PeterBee97/Gradesign/毕业论文/thuthesis-v6.0.2/data/denotation.tex

% !TeX root = ../main.tex

\begin{denotation}[3cm]
\item[ICRA] 国际机器人与自动化会议 (International Conference on Robotics and Automation)
\item[SEA] 串联弹性驱动 (Series-Elastic Actuation)
\item[SMA] 形状记忆合金 (Shape Memory Alloy)
\item[KV值] 每V电压对应无刷电机转数(rpm)
\item[BOM] 材料清单 (Bill Of Materials) 
\item[CNC] 数字控制加工
\item[EPFL] 瑞士洛桑联邦理工学院 
\item[FOC] 磁场定向控制 (Field Oriented Control)
\item[UART] 通用异步收发传输器 (Universal Asynchronous Receiver/Transmitter), 俗称串口通信
\item[PWM] 脉冲宽度调制(Pulse Width Modulation)
\item[MIPI] 移动产业处理器接口 (Mobile Industry Processor Interface) 
\item[PID] 比例积分微分
\item[UI] 用户界面 (User Interface) 
\item[CRC] 循环冗余校验 (Cyclic Redundancy Check)
\item[ABS] 丙烯腈-丁二烯-苯乙烯塑料 
\end{denotation}
