PeterBee97/Gradesign/毕业论文/thuthesis-v6.0.2/data/chap01.tex

% !TeX root = ../main.tex

\chapter{引言}
\label{cha:intro}

\section{研究背景}
近些年来，机器人研究的方向逐渐从大型机械、传统制造转向小型化、快速制造、精细控制、人机交互等方面，仿生设计也始终是热门关注点。传统的轮式机器人已经比较成熟，而不能满足复杂地形的需要，因此足式机器人引发了许多研究者的关注。这方面进展最快的莫过于四足机器人，上至波士顿动力的Spot机器狗\cite{Spot}，下至斯坦福本科生开发的低成本开源四足机器人Doggo\cite{Doggo}，大有全民机器狗之势。而其他形式的仿生机器人研究也并未式微，如普渡大学的机器蜂鸟\cite{Hummingbird}，斯坦福的单足跳跃机器人Salto-1P\cite{Salto1P}，都是小型机器人的优秀代表，后者更是亮相ICRA 2019，与众多机器狗同台竞技，业内人称“蒙特利尔动物园”。

\section{相关研究}
\label{sec:first}
\subsection{Salto}
本项目的直接灵感来自于Salto-1P。Salto-1P是来自加州大学伯克利分校仿生微系统实验室的跳跃机器人。
\begin{figure}[H]
  \centering
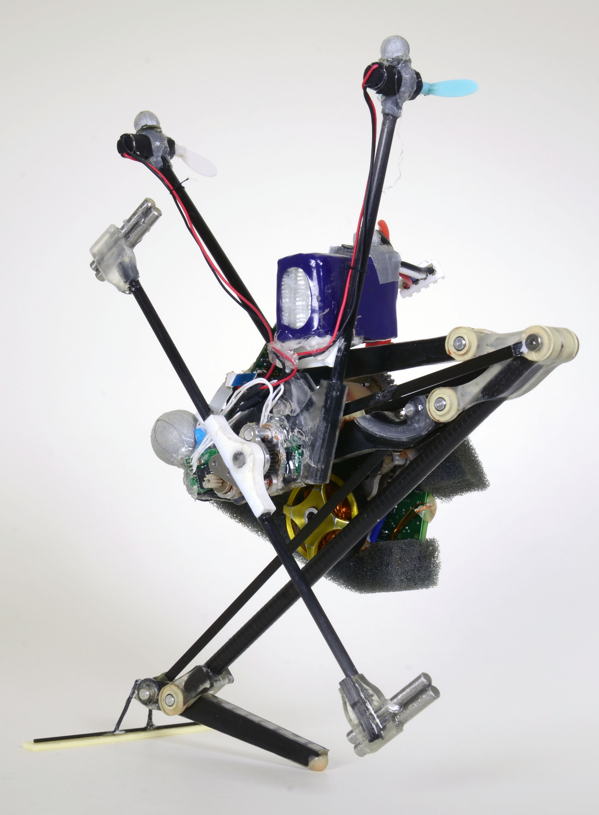
[picture p58: 毕业论文/thuthesis-v6.0.2/figures/Salto-1P.jpg]
  
  \caption{Salto-1P机器人\cite{Salto1P}}
  \label{fig:salto-1p}
\end{figure}
Salto-1P的主要特点是通过SEA驱动结构实现了能量的存储，以保证跳跃瞬间的能量爆发。它可以每0.58秒进行一次高度1m的连续跳跃，这样的敏捷性无疑是惊人的。初代Salto\cite{Salto}腿长约15cm，重约100g，能量密度137W/kg，各方面指标已经接近或超越其设计之初的模仿对象——自然界的夜猴。为了实现精确控制，Salto身上装备了用于控制姿态的尾部，Salto-1P还配备了一对螺旋桨。前者在研究中只进行一次跳跃，而后者由于通过两个螺旋桨控制横滚(Roll)和偏航(Yaw)，再加上尾部对俯仰(Pitch)的控制，实现了对空中身体姿态三个自由度的完全操控，因此可以做到连续跳跃。\\
对本项目的启示：
\begin{itemize}
  \item 本项目的弹跳部分设计参照了Salto腿部的机械模式，以提供有利于弹跳的机械增益曲线。
\end{itemize}
\subsection{Multimo-bat}
Multimo-bat多模态蝙蝠机器人是CMU机械系一位博士生2014年的作品。  
\begin{figure}[H]
  \centering
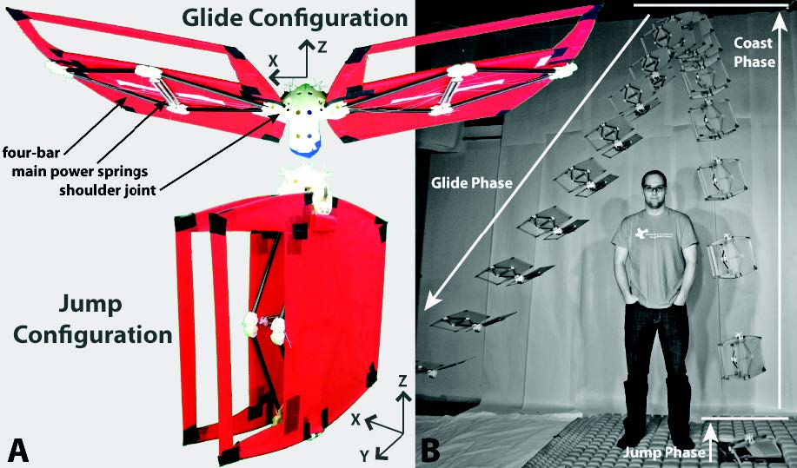
[picture p59: 毕业论文/thuthesis-v6.0.2/figures/Multimo-bat.jpg]
  
  \caption{Multimo-bat机器人\cite{multimo}}
  \label{fig:multimo}
\end{figure}
如图\ref{fig:multimo}所示，该机器人主要拥有两个形态：跳跃态和滑翔态。其主要结构由身体和四连杆可折叠机翼构成。一个完整的跳跃滑翔运动过程如下：
\begin{enumerate}
  \item 图\ref{fig:multimo_struct}(a)中的主电机转动带动图中白线拉紧，此时四连杆收缩，电能转化为翼上弹簧的弹性势能存储起来。当收紧到一定程度后，触发内部结构的离合装置，充能完毕。
  \item 图\ref{fig:multimo_struct}(b)中的SMA丝通电发热收缩拉动离合器解锁，机翼快速弹回原位，弹簧释放能量，机器人跳起。
  \item 当机器人跳至最高点时，张开机翼，进入无动力滑翔模式。
\end{enumerate}
对本项目的启示：
\begin{itemize}
  \item 该项目的整体功能与本项目目标基本相同，其滑翔模式下通过控制重心来调整机翼攻角而不增加自由度的思想可以简化系统设计，增加鲁棒性。
\end{itemize}
\begin{figure}[h]
  \centering%
  \begin{subfigure}{6cm}
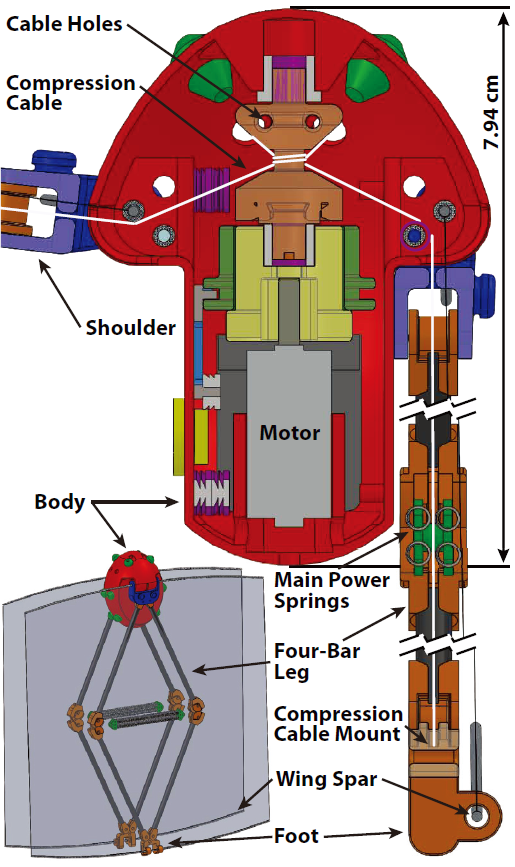
[picture p60: 毕业论文/thuthesis-v6.0.2/figures/Multimo-bat_Structure.png]
    
    \caption{整体结构}
  \end{subfigure}%
  \hspace{3em}%
  \begin{subfigure}{0.5\textwidth}
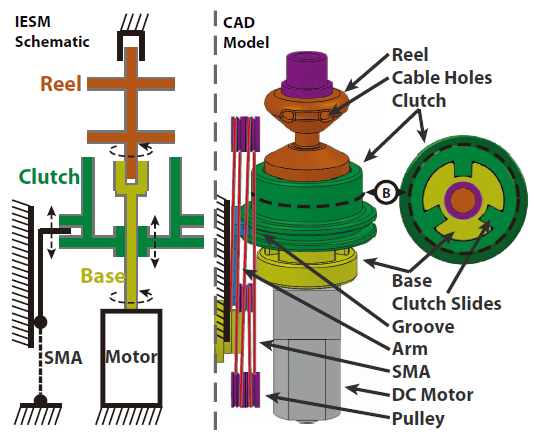
[picture p61: 毕业论文/thuthesis-v6.0.2/figures/Multimo-bat_Structure2.png]
    
    \caption{离合器}
  \end{subfigure}
  \caption{Multimo-bat主要结构\cite{multimo}}
  \label{fig:multimo_struct}
\end{figure}

\subsection{EPFL Jumpglider}
图\ref{fig:EPFL}是由瑞士洛桑联邦理工学院制作的Jumpglider机器人。
\begin{figure}[H]
  \centering
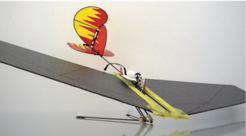
[picture p62: 毕业论文/thuthesis-v6.0.2/figures/EPFL.png]
  
  \caption{EPFL Jumpglider滑翔机器人\cite{EPFL}}
  \label{fig:EPFL}
\end{figure}
该机器人主要用于探究滑翔背后的数学原理，这也比较符合欧洲研究的一贯风格。该文章提出了三种仿生设计的折叠机翼原理，而最终得出结论固定翼滑翔距离较远。而出于仿生及紧致度的要求，固定翼方案不适用；本项目选择了蝴蝶式机翼收缩机制，以取得机械复杂度与鲁棒性的折衷。图\ref{fig:EPFL_leg}是EPFL对该机器人腿部的设计，大量使用塑料齿轮与铝合金构件与直流电机，由于该机器人使用场景为从高处下落，故这样的设计满足需求。但对于本项目而言，直流电机不足以提供足够原地起跳的爆发力，因此该设计仅供参考。
\begin{figure}[H]
  \centering
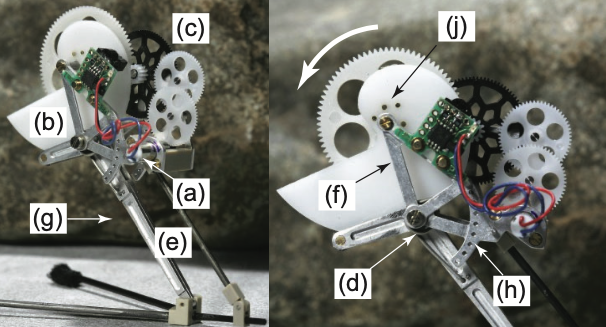
[picture p63: 毕业论文/thuthesis-v6.0.2/figures/EPFL_leg.png]
  
  \caption{Jumpglider腿部设计\cite{EPFL}}
  \label{fig:EPFL_leg}
\end{figure}
对本文的启示：
\begin{itemize}
  \item 分析比较了不同滑翔翼折叠机制的优劣；给出了一种弹射装置的参考设计。
\end{itemize}
