PeterBee97/Gradesign/毕业论文/thuthesis-v6.0.2/spine.tex

\documentclass[degree=master]{thuthesis}
\thusetup{
  author = {毕骏达},
  title  = {小型仿生跳跃滑翔运动装置}
}

\begin{document}

\spine % 使用默认标题和默认作者

\spine[小型仿生跳跃滑翔运动装置]

%\spine[同时修改标题和作者的标题][尼瑞薛]

% 中英文混合时需要微调
%\spine[清华大学学位 \raisebox{-5pt}{\LaTeX} 论文模板 \raisebox{-5pt}{v\version} 样例]
\end{document}
