PeterBee97/Gradesign/毕业论文/thuthesis-v6.0.2/data/acknowledgements.tex

% !TeX root = ../main.tex

\begin{acknowledgements}
  第一次独立挑战完整的系统设计项目，希望以此对本科期间学到的知识与技能做一个总结。虽然由于种种原因功能实现上留下了遗憾，但这个项目还是我心中本科毕业的里程碑。
  衷心感谢导师孙忆南老师对本项目的鼓励与指导。重点感谢我的父亲，是我制造机器人的得力助手，解决了许多加工问题。感谢母亲大人在疫情期间为我提供的后勤保障，使我可以安心完成毕业设计。感谢CMU仿生机器人实验室的李路前辈，在之前访学期间给予我的指导与帮助，没有那段经历就没有这个项目。感谢我的女朋友黄馨仪小可爱无时不在的精神支持！感谢实验中心全体老师，本科期间对我的实验能力的培养。特别感谢张寒学姐，对我的人生选择影响深远。感谢电子系科协，天空工场，和这一路遇到的所有同学，是你们让我成为了今天的自己。
  另外要感谢徐紫仪同学友情赠送的显卡，使得我的KVM黑苹果有了免驱的直通显卡，可以流畅地使用macOS编译\LaTeX{}，比Windows平台快了一倍。
\end{acknowledgements}
