PeterBee97/Gradesign/毕业论文/thuthesis-v6.0.2/thuthesis.pdf

# THUTHESIS：清华大学学位论文模板

## 薛瑞尼

## xueruini@gmail.com

v6.0.2 (2020/02/23)

摘要

此宏包旨在建立一个简单易用的清华大学学位论文模板，包括本科综合论文训练、硕士论文、博士论 文以及博士后出站报告。

免责声明

1. 本模板的发布遵守 LATEX Project Public License，使用前请认真阅读协议内容。
2. 本模板为作者根据清华大学教务处颁发的 《综合论文训练写作指南》，清华大学研究生院颁发 (http://www.law.tsinghua.edu.cn/publish/law/7024/2012/20120216153516317135347/20120216153516317135347_.html) 的《研究生学位论文写作指南》，清华大学 (http://yjsy.cic.tsinghua.edu.cn/docinfo/board/boarddetail.jsp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)《编写“清华大学博士后研究报告”参考意见》编 (http://postdoctor.tsinghua.edu.cn/info/czxz/1283) 写而成，旨在供清华大学毕业生撰写学位论文使用。
3. 清华大学教务处和研究生院只提供毕业论文写作指南，不提供官方模板，也不会授权第三方模 板为官方模板，所以此模板仅为写作指南的参考实现，不保证格式审查老师不提意见。任何由 于使用本模板而引起的论文格式审查问题均与本模板作者无关。
4. 任何个人或组织以本模板为基础进行修改、扩展而生成的新的专用模板，请严格遵守 LATEX Project Public License 协议。由于违犯协议而引起的任何纠纷争端均与本模板作者无关。

目录 | 目录
目录
1 模板介绍 | 3
2 安装 | 3
3 使用说明 | 5
4 致谢 | 22
5 实现细节 | 23
5.5.8 浮动对象以及表格 . . . . | 38
5.9.1 hyperref 宏包 . . . . | 64
5.9.3 longtable 宏包 . . . | 66
5.9.5 ntheorem 宏包 . . . . | 67
6 索引 | 67

2 安装

## 1 模板介绍

THUTHESIS (Tsinghua University LATEX Thesis Template) 是为了帮助清华大学毕业生撰写毕 业论文而编写的 LATEX 论文模板。
本文档将尽量完整的介绍模板的使用方法，如有不清楚之处，或者想提出改进建议，可以在 GitHub Issues (https://github.com/xueruini/thuthesis/issues/) 参与讨论或提问。有兴趣者都可以参与完善此手册，也非常欢迎对代码的贡献。 注意：模板的作用在于减少论文写作过程中格式调整的时间。前提是遵守模板的用法，否则 即便用了 THUTHESIS 也难以保证输出的论文符合学校规范。
用户如果遇到 bug，或者发现与学校《写作指南》的要求不一致，可以尝试以下办法：
1. 将模板升级到最新，见第 2.4 节；
2. 阅读 FAQ； (https://github.com/xueruini/thuthesis/wiki/FAQ)
3. 在 GitHub Issues 中按照说明 报告 bug。 (https://github.com/xueruini/thuthesis/issues/new?template=bug_report.md)

## 2 安装

THUTHESIS 已经包含在主要的 TEX 发行版中，但是通常版本较旧，而且不方便更新。建议使

### 用 GitHub 上的最新版：https://github.com/xueruini/thuthesis。

模板支持在 TeX Live、MacTeX 和 MiKTeX 平台下进行编译，但要求 2017 年或更新的发行 版。当然，尽可能使用最新的版本可以避免 bug。

### 2.1 模板的组成

下表列出了 THUTHESIS 的主要文件及其功能介绍：

文件（夹） | 功能描述
thuthesis.ins | DOCSTRIP 驱动文件（开发用）
thuthesis.dtx | DOCSTRIP 源文件（开发用）
thuthesis.cls | 模板类文件
thuthesis-numeric.bst | 参考文献样式文件
thuthesis-author-year.bst | 参考文献样式文件
thuthesis-bachelor.bst | 参考文献样式文件
tsinghua.pdf | 校名 logo，系统无隶书字体时使用
main.tex | 示例文档主文件
spine.tex | 书脊示例文档
ref/ | 示例文档参考文献目录
data/ | 示例文档章节具体内容
figures/ | 示例文档图片路径
thusetup.tex | 示例文档基本配置
Makefile | Makefile

2.2 生成模板 | 2 安装
文件（夹） | 功能描述
latexmkrc | latexmk 配置文件
README.md | Readme
thuthesis.pdf | 用户手册（本文档）

几点说明：

### - thuthesis.cls 可由 thuthesis.ins 和 thuthesis.dtx 生成，但为了降低新

手用户的使用难度，故将 thuthesis.cls 文件一起发布。

### - 使用前阅读文档：thuthesis.pdf。

### 2.2 生成模板

模板的源文件（thuthesis.dtx）中包含了大量的注释，需要将注释去掉生成轻量级的

### .cls 文件供 \documentclass 调用。

$ xetex thuthesis.ins

### 注意：如果没有生成的模板 thuthesis.cls 文件（跟 main.tex 同一目录下），LATEX

在编译时可能找到发行版中较旧版本的 .cls，从而造成冲突。

### 2.3 编译论文

本节介绍几种常见的生成论文的方法。用户可根据自己的情况选择。

### 2.3.1 GNU make

如果用户可以使用 GNU make 工具，这是最方便的办法。所以 THUTHESIS 提供了 Makefile：

$ make thesis | # 生成论文 main.pdf
$ make spine | # 生成书脊 spine.pdf
$ make doc | # 生成说明文档 thuthesis.pdf
$ make clean | # 清理编译生成的辅助文件

### 2.3.2 latexmk

latexmk 命令支持全自动生成 LATEX 编写的文档，并且支持使用不同的工具链来进行生成， 它会自动运行多次工具直到交叉引用都被解决。

$ latexmk main.tex | # 生成论文 main.pdf
$ latexmk spine.tex | # 生成书脊 spine.pdf
$ latexmk thuthesis.dtx # 生成说明文档 thuthesis.pdf
$ latexmk -c | # 清理编译生成的辅助文件

latexmk 的编译过程是通过 latexmk 文件来配置的，如果要进一步了解，可以参考 latexmk 的文档。

2.4 升级 | 3 使用说明

### 2.3.3 XƎLATEX

如果用户无法使用以上两种较为方便的编译方法，就只能按照以下复杂的办法手动编译。

$ xetex thuthesis.ins # 生成 thuthesis.cls
$ xelatex main.tex
$ bibtex main.tex | # 生成 bbl 文件
$ xelatex main.tex | # 解决引用
$ xelatex main.tex | # 生成完整的 pdf 文件

下面的命令用来生成用户手册，

$ xelatex thuthesis.dtx
$ makeindex -s gind.ist -o thuthesis.ind thuthesis.idx $ makeindex -s gglo.ist -o thuthesis.gls thuthesis.glo $ xelatex thuthesis.dtx
$ xelatex thuthesis.dtx # 生成说明文档 thuthesis.pdf

### 2.4 升级

如果需要升级THUTHESIS，应当从GitHub下载最新的版本，将thuthesis.dtx，thuthe-

### sis.ins，tsinghua.pdf 和 thuthesis-*.bst 拷贝至工作目录覆盖相应的文件，然后

按照第 2.2 节的内容生成新的模板和使用说明。
有时模板可能进行了重要的修改，不兼容已写好的正文内容，用户应按照示例文档重新调整。

## 3 使用说明

本手册假定用户已经能处理一般的 LATEX 文档，并对 BIBTEX 有一定了解。如果从未接触过 TEX 和 LATEX，建议先学习相关的基础知识。

### 3.1 示例文件

### 模板核心文件有：thuthesis.cls，thuthesis-numeric.bst，thuthesis-author-

year.bst 和 tsinghua.pdf，但如果没有示例文档会较难下手，所以推荐从模板自带的示 例文档入手。其中包括了论文写作用到的所有命令及其使用方法，只需用自己的内容进行相应替 换就可以。对于不清楚的命令可以查阅本手册。下面的例子描述了模板中章节的组织形式，来自 于示例文档，具体内容可以参考模板附带的 main.tex 和 data/。

% !TeX encoding = UTF-8
% !TeX program = xelatex
% !TeX spellcheck = en_US

\documentclass[degree=master,fontset=windows]{thuthesis} % 学位 degree:
% doctor | master | bachelor | postdoc
% 学位类型 degree-type:

3.1 示例文件 | 3 使用说明
% | academic（默认）| professional

% 论文基本配置，加载宏包等全局配置
\input{thusetup.tex}

\begin{document}

% 封面
\maketitle

% 使用授权的说明
\copyrightpage

\frontmatter
\input{data/abstract.tex}

% 目录
\tableofcontents

% 符号对照表
\input{data/denotation}

% 正文部分
\mainmatter
\input{data/chap01}
\input{data/chap02}

% 其它部分
\backmatter

%% 本科生要求的几个索引。
% \listoffigures | % 插图索引
% \listoftables | % 表格索引
% \listofequations | % 公式索引

% 参考文献
\bibliographystyle{thuthesis-numeric} | % 顺序编码制
% \bibliographystyle{thuthesis-author-year} | % 著者-出版年制
% \bibliographystyle{thuthesis-bachelor} | % 本科生参考文献的著录格式
\bibliography{ref/refs}

% 致谢

3.1 示例文件 | 3 使用说明

\input{data/acknowledgements}

% 声明
\statement

% 附录
\appendix
% \input{data/appendix-survey} | % 本科生：外文资料的调研阅读报告
% \input{data/appendix-translation} | % 本科生：外文资料的书面翻译
\input{data/appendix}

% 个人简历
\input{data/resume}

% 本科生的综合论文训练记录表
% \includepdf[pages=-]{scan-record.pdf}

\end{document}

其中 thusetup.tex 包括了论文基本信息的配置样例：

% !TeX root = ../main.tex

% 论文基本信息配置

\thusetup{
%****************************** % 注意：
% | 1. 配置里面不要出现空行
% | 2. 不需要的配置信息可以删除
%****************************** %
% 标题
% 可使用“\\”命令手动控制换行
%
title = {清华大学学位论文 \LaTeX{} 模板\\使用示例文档 v\version}, title* = {An Introduction to \LaTeX{} Thesis Template of Tsinghua University v\version},
%
% 学位
% | 1. 学术型
% | - 中文
% | 需注明所属的学科门类，例如：
% | 哲学、经济学、法学、教育学、文学、历史学、理学、工学、农学、医学、
% | 军事学、管理学、艺术学
% | - 英文
% | 博士：Doctor of Philosophy

3.1 示例文件 | 3 使用说明
% | 硕士：
% | 哲学、文学、历史学、法学、教育学、艺术学门类，公共管理学科
% | 填写“Master of Arts“，其它填写“Master of Science”
% | 2. 专业型
% | 直接填写专业学位的名称，例如：
% | 教育博士、工程硕士等
% | Doctor of Education, Master of Engineering
% | 3. 本科生不需要填写
%
degree-name = {工学硕士},
degree-name* = {Master of Science}, %
% 培养单位
% 填写所属院系的全名
%
department = {计算机科学与技术系},
%
% 学科
% | 1. 学术型学位
% | 获得一级学科授权的学科填写一级学科名称，其他填写二级学科名称
% | 2. 工程硕士
% | 工程领域名称
% | 3. 其他专业型学位
% | 不填写此项
% | 4. 本科生不需要填写
%
discipline = {计算机科学与技术},
discipline* = {Computer Science and Technology}, %
% 姓名
%
author = {薛瑞尼},
author* = {Xue Ruini},
%
% 指导教师
% 中文姓名和职称之间以英文逗号“,”分开，下同
%
supervisor = {郑纬民教授},
supervisor* = {Professor Zheng Weimin}, %
% 副指导教师
%
associate-supervisor = {陈文光教授}, associate-supervisor* = {Professor Chen Wenguang}, %
% 联合指导教师

3.1 示例文件 | 3 使用说明

%
% joint-supervisor = {某某某教授},
% joint-supervisor* = {Professor Mou Moumou}, %
% 日期
% 使用 ISO 格式；默认为当前时间
%
% date = {2019-07-07},
%
% 密级和年限
% 秘密, 机密, 绝密
%
% secret-level = {秘密},
% secret-year = {10},
%
% 博士后专有部分
%
% clc | = {分类号},
% udc | = {UDC},
% id | = {编号},
% discipline-level-1 = {计算机科学与技术}, % 流动站（一级学科）名称
% discipline-level-2 = {系统结构}, | % 专业（二级学科）名称
% start-date | = {2011-07-01}, | % 研究工作起始时间
}

%% Put any packages you would like to use here

% 表格中支持跨行
\usepackage{multirow}

% 跨页表格
\usepackage{longtable}

% 固定宽度的表格
\usepackage{tabularx}

% 表格中的反斜线
\usepackage{diagbox}

% 确定浮动对象的位置，可以使用 H，强制将浮动对象放到这里（可能效果很差） \usepackage{float}

% 浮动图形控制宏包。
% 允许上一个 section 的浮动图形出现在下一个 section 的开始部分 % 该宏包提供处理浮动对象的 \FloatBarrier 命令，使所有未处
% 理的浮动图形立即被处理。这三个宏包仅供参考，未必使用：

3.2 论文选项 | 3 使用说明

% \usepackage[below]{placeins}
% \usepackage{floatflt} % 图文混排用宏包
% \usepackage{rotating} % 图形和表格的控制旋转

% 定理类环境宏包
\usepackage[amsmath,thmmarks,hyperref]{ntheorem}

% 给自定义的宏后面自动加空白
% \usepackage{xspace}

% 借用 ltxdoc 里面的几个命令。
\def\cmd#1{\cs{\expandafter\cmd@to@cs\string#1}} \def\cmd@to@cs#1#2{\char\number`#2\relax} \DeclareRobustCommand\cs[1]{\texttt{\char`\\#1}}

\newcommand*{\meta}[1]{{%
\ensuremath{\langle}\rmfamily\itshape#1\/\ensuremath{\rangle}}} \providecommand\marg[1]{%
{\ttfamily\char`\{}\meta{#1}{\ttfamily\char`\}}} \providecommand\oarg[1]{%
{\ttfamily[}\meta{#1}{\ttfamily]}} \providecommand\parg[1]{%
{\ttfamily(}\meta{#1}{\ttfamily)}} \providecommand\pkg[1]{{\sffamily#1}}

% 定义所有的图片文件在 figures 子目录下
\graphicspath{{figures/}}

% 数学命令
\input{math_commands.tex}

% 定义自己常用的东西
% \def\myname{薛瑞尼}

% hyperref 宏包在最后调用
\usepackage{hyperref}

### 3.2 论文选项

degree | 选择学位，可选：bachelor，master，doctor（默认），postdoc。本节中的 key-value 选项只
能在文档类的选项中进行设置，不能用于 \thusetup 命令。

% 博士论文
\documentclass[degree=doctor]{thuthesis}

3.3 字体配置 | 3 使用说明

### 3.2.1 学位类型

定义研究生学位的类型，可选：academic（默认）、professional，本科生不受影响。

\documentclass[degree=master, degree-type=professional]{thuthesis}

language | 论文全文的主要语言。可选：chinese（默认），english。
注意，本科生《写作指南》要求“本科生 (含国外来华留学本科生) 非外语专业论文统一要求 用中文书写。”研究生《写作指南》要求“外国人来华留学生可以用英文撰写学位论文，但须采用 中文封面”，“除留学生外，学位论文一律须用汉语书写”，用户须提前与导师和院系的审查教师协 商使用何种语言书写论文。

\documentclass[degree=bachelor, language=english]{thuthesis}

### 3.3 字体配置

模板默认可以自动检测操作系统，并配置改平台上合适的字体，具体的配置策略如表 2。

表 2: THUTHESIS 自动配置字体策略
Windows | macOS | 其他

Times New Roman Times New Roman TeX Gyre Termes
Arial | Arial | TeX Gyre Heros
Courier | Menlo | TeX Gyre Cursor
中易宋体 | 华文宋体 | Fandol 宋体
中易黑体 | 华文黑体 | Fandol 黑体

然而自动配置的字体只能保证编译通过，但是还存在一些问题：
1. 在其他平台上配置的 TeX Gyre 系列字体，虽然在风格上比较接近 Times 和 Arial，但是毕 竟跟《写作指南》要求的字体不完全一致；
2. Fandol 字库的字形较少，常常出现缺字的情况；
3. 华文字库和 Fandol 字库虽然不违反《写作指南》的要求，但是其字形跟中易字库有所差别， 这导致封面、标题的视觉效果与学校的 Word 示例不一致，可能被审查老师认为格式不符合 要求。
所以建议在提交最终版前使用 Windows 平台的字体进行编译。
用户也可以在调用 THUTHESIS 时手动指定使用的字库，如：

\documentclass[fontset=windows]{thuthesis}

允许的选项有 windows、mac、fandol，详见 ctex、xeCJK、fontspec 等宏包的使用说 明。

### 3.4 封面信息

封面信息可以通过统一设置命令 \thusetup 设置 key=value 形式完成；带 * 号的键通常是 对应的英文。

3.4 封面信息 | 3 使用说明

\thusetup 用法与常见 key=value 命令相同，如下：
\thusetup
\thusetup{
key1 = value1,
key2 = {a value, with comma}, }
% 可以多次调用
\thusetup{
key3 = value3,
key1 = value11, % 覆盖 value1
}

注意：\thusetup 使用 kvsetkeys 机制，所以配置项之间不能有空行，否则会报错。

### 3.4.1 论文标题

中英文标题。可以在标题内部使用换行\\。

\thusetup{
title = {论文中文题目},
title* = {Thesis English Title}, }

### 3.4.2 申请学位名称

学位的设置要复杂一些：

学位类型 | degree-name | degree-name*
学术型博士 | 需注明所属的学科门类，例如：哲学、 经济学、法学、教育学、文学、历史学、 理学、工学、农学、医学、军事学、管 理学、艺术学 | Doctor of Philosophy
学术型硕士 | 同上 | 哲学、文学、历史学、法学、教育学、艺 术学门类，公共管理学科填写“Master of Arts“，其它填写“Master of Science”
专业型研究 生学位 | 专业学位的名称，例如：教育博士、工 程硕士 | 专业学位的名称，例如：Doctor of Ed- ucation, Master of Engineering
本科生 | - | -

\thusetup{
degree-name = {您要申请什么学位},
degree-name* = {Degree in English}, }

3.4 封面信息 | 3 使用说明

### 3.4.3 院系名称

院系名称。

\thusetup{
department = {系名全称},
}

### 3.4.4 学科名称

- 学术型学位：获得一级学科授权的学科填写一级学科名称，其他填写二级学科名称；
- 工程硕士：工程领域名称；
- 其他专业型学位：-
- 本科生：-

\thusetup{
discipline = {学科名称},
discipline* = {Discipline in English}, }

### 3.4.5 作者姓名

作者姓名。

\thusetup{
author = {中文姓名},
author* = {Name in Pinyin}, }

### 3.4.6 导师

导师 | 导师的姓名与职称之间以“,”（西文逗号，U+002C）隔开，下同。
| \thusetup{ supervisor = {导师姓名, 教授}, supervisor* = {Supervisor Name, Professor},

}

副导师 | 本科生的辅导教师，硕士的副指导教师。
| \thusetup{ associate-supervisor = {副导师姓名, 副教授}, associate-supervisor* = {Assoc-Supervisor Name, Professor},

}

联合导师 | 硕士生联合指导教师，博士生联合导师。
| \thusetup{ joint-supervisor = {联合导师姓名, 教授},

3.5 前言部分 | 3 使用说明

joint-supervisor* = {Join-Supervisor Name, Professor},
}

### 3.4.7 成文日期

默认为当前日期，也可以自己指定，要求使用 ISO 格式。

\thusetup{
date = {2011-07-01},
}

### 3.4.8 密级

定义秘密级别和年限。

\thusetup{
secret-year = 10,
secret-level = {内部},
}

### 3.4.9 博士后专用参数

\thusetup{
clc | = {分类号},
udc | = {udc},
id | = {id},
discipline-level-1 = {流动站（一级学科）名称}, discipline-level-2 = {专业（二级学科）名称},
start-date | = {2011-07-01}, % 研究工作起始时间
}
生成封面 | 生成封面，不含授权说明，摘要等。
\maketitle | % 直接生成封面

\maketitle

### 3.5 前言部分

### 3.5.1 授权说明

授权说明 | 生成授权说明。用法：\copyrightpage[⟨file⟩]。可选参数为扫描得到的 PDF 文件名，例
\copyrightpage | 如：

% 将签字扫描后授权文件 scan-auth.pdf 替换原始页面 \copyrightpage[scan-auth.pdf]

3.5 前言部分 | 3 使用说明

### 3.5.2 摘要

abstract 摘要正文

### abstract* 摘要直接在正文中使用 abstract、abstract* 环境生成。

\begin{abstract}
摘要请写在这里...
\end{abstract}

\begin{abstract*}
Here comes the abstract in English... \end{abstract*}
关键词 | 关键词需要使用 \thusetup 进行设置。关键词之间以西文逗号隔开，模板会自动调整为要
求的格式。关键词的设置只要在摘要环境结束前即可。

\thusetup{
keywords = {关键词 1, 关键词 2}, keywords* = {keyword 1, keyword 2},
}

### 3.5.3 目录和索引表

目录、插图、表格和公式等索引命令分别如下，将其插入到期望的位置即可（带 * 的命令表 示对应的索引表不会出现在目录中）：

\tableofcontents
\listoffigures
\listoffigures*
\listoftables
\listoftables*
\listofequations
\listofequations*
用途 | 命令
目录 | \tableofcontents

### 插图索引 \listoffigures

| \listoffigures*

### 表格索引 \listoftables

| \listoftables*

### 公式索引 \listofequations

| \listofequations*

LATEX 默认支持插图和表格索引，是通过 \caption 命令完成的，因此它们必须出现在浮动 环境中，否则不被计数。
如果不想让某个表格或者图片出现在索引里面，那么请使用命令 \caption*，这个命令不 会给表格编号，也就是出来的只有标题文字而没有“表 xx”，“图 xx”，否则索引里面序号不连续 就显得不伦不类，这也是 LATEX 里星号命令默认的规则。 有这种需求的多是本科同学的英文资料翻译部分，如果你觉得附录中英文原文中的表格和图 片显示成“表”和“图”很不协调的话，一个很好的办法还是用 \caption*，参数随便自己写，

3.5 前言部分 | 3 使用说明

具体用法请参看示例文档。
如果的确想让其编号，但又不想出现在索引中的话，目前模板暂不支持。 公式索引为本模板扩展，模板扩展了 amsmath 几个内部命令，使得公式编号样式和自动索 引功能非常方便。一般来说，你用到的所有数学环境编号都没问题了，这个可以参看示例文档。如 果你有个非常特殊的数学环境需要加入公式索引，那么请使用 \equcaption{⟨编号⟩}。此命 令表示 equation caption，带一个参数，即显示在索引中的编号。因为公式与图表不同，我们很 少给一个公式附加一个标题，之所以起这么个名字是因为图表就是通过 \caption 加入索引的， \equcaption 完全就是为了生成公式列表，不产生什么标题。
使用方法如下。假如有一个非 equation 数学环境 mymath，只要在其中写一句 \equcaption 就可以将它加入公式列表。

\begin{mymath}
\label{eq:emc2}\equcaption{\ref{eq:emc2}} E=mc^2
\end{mymath}

mymath 中公式的编号需要自己来做。
同图表一样，附录中的公式有时也不希望它跟全文统一编号，而且不希望它出现在公式索引 中。目前的办法是利用 \tag*{⟨公式编号⟩} 来解决。用法比较简单，此处不再罗嗦，实例请参 看示例文档附录 A 的前两个公式。

### 3.5.4 符号对照表

denotation | 主要符号表环境，跟 description 类似，使用方法参见示例文件。带一个可选参数，用
来指定符号列的宽度（默认为 2.5cm）。

\begin{denotation}
\item[E] 能量
\item[m] 质量
\item[c] 光速
\end{denotation}

如果默认符号列的宽度不满意，可以通过参数来调整：

\begin{denotation}[1.5cm] % 设置为 1.5cm \item[E] 能量
\item[m] 质量
\item[c] 光速
\end{denotation}

符号对照表的另外一种方法是调用 nomencl 宏包，需要在导言区设置：

\usepackage{nomencl}
\makenomenclature

然后在正文中任意位置使用 \nomenclature 声明需要添加到主要符号表的符号：

\nomenclature{$m$}{The mass of one angel}

3.6 正文部分 | | | | | | 3 使用说明

### 最后使用 \printnomenclature 命令生成符号表。更详细的使用方法参见 nomencl

宏包的文档。

### 3.6 正文部分

### 3.6.1 数学环境

THUTHESIS 定义了常用的数学环境：

axiom theorem | definition proposition lemma | conjecture
公理 | 定理 | 定义 | 命题 | 引理 | 猜想
proof | corollary example | exercise | assumption remark | problem
证明 | 推论 | 例子 | 练习 | 假设 | 注释 | 问题

比如：

\begin{definition}
道千乘之国，敬事而信，节用而爱人，使民以时。
\end{definition}

产生（自动编号）：

定义 1.1 道千乘之国，敬事而信，节用而爱人，使民以时。

列举出来的数学环境毕竟是有限的，如果想用胡说这样的数学环境，那么可以定义：

\newtheorem{nonsense}{胡说}[chapter]

然后这样使用：

\begin{nonsense}
契丹武士要来中原夺武林秘笈。—— 慕容博
\end{nonsense}

产生（自动编号）：

胡说 1.1 契丹武士要来中原夺武林秘笈。——慕容博

### 3.6.2 列表环境

itemize | 为了适合中文习惯，模板将这三个常用的列表环境用 enumitem 进行了纵向间距压缩。一

enumerate
description

方面清除了多余空间，另一方面用户可以自己指定列表环境的样式（如标签符号，缩进等）。细节 请参看 enumitem 文档，此处不再赘述。

### 3.6.3 引用方式

模板支持两种引用方式，分别为理工科常用的“顺序编码制”和文科常用的“著者-出版年制”。 使用者在设置参考文献表的格式（\bibliographystyle，见第 3.7.1 节）时，正文中引用文 献的标注会自动调整为对应的格式。

3.7 其他部分 | 3 使用说明

顺序编码制 顺序编码制的参考文献引用分为两种模式：
\inlinecite 1. 上标模式，比如“同样的工作有很多[1-2]……”；
2. 正文模式，比如“文 [3] 中详细说明了……”。
cite-style | 用户可以将引用标注的格式设为正文模式：

\thusetup{
cite-style = inline,
}

也可以使用 \inlinecite{⟨key⟩} 临时使用正文模式的引用标注。

著者-出版年制 著者-出版年制的参考文献引用有三种模式：
1. \citep：著者与年份均在括号中，比如“(Zhang, 2008)”，同默认的 \cite 命令；
2. \citet：著者姓名作为正文的一部分，比如“Zhang (2008)”；
3. \citeyear：只插入年份，但不含括号，比如“2008”。 关于参考文献引用的更多细节参考 natbib 的文档。

### 3.7 其他部分

### 3.7.1 参考文献

模板支持使用 BIBTEX 处理生成参考文献表，用户需要在文中设置参考文献格式并调用 .bib 数据库：

\bibliographystyle{thuthesis-numeric} | % 顺序编码制
% \bibliographystyle{thuthesis-author-year} | % 著者-出版年制
% \bibliographystyle{thuthesis-bachelor} | % 本科生参考文献的著录格式
\bibliography{ref1,ref2} | % 载入 ref1.bib 和 ref2.bib

### 注意：\bibliographystyle 命令只能出现一次。

BIBTEX 可以自动识别数据库中每条文献的语言，并自动处理文献类型和载体类型标识，用户 也可以手动指定，如：

@misc{citekey,
language = {japanese},
mark | = {Z},
medium | = {DK},
}

可选的语言有 english, chinese, japanese 和 russian。 国标规定参考文献表采用“著者-出版年”制组织时，各篇文献首先按文种集中，然后按著者 字顺和出版年排列；中文文献可以按著者汉语拼音字顺排列，也可以按著者的笔画笔顺排列。由 于 BIBTEX 功能的局限性，无法自动获取著者姓名的拼音或笔画笔顺，所以必须在 .bib 数据库中 的 key 字段手动录入著者姓名的拼音，如：

3.7 其他部分 | 3 使用说明

@book{capital,
author = {马克思 and 恩格斯},
key | = {ma3 ke4 si1 | en1 ge2 si1}, % 名字之间用 2 或 3 个空格
}

BIBTEX 对自定义样式的支持比较有限，所以用户只能通过修改 bst 文件来修改文献列表的 格式。本宏包提供了一些接口供用户更方便地修改，在 bst 文件开始处的 load.config 函数 中，有一组配置参数用来控制样式。若变量被设为 #1 则表示该项被启用，设为 #0 则不启用。默 认的值是严格遵循学校规定的配置。

### 3.7.2 致谢

acknowledgement | 把致谢做成一个环境更好一些，直接往里面写感谢的话就可以啦。

\begin{acknowledgements}
…
还要特别感谢 \thuthesis{} 节省了论文排版时间！ \end{acknowledgements}

### 3.7.3 声明

如果使用声明扫描页，将可选参数指定为扫描后的 PDF 文件名，例如： \statement
\statement[scan-statement.pdf]

### 3.7.4 附录

附录由 \appendix 命令开启，然后像正文一样书写。

\appendix
\chapter{...}
toc-depth | 一些院系要求目录中只出现附录的章标题，不出现附录中的一级、二级节标题。模板默认如
此设置，用户也可以在 \appendix 命令后手动控制加入目录的标题层级，其中 0 表示章标题， 1 表示一级节标题，以此类推。

\appendix
\thusetup{toc-depth=0} | % 目录只出现章标题
survey | 本科生《写作指南》要求附录 A 为外文资料的调研阅读报告或书面翻译，二者择一。调研报
translation 告（或书面翻译）的题目和参考文献是独立于论文的，相当一篇独立的小文章，所以模板相应定 义了 survey 和 translation。在这两个环境内部可以像论文正文一样使用标题和参考文献 的命令，但不会影响外部：

\begin{survey}
\title{...}

3.7 其他部分 | 3 使用说明

\maketitle
... \cite{...}
\bibliographystyle{...}
\bibliography{...}
\end{survey}

书面翻译对应的原文索引的实际作用更接近参考文献，所以也用参考文献的机制来生成，但 是在正文中并不引用。

\begin{translation}
... \nocite{...}
\bibliographystyle{...}
\bibliography{...}
\end{translation}

### 3.7.5 简历

resume | 开启个人简历章节，包括个人简历，发表文章，研究成果列表等。每个子项目请用以下对应
| 命令开启：\xxxitem{⟨subtitle⟩}。
| 个人简历，用法：\resumeitem{个人简历}。简历内容部分没有格式要求，正常段落排版。
\resumeitem | 发表学术论文，用法：\researchitem{⟨类别⟩}，包括“学术论文”和“研究成果”两个
\researchitem | 类别。分别用 publications 和 achievements 罗列。
publications | 用 publications 环境进行罗列发表的论文。按照学校要求，在学期间发表的学术论文分
\publicationskip | 以下三部分按顺序分别列出，每部分之间空 1 行，序号可连续排列：
1. 已经刊载的学术论文（本人是第一作者，或者导师为第一作者本人是第二作者）
2. 尚未刊载，但已经接到正式录用函的学术论文（本人为第一作者，或者导师为第一作者本人
| 是第二作者）。
3. 其他学术论文。可列出除上述两种情况以外的其他学术论文，但必须是已经刊载或者收到正
| 式录用函的论文。
| publications 环境支持每一部分分别编写，逻辑上更清楚，为了在环境之间支持空行，
| 需要利用 \publicationskip 控制。示例：
| \researchitem{发表的学术论文}
| % 1. 已经刊载的学术论文
| \begin{publications}
| \item Yang Y, Ren T L, Zhang L T, et al. Miniature microphone with
| silicon-based ferroelectric thin films. Integrated Ferroelectrics,
| 2003, 52:229-235. (SCI 收录, 检索号:758FZ.)
| \item 杨轶, 张宁欣, 任天令, 等. 硅基铁电微声学器件中薄膜残余应力的研究. 中国机
| 械工程, 2005, 16(14):1289-1291. (EI 收录, 检索号:0534931 2907.)
| \item 杨轶, 张宁欣, 任天令, 等. 集成铁电器件中的关键工艺研究. 仪器仪表学报,
| 2003, 24(S4):192-193. (EI 源刊.)
| \end{publications}

3.8 书脊 | 3 使用说明

% 2. 尚未刊载，但已经接到正式录用函的学术论文
\begin{publications}[before=\publicationskip,after=\publicationskip] \item Yang Y, Ren T L, Zhu Y P, et al. PMUTs for handwriting recognition. In press. (已被 Integrated Ferroelectrics 录用. SCI 源刊.) \end{publications}

% 3. 其他学术论文。
\begin{publications}
\item Wu X M, Yang Y, Cai J, et al. Measurements of ferroelectric MEMS microphones. Integrated Ferroelectrics, 2005, 69:417-429. (SCI 收录, 检索号:896KM)
\item 贾泽, 杨轶, 陈兢, 等. 用于压电和电容微麦克风的体硅腐蚀相关研究. 压电与声 光, 2006, 28(1):117-119. (EI 收录, 检索号:06129773469)
\item 伍晓明, 杨轶, 张宁欣, 等. 基于MEMS技术的集成铁电硅微麦克风. 中国集成电路, 2003, 53:59-61.
\end{publications}

### achievements 研究成果用 \researchitem{研究成果} 开启，随后用 achievements 环境罗列。 具体用法请参看示例文档 data/resume.tex。

### 3.8 书脊

生成装订的书脊，为竖排格式，命令格式：\spine[⟨标题⟩][⟨作者⟩]。默认参数为论文中 \spine 文题目和中文作者。如果中文题目中没有英文字母，那么直接调用此命令即可。否则，可参考参

看模板示例文件 spine.tex 进行微调：

\documentclass[degree=master]{thuthesis}

\thusetup{
author = {薛瑞尼},
title = {没有英文的中文标题}
}

\begin{document}

\spine % 使用默认标题和默认作者

\spine[使用默认作者的标题]

\spine[同时修改标题和作者的标题][尼瑞薛]

% 中英文混合时需要微调
\spine[清华大学学位 \raisebox{-5pt}{\LaTeX} 论文模板 \raisebox{-5pt}{v\version } 样例]
\end{document}

4 致谢

## 4 致谢

感谢这些年来一直陪伴 THUTHESIS 成长的新老同学！ 欢迎各位到 THUTHESIS GitHub 主页贡献！ (http://github.com/xueruini/thuthesis/)

5 实现细节

## 5 实现细节

### 5.1 基本信息

1 ⟨cls⟩\NeedsTeXFormat{LaTeX2e}
2 ⟨cls⟩\ProvidesClass{thuthesis}
3 ⟨cls⟩[2020/02/23 6.0.2 Tsinghua University Thesis Template]

检查编译引擎，要求使用 XƎLATEX。
4 \RequirePackage{ifxetex}
5 \RequireXeTeX

### 5.2 定义选项

定义论文类型以及是否涉密

6 ⟨*cls⟩
7 \hyphenation{Thu-Thesis}
8 \def\thuthesis{ThuThesis}
9 \def\version{6.0.2}
10 \RequirePackage{kvdefinekeys} 11 \RequirePackage{kvsetkeys} 12 \RequirePackage{kvoptions} 13 \SetupKeyvalOptions{
14 | family=thu,
15 | prefix=thu@,
16 | setkeys=\kvsetkeys}
| 用 kvoptions 的 key=value 方式来设置论文类型。

17 \newcommand\thu@error[1]{%
18 \ClassError{thuthesis}{#1}{}%

19 }

\thusetup 提供一个 \thusetup 命令支持 key-value 的方式来设置。

20 \newcommand\thusetup{%
21 \kvsetkeys{thu}%

22 }

| 同时用 key-value 的方式来定义这些接口：

\thu@define@key{
| <key> = {
| name = <name>,
| choices = {
| <choice1>,
| <choice2>,
| },
| default = <default>,
| code = <code>,
| },

5.2 定义选项 | 5 实现细节

}

其中 choices 设置允许使用的值，默认为第一个（或者 ⟨default⟩）；⟨code⟩ 是相应的内容被 设置时执行的代码。

23 \newcommand\thu@define@key[1]{%
24 \kvsetkeys{thu@key}{#1}%

25 }
26 \kv@set@family@handler{thu@key}{%

\thusetup 会将 ⟨value⟩ 存到 \thu@⟨key⟩，但是宏的名字包含“-”这样的特殊字符时 不方便直接调用，比如 key = math-style，这时可以用 name 设置 ⟨key⟩ 的别称，比如

### key = math@style，这样就可以通过 \thu@math@style 来引用。default 是定义该

⟨key⟩ 时默认的值，缺省为空。

27 | \@namedef{thu@#1@@name}{#1}%
28 | \def\thu@@default{}%
29 | \def\thu@@choices{}%
30 | \kv@define@key{thu@value}{name}{%
31 | \@namedef{thu@#1@@name}{##1}%
32 | }%
33 | \kv@define@key{thu@value}{code}{%
34 | \@namedef{thu@#1@@code}{##1}%
35 | }%

由于在定义接口时，\thu@⟨key⟩@@code 不一定有定义，而且在文档类/宏包中还有可能 对该 key 的 code 进行添加。所以 \thu@⟨key⟩@@code 会检查如果在定义文档类/宏包时则 推迟执行，否则立即执行。

36 | \@namedef{thu@#1@@check}{}%
37 | \@namedef{thu@#1@@code}{}%
38 | \@namedef{thu@#1@@hook}{%
39 | \expandafter\ifx\csname\@currname.\@currext-h@@k\endcsname\relax
40 | \@nameuse{thu@#1@@code}%
41 | \else
42 | \AtEndOfClass{%
43 | \@nameuse{thu@#1@@code}%
44 | }%
45 | \fi
46 | }%

保存下 choices = {} 定义的内容，在定义 \thu@⟨name⟩ 后再执行。

47 | \kv@define@key{thu@value}{choices}{%
48 | \def\thu@@choices{##1}%
49 | \@namedef{thu@#1@@reset}{}%

### \thu@⟨key⟩@check 检查 value 是否有效，并设置 \ifthu@⟨name⟩@⟨value⟩。

50 | \@namedef{thu@#1@@check}{%
51 | \@ifundefined{%

5.2 定义选项 | 5 实现细节
52 | ifthu@\@nameuse{thu@#1@@name}@\@nameuse{thu@\@nameuse{thu@#1@@name}}%
53 | }{%
54 | \thu@error{Invalid value "#1 = \@nameuse{thu@\@nameuse{thu@#1@@name}}"}%
55 | }%
56 | \@nameuse{thu@#1@@reset}%
57 | \@nameuse{thu@\@nameuse{thu@#1@@name}@\@nameuse{thu@\@nameuse{thu@#1@@name}}true}%
58 | }%
59 | }%
60 | \kv@define@key{thu@value}{default}{%
61 | \def\thu@@default{##1}%
62 | }%
63 | \kvsetkeys{thu@value}{#2}%
64 | \@namedef{thu@\@nameuse{thu@#1@@name}}{}%

第一个 ⟨choice⟩ 设为 ⟨default⟩，并且对每个 ⟨choice⟩ 定义 \ifthu@⟨name⟩@⟨choice⟩。

65 | \kv@set@family@handler{thu@choice}{%
66 | \ifx\thu@@default\@empty
67 | \def\thu@@default{##1}%
68 | \fi
69 | \expandafter\newif\csname ifthu@\@nameuse{thu@#1@@name}@##1\endcsname
70 | \expandafter\g@addto@macro\csname thu@#1@@reset\endcsname{%
71 | \@nameuse{thu@\@nameuse{thu@#1@@name}@##1false}%
72 | }%
73 | }%
74 | \kvsetkeys@expandafter{thu@choice}{\thu@@choices}%

将 ⟨default⟩ 赋值到 \thu@⟨name⟩，如果非空则执行相应的代码。

75 | \expandafter\let\csname thu@\@nameuse{thu@#1@@name}\endcsname\thu@@default
76 | \expandafter\ifx\csname thu@\@nameuse{thu@#1@@name}\endcsname\@empty\else
77 | \@nameuse{thu@#1@@check}%
78 | \@nameuse{thu@#1@@hook}%
79 | \fi

### 定义 \thusetup 接口。

80 | \kv@define@key{thu}{#1}{%
81 | \@namedef{thu@\@nameuse{thu@#1@@name}}{##1}%
82 | \@nameuse{thu@#1@@check}%
83 | \@nameuse{thu@#1@@hook}%
84 | }%

85 }

定义接口向 key 添加 code：

86 \newcommand\thu@addto[2]{%
87 \expandafter\g@addto@macro\csname thu@#1@@code\endcsname{#2}%

88 }

89 \newif\ifthu@degree@graduate
90 \newcommand\thu@set@graduate{%

5.2 定义选项 | 5 实现细节
91 | \thu@degree@graduatefalse
92 | \ifthu@degree@doctor
93 | \thu@degree@graduatetrue
94 | \fi
95 | \ifthu@degree@master
96 | \thu@degree@graduatetrue
97 | \fi

98 }
99 \thu@define@key{
100 | degree = {
101 | choices = {
102 | bachelor,
103 | master,
104 | doctor,
105 | postdoc,
106 | },
107 | default = doctor,
108 | code = {\thu@set@graduate},
109 | },
110 | degree-type = {
111 | choices = {
112 | academic,
113 | professional,
114 | },
115 | name = degree@type,
116 | },

论文是否使用英文。
117 | language = {
118 | choices = {
119 | chinese,
120 | english,
121 | },
122 | },

123 }

raggedbottom 选项（默认打开）
124 \DeclareBoolOption[true]{raggedbottom}

### 将选项传递给 ctexbook。

125 \DeclareDefaultOption{\PassOptionsToClass{\CurrentOption}{ctexbook}} 解析用户传递过来的选项，并加载 ctexbook。

126 \ProcessKeyvalOptions*

### 使用 ctexbook 类，优于调用 ctex 宏包。

127 \PassOptionsToPackage{quiet}{xeCJK}
128 \LoadClass[a4paper,openany,UTF8,zihao=-4,scheme=plain]{ctexbook}

5.3 装载宏包 | 5 实现细节

### 5.3 装载宏包

引用的宏包和相应的定义。
129 \RequirePackage{etoolbox}
130 \RequirePackage{xparse}

AℳS-TEX 宏包，用来排出更加漂亮的公式。
131 \RequirePackage{amsmath}

### 使用 unicode-math 处理数学字体。

132 \RequirePackage{unicode-math}

图形支持宏包。
133 \RequirePackage{graphicx}

### 并排图形。subfigure、subfig 已经不再推荐，用新的 subcaption。浮动图形和表格

标题样式。caption2 已经不推荐使用，采用新的 caption。

134 \RequirePackage[labelformat=simple]{subcaption}
pdfpages 宏包便于我们插入扫描后的授权说明和声明页 PDF 文档。

135 \RequirePackage{pdfpages}
136 \includepdfset{fitpaper=true}

更好的列表环境。
137 \RequirePackage[shortlabels]{enumitem}
138 \RequirePackage{environ}

禁止 LATEX 自动调整多余的页面底部空白，并保持脚注仍然在底部。脚注按页编号。 139 \ifthu@raggedbottom
140 | \RequirePackage[bottom,perpage,hang]{footmisc}
141 | \raggedbottom
142 \else
143 \RequirePackage[perpage,hang]{footmisc}

144 \fi
利用xeCJKfntef实现汉字的下划线和盒子内两段对齐，并可以避免\makebox[⟨width⟩][⟨s⟩] 可能产生的 underful boxes。
145 \RequirePackage{xeCJKfntef}

表格控制
146 \RequirePackage{array}

### 使用三线表：\toprule，\midrule，\bottomrule。

147 \RequirePackage{booktabs}

参考文献引用宏包。
148 \RequirePackage[sort&compress]{natbib} 149 \RequirePackage{bibunits}

150 \RequirePackage{url}

5.4 页面设置 | 5 实现细节

设置 url 样式，与上下文一致
151 \urlstyle{same}
使用 xurl 的方法，增加 URL 可断行的位置。

152 \g@addto@macro\UrlBreaks{%
153 | \do0\do1\do2\do3\do4\do5\do6\do7\do8\do9%
154 | \do\A\do\B\do\C\do\D\do\E\do\F\do\G\do\H\do\I\do\J\do\K\do\L\do\M
155 | \do\N\do\O\do\P\do\Q\do\R\do\S\do\T\do\U\do\V\do\W\do\X\do\Y\do\Z
156 | \do\a\do\b\do\c\do\d\do\e\do\f\do\g\do\h\do\i\do\j\do\k\do\l\do\m
157 | \do\n\do\o\do\p\do\q\do\r\do\s\do\t\do\u\do\v\do\w\do\x\do\y\do\z

158 }
159 \Urlmuskip=0mu plus 0.1mu

### 5.4 页面设置

研究生《写作指南》：页边距：上下左右均为 3.0 厘米，装订线 0 厘米；页眉距边界：2.2 厘 米，页脚距边界：2.2 厘米。
本科生《写作指南》：页边距：上：3.8 厘米，下：3.2 厘米，左右：3 厘米，装订线：左 0.2 厘 米。本科生 Word 模板：页眉距边界：1.5 厘米，页脚距边界：1.75 厘米。

160 \RequirePackage{geometry}
161 \geometry{
162 | a4paper, % 210 * 297mm
163 | nomarginpar,

164 }
165 \ifthu@degree@bachelor
166 | \geometry{
167 | top | = 3.8cm,
168 | bottom | = 3.2cm,
169 | left | = 3.2cm,
170 | right | = 3cm,
171 | headheight = 0.5cm,
172 | headsep | = 1.8cm,
173 | footskip | = 1.45cm,
174 | }
175 \else
176 | \geometry{
177 | margin | = 3cm,
178 | headheight = 0.5cm,
179 | headsep | = 0.3cm,
180 | footskip | = 0.8cm,
181 | }

182 \fi

利用 fancyhdr 设置页眉页脚。

183 \RequirePackage{fancyhdr}

5.5 主文档格式 | 5 实现细节

利用 notoccite 避免目录中引用编号混乱。

184 \RequirePackage{notoccite}

### 5.5 主文档格式

### 5.5.1 Three matters

\cleardoublepage 对于 openright 选项，必须保证章首页右开，且如果前章末页无内容须清空其页眉页脚。 185 \let\thu@cleardoublepage\cleardoublepage
186 \newcommand{\thu@clearemptydoublepage}{%
187 \clearpage{\pagestyle{thu@empty}\thu@cleardoublepage}} 188 \let\cleardoublepage\thu@clearemptydoublepage

\frontmatter
\mainmatter
\backmatter

我们的单面和双面模式与常规的不太一样。
189 \renewcommand\frontmatter{%
190 | \if@openright\cleardoublepage\else\clearpage\fi
191 | \@mainmatterfalse
192 | \ifthu@degree@bachelor
193 | \pagestyle{thu@plain}
194 | \else
195 | \pagestyle{thu@headings}
196 | \fi
197 | \pagenumbering{Roman}%
198 | \let\@tabular\thu@tabular

199 }
200 \renewcommand\mainmatter{%
201 | \if@openright\cleardoublepage\else\clearpage\fi
202 | \@mainmattertrue
203 | \pagenumbering{arabic}
204 | \ifthu@degree@bachelor\pagestyle{thu@plain}\else\pagestyle{thu@headings}\fi}
205 \renewcommand\backmatter{%
206 | \if@openright\cleardoublepage\else\clearpage\fi
207 | \@mainmattertrue}

### 5.5.2 字体

### 使用 fontspec 配置字体。

208 \newcommand\thu@fontset{\csname g__ctex_fontset_tl\endcsname} 209 \ifthenelse{\equal{\thu@fontset}{fandol}}{
210 | \setmainfont[
211 | Extension | = .otf,
212 | UprightFont | = *-regular,
213 | BoldFont | = *-bold,
214 | ItalicFont | = *-italic,
215 | BoldItalicFont = *-bolditalic,
216 | ]{texgyretermes}

217 | \setsansfont[
218 | Extension | = .otf,
219 | UprightFont | = *-regular,
220 | BoldFont | = *-bold,
221 | ItalicFont | = *-italic,
222 | BoldItalicFont = *-bolditalic,
223 | ]{texgyreheros}
224 | \setmonofont[
225 | Extension | = .otf,
226 | UprightFont | = *-regular,
227 | BoldFont | = *-bold,
228 | ItalicFont | = *-italic,
229 | BoldItalicFont = *-bolditalic,
230 | Scale | = MatchLowercase,
231 | ]{texgyrecursor}

232 }{
233 | \setmainfont{Times New Roman}
234 | \setsansfont{Arial}
235 | \ifthenelse{\equal{\thu@fontset}{mac}}{
236 | \setmonofont[Scale=MatchLowercase]{Menlo}
237 | }{
238 | \setmonofont[Scale=MatchLowercase]{Courier New}
239 | }

240 }

### 使用 unicode-math 配置数学字体

241 \unimathsetup{
242 | math-style = ISO,
243 | bold-style = ISO,
244 | nabla | = upright,
245 | partial | = upright,

246 }
247 \IfFontExistsTF{XITSMath-Regular.otf}{
248 | \setmathfont[
249 | Extension | = .otf,
250 | BoldFont | = XITSMath-Bold,
251 | StylisticSet = 8,
252 | ]{XITSMath-Regular}
253 | \setmathfont[range={cal,bfcal},StylisticSet=1]{XITSMath-Regular.otf}

254 }{
255 | \setmathfont[
256 | Extension | = .otf,
257 | BoldFont | = *bold,
258 | StylisticSet = 8,
259 | ]{xits-math}
260 | \setmathfont[range={cal,bfcal},StylisticSet=1]{xits-math.otf}

261 }

在使用 Windows Vista 或之后版本的系统时，ctex 宏包会默认使用微软雅黑字体，这可能 会导致审查不合格。下面设置适合印刷的黑体，同时保持跨平台兼容性。
262 \ifthenelse{\equal{\thu@fontset}{windows}}{
263 | \xeCJKsetup{EmboldenFactor=2}
264 | \IfFileExists{C:/bootfont.bin}{
265 | \setCJKmainfont[AutoFakeBold,ItalicFont=KaiTi_GB2312]{SimSun}
266 | \setCJKfamilyfont{zhkai}[AutoFakeBold]{KaiTi_GB2312}
267 | }{
268 | \setCJKmainfont[AutoFakeBold,ItalicFont=KaiTi]{SimSun}
269 | \setCJKfamilyfont{zhkai}[AutoFakeBold]{KaiTi}
270 | }
271 | \setCJKsansfont[AutoFakeBold]{SimHei}
272 | \setCJKfamilyfont{zhsong}[AutoFakeBold]{SimSun}
273 | \setCJKfamilyfont{zhhei}[AutoFakeBold]{SimHei}

274 }{}
| 类似地，ctex 2.4.14 开始在 macOS 下自动调用苹方黑体，所以必进行调整。

275 \ifthenelse{\equal{\thu@fontset}{mac}}{
276 | \setCJKmainfont[
277 | UprightFont = * Light,
278 | BoldFont = * Bold,
279 | ItalicFont = Kaiti SC,
280 | BoldItalicFont = Kaiti SC Bold,
281 | ]{Songti SC}
282 | \setCJKsansfont[BoldFont=* Medium]{Heiti SC}
283 | \setCJKfamilyfont{zhsong}[
284 | UprightFont = * Light,
285 | BoldFont = * Bold,
286 | ]{Songti SC}
287 | \setCJKfamilyfont{zhhei}[BoldFont=* Medium]{Heiti SC}
288 | \setCJKfamilyfont{zhkai}[BoldFont=* Bold]{Kaiti SC}
289 | \xeCJKsetwidth{‘’“”}{1em}

290 }{}

\normalsize 正文小四号 (12bp) 字，行距为固定值 20 bp。 291 \renewcommand\normalsize{%
292 | \@setfontsize\normalsize{12bp}{20bp}%
293 | \abovedisplayskip=12bp \@plus 2bp \@minus 2bp
294 | \abovedisplayshortskip=12bp \@plus 2bp \@minus 2bp
295 | \belowdisplayskip=\abovedisplayskip
296 | \belowdisplayshortskip=\abovedisplayshortskip}
| WORD 中的字号对应该关系如下（1bp = 72.27/72 pt）:

初号 42bp | 14.82mm 42.1575pt
小初 36bp | 12.70mm 36.135 pt
一号 26bp | 9.17mm | 26.0975pt
小一 24bp | 8.47mm | 24.09pt
二号 22bp | 7.76mm | 22.0825pt
小二 18bp | 6.35mm | 18.0675pt
三号 16bp | 5.64mm | 16.06pt
小三 15bp | 5.29mm | 15.05625pt
四号 14bp | 4.94mm | 14.0525pt
小四 12bp | 4.23mm | 12.045pt
五号 10.5bp 3.70mm | 10.59375pt
小五 9bp | 3.18mm | 9.03375pt
六号 7.5bp | 2.56mm
小六 6.5bp | 2.29mm
七号 5.5bp | 1.94mm
八号 5bp | 1.76mm

\thu@def@fontsize 根据习惯定义字号。用法：

### \thu@def@fontsize{⟨字号名称⟩}{⟨磅数⟩}

避免了字号选择和行距的紧耦合。所有字号定义时为单倍行距，并提供选项指定行距倍数。 297 \def\thu@def@fontsize#1#2{%
298 | \expandafter\newcommand\csname #1\endcsname[1][1.3]{%
299 | \fontsize{#2}{##1\dimexpr #2}\selectfont}}

\chuhao
\xiaochu
\yihao
\xiaoyi
\erhao
\xiaoer
\sanhao
\xiaosan
\sihao
\banxiaosi
\xiaosi
\dawu
\wuhao
\xiaowu
\liuhao
\xiaoliu
\qihao
\bahao

一组字号定义。TODO：用 \zihao 替代。

300 \thu@def@fontsize{chuhao}{42bp} 301 \thu@def@fontsize{xiaochu}{36bp} 302 \thu@def@fontsize{yihao}{26bp} 303 \thu@def@fontsize{xiaoyi}{24bp} 304 \thu@def@fontsize{erhao}{22bp} 305 \thu@def@fontsize{xiaoer}{18bp} 306 \thu@def@fontsize{sanhao}{16bp} 307 \thu@def@fontsize{xiaosan}{15bp} 308 \thu@def@fontsize{sihao}{14bp} 309 \thu@def@fontsize{banxiaosi}{13bp} 310 \thu@def@fontsize{xiaosi}{12bp} 311 \thu@def@fontsize{dawu}{11bp}
312 \thu@def@fontsize{wuhao}{10.5bp} 313 \thu@def@fontsize{xiaowu}{9bp} 314 \thu@def@fontsize{liuhao}{7.5bp} 315 \thu@def@fontsize{xiaoliu}{6.5bp} 316 \thu@def@fontsize{qihao}{5.5bp} 317 \thu@def@fontsize{bahao}{5bp}

### 5.5.3 语言设置

由于 Unicode 的一些标点符号是中西文混用的：U+00B7（·）、U+2013（–）、U+2014（—）、 U+2018（‘）、U+2019（’）、U+201C（“）、U+201D（”）、U+2025（）、U+2026（…）、U+2E3A （），所以要根据语言设置正确的字体。¹ 所以要根据语言设置正确的字体。

318 \newcommand\thu@setchinese{%
319 \xeCJKResetPunctClass

320 }
321 \newcommand\thu@setenglish{%
322 | \xeCJKDeclareCharClass{HalfLeft}{"2018, "201C}%
323 | \xeCJKDeclareCharClass{HalfRight}{
324 | "00B7, "2019, "201D, "2013, "2014, "2025, "2026, "2E3A,
325 | }%

326 }
327 \newcommand\thu@setdefaultlanguage{%
328 | \ifthu@language@chinese
329 | \thu@setchinese
330 | \else
331 | \thu@setenglish
332 | \fi

333 }

| 中英文翻译：
334 \ifthu@language@chinese
335 | \ctexset{
336 | chapter/name | = {第, 章},
337 | appendixname | = 附录,
338 | contentsname | = {目\hspace{\ccwd} 录},
339 | listfigurename = 插图索引,
340 | listtablename = 表格索引,
341 | figurename | = 图,
342 | tablename | = 表,
343 | bibname | = 参考文献,
344 | indexname | = 索引,
345 | }
346 | \newcommand\thu@denotation@name{主要符号对照表}
347 | \newcommand\listequationname{公式索引}
348 | \newcommand\equationname{公式}
349 | \newcommand\thu@assumption@name{假设}
350 | \newcommand\thu@definition@name{定义}
351 | \newcommand\thu@proposition@name{命题}
352 | \newcommand\thu@lemma@name{引理}
353 | \newcommand\thu@theorem@name{定理}
354 | \newcommand\thu@axiom@name{公理}
355 | \newcommand\thu@corollary@name{推论}

1https://github.com/CTeX-org/ctex-kit/issues/389

356 | \newcommand\thu@exercise@name{练习}
357 | \newcommand\thu@example@name{例}
358 | \newcommand\thu@remark@name{注释}
359 | \newcommand\thu@problem@name{问题}
360 | \newcommand\thu@conjecture@name{猜想}
361 | \newcommand\thu@proof@name{证明}
362 | \newcommand\thu@theorem@separator{：}
363 | \newcommand\thu@ack@name{致\hspace{\ccwd} 谢}
364 | \ifthu@degree@bachelor
365 | \newcommand\thu@resume@title{在学期间参加课题的研究成果}
366 | \else
367 | \ifthu@degree@postdoc
368 | \newcommand\thu@resume@title{个人简历、发表的学术论文与科研成果}
369 | \else
370 | \newcommand\thu@resume@title{个人简历、在学期间发表的学术论文与研究成果}
371 | \fi
372 | \fi
373 \else
374 | \newcommand\thu@denotation@name{Nomenclature}
375 | \newcommand\listequationname{List of Equations}
376 | \newcommand\equationname{Equation}
377 | \newcommand\thu@assumption@name{Assumption}
378 | \newcommand\thu@definition@name{Definition}
379 | \newcommand\thu@proposition@name{Proposition}
380 | \newcommand\thu@lemma@name{Lemma}
381 | \newcommand\thu@theorem@name{Theorem}
382 | \newcommand\thu@axiom@name{Axiom}
383 | \newcommand\thu@corollary@name{Corollary}
384 | \newcommand\thu@exercise@name{Exercise}
385 | \newcommand\thu@example@name{Example}
386 | \newcommand\thu@remark@name{Remark}
387 | \newcommand\thu@problem@name{Problem}
388 | \newcommand\thu@conjecture@name{Conjecture}
389 | \newcommand\thu@proof@name{proof}
390 | \newcommand\thu@theorem@separator{: }
391 | \newcommand\thu@ack@name{Acknowledgements}
392 | \ifthu@degree@bachelor
393 | \newcommand\thu@resume@title{Research Achievements}
394 | \else
395 | \newcommand\thu@resume@title{Resume, Publications and Research Achieve-
| ments}
396 | \fi

397 \fi

### 5.5.4 页眉页脚

定义页眉和页脚。

\ps@thu@empty
\ps@thu@plain
\ps@thu@headings

定义三种页眉页脚格式：
- thu@empty：页眉页脚都没有

### - thu@plain：只显示页脚的页码。\chapter 自动调用\thispagestyle{thu@plain}。 - thu@headings：页眉页脚同时显示

398 \fancypagestyle{thu@empty}{%
399 | \fancyhf{}
400 | \renewcommand{\headrulewidth}{0pt}
401 | \renewcommand{\footrulewidth}{0pt}}
402 \fancypagestyle{thu@plain}{%
403 | \fancyhead{}
404 | \fancyfoot[C]{\xiaowu\thepage}
405 | \renewcommand{\headrulewidth}{0pt}
406 | \renewcommand{\footrulewidth}{0pt}}
407 \fancypagestyle{thu@headings}{%
408 | \fancyhead{}
409 | \fancyhead[C]{\wuhao\normalfont\leftmark}
410 | \fancyfoot{}
411 | \fancyfoot[C]{\wuhao\thepage}
412 | \renewcommand{\headrulewidth}{0.4pt}
413 | \renewcommand{\footrulewidth}{0pt}}

### 5.5.5 段落

| 全文首行缩进 2 字符，标点符号用全角
414 \ctexset{%
415 | punct=quanjiao,
416 | space=auto,
417 | autoindent=true}
| 利用 enumitem 命令调整默认列表环境间的距离，以符合中文习惯。

418 \setlist{nosep}

### 5.5.6 脚注

| 脚注符合中文习惯，数字带圈。

\thu@textcircled 生成带圈的脚注数字，最多处理到 10。 419 \ifthenelse{\equal{\thu@fontset}{mac}}{
420 \newfontfamily\thu@circlefont{Songti SC Light}

421 }{
422 | \ifthenelse{\equal{\thu@fontset}{windows}}{
423 | \newfontfamily\thu@circlefont{SimSun}

424 | }{
425 | \IfFontExistsTF{XITS-Regular.otf}{
426 | \newfontfamily\thu@circlefont{XITS-Regular.otf}
427 | }{
428 | \newfontfamily\thu@circlefont{xits-regular.otf}
429 | }
430 | }

431 }
432 \def\thu@textcircled#1{%
433 | \ifnum\value{#1} >9%
434 | \ClassError{thuthesis}%
435 | {Too many footnotes in this page.}{Keep footnote less than 10.}%
436 | \fi
437 | {\thu@circlefont\symbol{\the\numexpr\value{#1}+"245F\relax}}%

438 }
439 \renewcommand{\thefootnote}{\thu@textcircled{footnote}}
440 \renewcommand{\thempfootnote}{\thu@textcircled{mpfootnote}}
| 定义脚注分割线，字号（宋体小五），以及悬挂缩进（1.5 字符）。
441 \def\footnoterule{\vskip-3\p@\hrule\@width0.3\textwidth\@height0.4\p@\vskip2.6\p@} 442 \let\thu@footnotesize\footnotesize
443 \renewcommand\footnotesize{\thu@footnotesize\xiaowu[1.5]}
444 \footnotemargin1.5em\relax
| \@makefnmark 默认是上标样式，而在脚注部分要求为正文大小。利用\patchcmd 动态

### 调整 \@makefnmark 的定义。

445 \let\thu@makefnmark\@makefnmark
446 \def\thu@@makefnmark{\hbox{{\normalfont\@thefnmark}}}
447 \pretocmd{\@makefntext}{\let\@makefnmark\thu@@makefnmark}{}{} 448 \apptocmd{\@makefntext}{\let\@makefnmark\thu@makefnmark}{}{}

### 5.5.7 数学相关

\ldots 省略号一律居中，所以 \ldots 不再居于底部。

449 \ifthu@language@chinese 450 \def\mathellipsis{\cdots}

451 \fi

\le
\ge
\leq
\geq

小于等于号要使用倾斜的形式。
452 \protected\def\le{\leqslant} 453 \protected\def\ge{\geqslant} 454 \AtBeginDocument{%
455 | \renewcommand\leq{\leqslant}%
456 | \renewcommand\geq{\geqslant}%

457 }

\int 积分号 \int 使用正体，并且上下限默认置于积分号上下两侧。

458 \removenolimits{%
459 | \int\iint\iiint\iiiint\oint\oiint\oiiint
460 | \intclockwise\varointclockwise\ointctrclockwise\sumint
461 | \intbar\intBar\fint\cirfnint\awint\rppolint
462 | \scpolint\npolint\pointint\sqint\intlarhk\intx
463 | \intcap\intcup\upint\lowint

464 }

\Re
\Im

实部、虚部操作符使用罗马体 Re、Im 而不是 fraktur 体 ℜ、ℑ。 465 \AtBeginDocument{%
466 | \renewcommand{\Re}{\operatorname{Re}}%
467 | \renewcommand{\Im}{\operatorname{Im}}%

468 }

\nabla \nabla 使用粗正体。

469 \AtBeginDocument{%
470 \renewcommand\nabla{\mbfnabla}%

471 }

\bm
\boldsymbol

### 兼容旧的粗体命令：bm 的 \bm 和 amsmath 的 \boldsymbol。

472 \newcommand\bm{\symbf}
473 \renewcommand\boldsymbol{\symbf}

\square 兼容 amssymb 中的命令。

474 \newcommand\square{\mdlgwhtsquare}

\checkmark 允许在文本模式中使用 \checkmark。

475 \AtBeginDocument{%
476 \renewcommand\checkmark{\ensuremath{ff}}%

477 }

| 允许太长的公式断行、分页等。
478 \allowdisplaybreaks[4]
479 \renewcommand\theequation{\ifnum \c@chapter>\z@ \thechapter-\fi\@arabic\c@equation}
| 公式距前后文的距离由 4 个参数控制，参见 \normalsize 的定义。
| 本科的公式编号要求很诡异，不得不修改 amsmath 中很深的一个命令 \tagform@。同时
为了让 amsmath 的 \tag* 命令得到正确的格式，我们必须修改这些代码。\make@df@tag

### 是定义 \tag* 和 \tag 内部命令的。\make@df@tag@@ 处理 \tag*，我们就改它！

\def\make@df@tag{\@ifstar\make@df@tag@@\make@df@tag@@@} \def\make@df@tag@@#1{%
| \gdef\df@tag{\maketag@@@{#1}\def\@currentlabel{#1}}}

480 \def\make@df@tag{\@ifstar\thu@make@df@tag@@\make@df@tag@@@}
481 \def\thu@make@df@tag@@#1{\gdef\df@tag{\thu@maketag{#1}\def\@currentlabel{#1}}} 482 \iffalse

483 \ifthu@degree@bachelor
484 | \def\thu@maketag#1{\maketag@@@{%
485 | (\ignorespaces\text{\equationname\hskip0.5em}#1\unskip\@@italiccorr)}}
486 | \def\tagform@#1{\maketag@@@{%
487 | (\ignorespaces\text{\equationname\hskip0.5em}#1\unskip\@@italiccorr)\equcaption{#1}}}

488 \fi

489 \fi
490 \def\thu@maketag#1{\maketag@@@{(\ignorespaces #1\unskip\@@italiccorr)}}
491 \def\tagform@#1{\maketag@@@{(\ignorespaces #1\unskip\@@italiccorr)\equcaption{#1}}}

### 修改 \tagform 会影响 \eqref。

492 \renewcommand{\eqref}[1]{\textup{(\ref{#1})}}

### 5.5.8 浮动对象以及表格

设置浮动对象和文字之间的距离
493 \setlength{\floatsep}{12bp \@plus 2bp \@minus 4bp} 494 \setlength{\textfloatsep}{12bp}
495 \setlength{\intextsep}{12bp}
496 \setlength{\@fptop}{0bp \@plus1.0fil}
497 \setlength{\@fpsep}{12bp \@plus2.0fil}
498 \setlength{\@fpbot}{0bp \@plus1.0fil}

下面这组命令使浮动对象的缺省值稍微宽松一点，从而防止幅度对象占据过多的文本页面， 也可以防止在很大空白的浮动页上放置很小的图形。
499 \renewcommand{\textfraction}{0.15}
500 \renewcommand{\topfraction}{0.85}
501 \renewcommand{\bottomfraction}{0.65} 502 \renewcommand{\floatpagefraction}{0.60}

定制浮动图形和表格标题样式
- 图表标题字体为 11pt，这里写作大五号
- 去掉图表号后面的冒号。图序与图名文字之间空一个汉字符宽度。
- 图：caption 在下，段前空 6 磅，段后空 12 磅
- 表：caption 在上，段前空 12 磅，段后空 6 磅

503 \ifthu@degree@bachelor
504 | \g@addto@macro\appendix{\renewcommand*{\thefigure}{\thechapter-\arabic{figure}}}
505 | \g@addto@macro\appendix{\renewcommand*{\thetable}{\thechapter-\arabic{table}}}

506 \fi
507 \let\old@tabular\@tabular
508 \def\thu@tabular{\dawu[1.5]\old@tabular}
509 \DeclareCaptionFont{thu}{\dawu[1.3]}
510 \DeclareCaptionLabelSeparator{thu}{\hspace{\ccwd}} 511 \captionsetup{
512 | font | = thu,
513 | labelsep | = thu,

514 | skip | = 6bp,
515 | figureposition = bottom,
516 | tableposition = top,

517 }
518 \captionsetup[sub]{font=thu}
519 \renewcommand{\thesubfigure}{(\alph{subfigure})} 520 \renewcommand{\thesubtable}{(\alph{subtable})} 521 % \renewcommand{\p@subfigure}{:}

\hlinewd 简单的表格使用三线表推荐用 \hlinewd。如果表格比较复杂还是用 booktabs 的命令好一 些。
522 \def\hlinewd#1{%
523 | \noalign{\ifnum0=`}\fi\hrule \@height #1 \futurelet
524 | \reserved@a\@xhline}

### 5.5.9 章节标题

525 \ifthu@degree@bachelor
526 | \newcommand{\cabstractname}{中文摘要}
527 | \newcommand{\eabstractname}{ABSTRACT}
528 \else
529 | \newcommand{\cabstractname}{摘\hspace{\ccwd} 要}
530 | \newcommand{\eabstractname}{Abstract}

531 \fi

fancyhdr 定义页眉页脚很方便，但是有一个非常隐蔽的坑。通过 fancyhdr 定义的样式 在第一次被调用时会修改 \chaptermark，这会导致页眉信息错误（多余章号并且英文大写）。 这是因为在原始的 book.cls 中定义如下（大意）：

\newcommand\chaptername{Chapter}
\newcommand\@chapapp{\chaptername}
\def\chaptermark#1{
\markboth{\MakeUppercase{\@chapapp\ \thechapter}}{}}

很显然这个 \chapapp 不适合中文，因此我们使用\CTEXthechapter（如，“第 x 章”），同 时会将 \MakeUppercase 去掉。也就是说我们会做如下动作：

\renewcommand{\chaptermark}[1]{\@mkboth{\CTEXthechapter\hskip\ccwd#1}{}}

### 但，fancyhdr 不知何故在 \ps@fancy 中对 \chaptermark 进行重定义（其实一模一样）， 而这个 \ps@fancy 会在 \fancypagestyle 中使用，如下：

\newcommand{\fancypagestyle}[2]{% \@namedef{ps@#1}{\let\fancy@gbl\relax#2\relax\ps@fancy}}

这样的话，\ps@fancy 会在 fancyhdr 定义的任何样式首次样被激活时调用，从而覆盖我们 的 \chaptermark 定义（后续样式再激活不会重复覆盖）。所以我们采用如下方法解决： 532 \AtBeginDocument{%
533 \pagestyle{thu@empty}

534 \renewcommand{\chaptermark}[1]{\@mkboth{\CTEXthechapter\hskip\ccwd#1}{}}}

各级标题格式设置。
chapter 章序号与章名之间空一个汉字符黑体三号字，居中书写，单倍行距，段前空 24 磅，段后 空 18 磅。本科要求：段前段后间距 30/20 pt，行距 20pt。但正文章节 30pt 的话和样例效果 不一致。
section 一级节标题，例如： | 2.1 实验装置与实验方法 | 。节标题序号与标题名之间空一个汉字符
（下同）。采用黑体四号（14pt）字居左书写，行距为固定值 20 磅，段前空 24 磅，段后空 6 磅。本科：25/12 pt，行距 18pt。
subsection 二级节标题，例如： | 2.1.1 实验装置 | 。采用黑体 13pt 字居左书写，行距为固定值 20
磅，段前空 12 磅，段后空 6 磅。本科：中文黑体 12pt 字，英文 13pt 字，段间距 12/6 pt，行 距 15pt。
subsubsection 三级节标题，例如： 2.1.2.1 归纳法 。采用黑体小四号（12pt）字居左书写，行距 为固定值 20 磅，段前空 12 磅，段后空 6 磅。

535 \newcommand\thu@chapter@titleformat[1]{%
536 | \ifthu@degree@bachelor #1\else%
537 | \ifthenelse%
538 | {\equal{#1}{\eabstractname}}%
539 | {\bfseries #1}%
540 | {#1}%
541 | \fi}
542 \ctexset{%
543 | chapter={
544 | afterindent=true,
545 | pagestyle={\ifthu@degree@bachelor thu@plain\else thu@headings\fi},
546 | beforeskip={\ifthu@degree@bachelor 15bp\else 9bp\fi},
547 | aftername=\hskip\ccwd,
548 | afterskip={\ifthu@degree@bachelor 20bp\else 24bp\fi},
549 | format={\centering\sffamily\ifthu@degree@bachelor\xiaosan[1.333]\else\sanhao[1]\fi},
550 | nameformat=\relax,
551 | numberformat=\relax,
552 | titleformat=\thu@chapter@titleformat,
553 | lofskip=0pt,
554 | lotskip=0pt,
555 | },
556 | section={
557 | afterindent=true,
558 | beforeskip={\ifthu@degree@bachelor 25bp\else 24bp\fi\@plus 1ex \@minus .2ex},
559 | afterskip={\ifthu@degree@bachelor 12bp\else 6bp\fi \@plus .2ex},
560 | format={\sffamily\ifthu@degree@bachelor\sihao[1.286]\else\sihao[1.429]\fi},
561 | },
562 | subsection={
563 | afterindent=true,
564 | beforeskip={\ifthu@degree@bachelor 12bp\else 16bp\fi\@plus 1ex \@minus .2ex},
565 | afterskip={6bp \@plus .2ex},

566 | format={\sffamily\ifthu@degree@bachelor\xiaosi[1.25]\else\banxiaosi[1.538]\fi},
567 | numberformat={\sffamily\ifthu@degree@bachelor\banxiaosi[1.154]\else\banxiaosi[1.538]\fi},
568 | },
569 | subsubsection={
570 | afterindent=true,
571 | beforeskip={\ifthu@degree@bachelor 12bp\else 16bp\fi\@plus 1ex \@minus .2ex},
572 | afterskip={6bp \@plus .2ex},
573 | format={\sffamily\ifthu@degree@bachelor\xiaosi[1.25]\else\xiaosi[1.667]\fi},
574 | },
575 | paragraph/afterindent=true,
576 | subparagraph/afterindent=true}

\thu@chapter* 默认的 \chapter* 很难同时满足研究生院和本科生的论文要求。本科论文要求所有的章都出 现在目录里，比如摘要、Abstract、主要符号表等，所以可以简单的扩展默认\chapter* 实现 这个目的。但是研究生又不要这些出现在目录中，而且致谢和声明部分的章名、页眉和目录都不 同，所以定义一个灵活的 \thu@chapter* 专门处理这些要求。
| \thu@chapter*[⟨tocline⟩]{⟨title⟩}[⟨header⟩]: tocline 是出现在目录中的条目，如果为
空则此 chapter 不出现在目录中，如果省略表示目录出现 title；title 是章标题；header 是页眉出 现的标题，如果忽略则取 title。通过这个宏我才真正体会到 TEX macro 的力量！
577 \newcommand\thu@pdfbookmark[2]{}
578 \newcommand\thu@phantomsection{}
579 \NewDocumentCommand\thu@chapter{s o m o}{
580 | \IfBooleanF{#1}{%
581 | \ClassError{thuthesis}{You have to use the star form: \string\thu@chapter*}{}
582 | }%
583 | \if@openright\cleardoublepage\else\clearpage\fi%
584 | \IfValueTF{#2}{%
585 | \ifthenelse{\equal{#2}{}}{%
586 | \thu@pdfbookmark{0}{#3}%
587 | }{%
588 | \thu@phantomsection
589 | \addcontentsline{toc}{chapter}{#3}%
590 | }%
591 | }{%
592 | \thu@phantomsection
593 | \addcontentsline{toc}{chapter}{#3}%
594 | }%
595 | \ifthu@degree@bachelor\ctexset{chapter/beforeskip=25bp}\fi
596 | \chapter*{#3}%
597 | \ifthu@degree@bachelor\ctexset{chapter/beforeskip=15bp}\fi
598 | \IfValueTF{#4}{%
599 | \ifthenelse{\equal{#4}{}}{%
600 | \@mkboth{}{}%
601 | }{%
602 | \@mkboth{#4}{#4}%

603 | }%
604 | }{%
605 | \@mkboth{#3}{#3}%
606 | }%

607 }

### 5.5.10 目录

| 最多 4 层，即: x.x.x.x，对应的命令和层序号分别是：\chapter(0), \section(1), \sub-

### section(2), \subsubsection(3)。

608 \setcounter{secnumdepth}{3}
609 \setcounter{tocdepth}{2}
| 每章标题行前空 6 磅，后空 0 磅。章节名中英文用 Arial 字体，页码仍用 Times。

\tableofcontents 目录生成命令。
610 \renewcommand\tableofcontents{%
611 | \thu@chapter*[]{\contentsname}
612 | \ifthu@degree@bachelor\xiaosi[1.667]\else\xiaosi[1.65]\fi\@starttoc{toc}\normalsize}

调整目录样式，允许指定目录字体。
613 \def\@pnumwidth{2em}
614 \def\@tocrmarg{\@pnumwidth} 615 \def\@dotsep{1}
616 \renewcommand*\l@chapter[2]{%
617 | \ifnum \c@tocdepth >\m@ne
618 | \addpenalty{-\@highpenalty}%
619 | \ifthu@degree@bachelor\vskip 6bp\else\vskip 4bp\fi \@plus\p@
620 | \setlength\@tempdima{4em}%
621 | \begingroup
622 | \parindent \z@ \rightskip \@pnumwidth
623 | \parfillskip -\@pnumwidth
624 | \leavevmode
625 | \advance\leftskip\@tempdima
626 | \hskip -\leftskip
627 | \begingroup
628 | \ifthu@degree@graduate
629 | \sffamily
630 | \else
631 | \ifthu@degree@bachelor
632 | \heiti
633 | \fi
634 | \fi
635 | #1%
636 | \endgroup
637 | \leaders\hbox{$\m@th\mkern \@dotsep mu\hbox{.}\mkern \@dotsep mu$}\hfill%
638 | \nobreak #2\par

639 | \penalty\@highpenalty
640 | \endgroup
641 | \fi}

研究生学位论文写作指南中规定：目录中的章标题行居左书写，一级节标题行缩进 1 个汉字 符，二级节标题行缩进 2 个汉字符（但示例文件中为 1.5 个汉字符）。本科生指南中未作明确规定， 示例文件中对于一级和二级节标题分别缩进 1 和 1.5 个汉字符。
642 \patchcmd{\@dottedtocline}{\hb@xt@\@pnumwidth}{\hbox}{}{}
643 \renewcommand*\l@section{%
644 \@dottedtocline{1}{\ccwd}{2.1em}}
645 \renewcommand*\l@subsection{%
646 \@dottedtocline{2}{\ifthu@degree@bachelor 1.5\ccwd\else 2\ccwd\fi}{3em}} 647 \renewcommand*\l@subsubsection{%
648 \@dottedtocline{3}{\ifthu@degree@bachelor 2.4em\else 3.5em\fi}{3.8em}}

### 5.5.11 封面和封底

定义密级参数。
649 \thu@define@key{
650 | secret-level = {
651 | name = secret@level,
652 | },
653 | secret-year = {
654 | name = secret@year,
655 | },

论文中英文题目。
656 | title = {
657 | default = {标题},
658 | },
659 | title* = {
660 | default = {Title},
661 | name | = title@en,
662 | },

作者、导师、副导师、联合指导老师。
663 | author = {
664 | default = {姓名},
665 | },
666 | author* = {
667 | default = {Name of author},
668 | name | = author@en,
669 | },
670 | supervisor = {
671 | default = {导师姓名},
672 | },
673 | supervisor* = {

674 | default = {Name of supervisor},
675 | name | = supervisor@en,
676 | },
677 | associate-supervisor = {
678 | name = associate@supervisor,
679 | },
680 | associate-supervisor* = {
681 | name = associate@supervisor@en,
682 | },
683 | joint-supervisor = {
684 | name = joint@supervisor,
685 | },
686 | joint-supervisor* = {
687 | name = joint@supervisor@en,
688 | },
| 学位中英文。
689 | degree-name = {
690 | default = {工学博士},
691 | name | = degree@name,
692 | },
693 | degree-name* = {
694 | default = {Doctor of Philosophy},
695 | name | = degree@name@en,
696 | },

院系中英文名称。
697 | department = {
698 | default = {计算机科学与技术系},
699 | },

专业中英文名称。
700 | discipline = {
701 | % default = {计算机科学与技术},
702 | },
703 | discipline* = {
704 | % default = {Computer Science and Technology},
705 | name | = discipline@en,
706 | },

论文成文日期。
707 | date = {
708 | default = {\the\year-\two@digits{\month}-\two@digits{\day}},
709 | },

博士后专用封面参数。
710 | clc,
711 | udc,

712 | id,
713 | discipline-level-1 = {
714 | default = {一级学科名称},
715 | name | = discipline@level@i,
716 | },
717 | discipline-level-2 = {
718 | default = {二级学科名称},
719 | name | = discipline@level@ii,
720 | },
721 | start-date = {
722 | name | = start@date,
723 | default = {\the\year-\two@digits{\month}-\two@digits{\day}},
724 | },
725 | end-date = {
726 | name | = end@date,
727 | default = {\the\year-\two@digits{\month}-\two@digits{\day}},
728 | },

729 }
输出日期的给定格式：\thu@format@date{⟨format⟩}{⟨date⟩}，其中格式 ⟨format⟩ 接受 三个参数分别对应年、月、日，⟨date⟩ 是 ISO 格式的日期（yyyy-mm-dd）。
730 \newcommand\thu@format@date[2]{%
731 | \edef\thu@@date{#2}%
732 | \def\thu@@process@date##1-##2-##3\@nil{%
733 | #1{##1}{##2}{##3}%
734 | }%
735 | \expandafter\thu@@process@date\thu@@date\@nil

736 }
737 \newcommand\thu@date@zh@digit[3]{#1 年 \number#2 月 \number#3 日} 738 \newcommand\thu@date@zh@digit@short[3]{#1 年 \number#2 月}
739 \newcommand\thu@date@zh@short[3]{\zhdigits{#1} 年\zhnumber{#2} 月} 740 \newcommand\thu@date@month[1]{%
741 | \ifcase\number#1\or
742 | January\or February\or March\or April\or May\or June\or
743 | July\or August\or September\or October\or November\or December%
744 | \fi

745 }
746 \newcommand\thu@date@en@short[3]{\thu@date@month{#2}, #1}
| 下划线命令
747 \newcommand\thu@underline[2][6em]{\hskip1pt\underline{\hb@xt@ #1{\hss#2\hss}}\hskip3pt} 748 \newcommand\thu@CJKunderline[2][6em]{\CJKunderline*{\hb@xt@ #1{\hss#2\hss}}}

将内容拉伸或压缩到固定宽度。
749 \newcommand\thu@fixed@box[2]{%
750 | \begingroup
751 | \def\CJKglue{\hskip 0pt plus 2filll minus 1filll}%

752 | \makebox[#1][l]{#2}%
753 | \endgroup

754 }

如果内容小于给定宽度，则拉伸至该宽度，否则取自然宽度。 755 \newbox\thu@stretch@box
756 \newcommand\thu@stretch[2]{%
757 | \sbox\thu@stretch@box{#2}%
758 | \ifdim \wd\thu@stretch@box < #1\relax
759 | \begingroup
760 | \def\CJKglue{\hskip 0pt plus 2filll}%
761 | \makebox[#1][l]{#2}%
762 | \endgroup
763 | \else
764 | \box\thu@stretch@box
765 | \fi

766 }

如果内容小于给定宽度，则在右侧填充空白至该宽度，否则取自然宽度。 767 \newbox\thu@pad@box
768 \newcommand\thu@pad[2]{%
769 | \sbox\thu@pad@box{#2}%
770 | \ifdim \wd\thu@pad@box < #1\relax
771 | \makebox[#1][l]{\box\thu@pad@box}%
772 | \else
773 | \box\thu@pad@box
774 | \fi

775 }
导师的姓名和职称使用“,”分开，所以这里用 kvsetkeys 的 \comma@parse 来处理。

776 \newcounter{thu@csl@count}
777 \newcommand\thu@name@title@process[1]{%
778 | \ifcase\c@thu@csl@count | % == 0
779 | \gdef\thu@@name{#1}%
780 | \or % == 1
781 | \gdef\thu@@title{#1}%
782 | \fi
783 | \stepcounter{thu@csl@count}%

784 }
785 \newcommand\thu@name@title@format[2]{%
786 | \thu@pad{3cm}{\thu@stretch{4em}{#1}}%
787 | \thu@stretch{3em}{#2}%

788 }
789 \newcommand\thu@name@title[1]{%
790 | \setcounter{thu@csl@count}{0}%
791 | \gdef\thu@@name{}%
792 | \gdef\thu@@title{}%
793 | \expandafter\comma@parse\expandafter{#1}{\thu@name@title@process}%

794 \thu@name@title@format{\thu@@name}{\thu@@title}%

795 }
封面
\maketitle 生成封面（题名页）总命令。
796 \renewcommand\maketitle{%
797 | \cleardoublepage
798 | \pagestyle{thu@empty}%
799 | \pagenumbering{Alph}%
800 | \thu@pdfbookmark{-1}{\thu@title}%
801 | \thu@titlepage
802 | \ifthu@degree@graduate
803 | \cleardoublepage
804 | \thu@titlepage@en
805 | \fi
806 | \clearpage

807 }

\thu@titlepage 中文封面（题名页）
| 研究生的中文封面分“学术型”和“专业型”两种 layout，但是“工程硕士”跟“学术型”的
layout 一样，所以按照 \thu@discipline（工程领域）是否为空来区分“工程硕士”。

808 \newcommand\thu@titlepage{%
809 | \ifthu@degree@graduate
810 | \ifthu@degree@type@academic
811 | \thu@titlepage@graduate@academic
812 | \else
813 | \ifx\thu@discipline\@empty
814 | \thu@titlepage@graduate@professional
815 | \else
816 | \thu@titlepage@graduate@academic
817 | \fi
818 | \fi
819 | \else
820 | \ifthu@degree@bachelor
821 | \thu@titlepage@bachelor
822 | \else
823 | \ifthu@degree@postdoc
824 | \thu@cover@postdoc
825 | \cleardoublepage
826 | \thu@titlepage@postdoc
827 | \fi
828 | \fi
829 | \fi

830 }

研究生中文封面 《写作指南》规定中文封面页边距：上—6. 0 厘米，下—5.5 厘米，左—4.0 厘米，右—4.0 厘

米，装订线 0 厘米。然而作为事实标准的 Word 模板的页边距是上下 6.0 厘米，左右 4.0 厘米。这

里缩小上边距以方便排版保密信息。
831 \newcommand\thu@titlepage@graduate@academic{%
832 | \newgeometry{
833 | top | = 2cm,
834 | bottom | = 6cm,
835 | hmargin = 3.5cm,
836 | }%
837 | \null\vskip 0.2cm%
838 | \begingroup
839 | \centering
840 | \parbox[t][2cm][t]{\textwidth}{%
841 | \hskip -0.69cm%
842 | \thu@titlepage@secret
843 | }\par
844 | \vskip 1.5cm%
845 | {\thu@titlepage@title}%
846 | \vskip 0.85cm%
847 | \thu@titlepage@degree
848 | \vfill
849 | \parbox[t][7.25cm][t]{\textwidth}{\centering\thu@titlepage@info}\par
850 | \parbox[t][1.03cm][t]{\textwidth}{\centering\thu@titlepage@date}\par
851 | \endgroup
852 | \clearpage
853 | \restoregeometry

854 }
专业型学位论文中文封面
855 \newcommand\thu@titlepage@graduate@professional{%
856 | \newgeometry{
857 | top | = 2cm,
858 | bottom | = 6cm,
859 | hmargin = 3.5cm,
860 | }%
861 | \null\vskip 0.45cm%
862 | \begingroup
863 | \centering
864 | \parbox[t][1.52cm][t]{\textwidth}{%
865 | \hskip -0.69cm%
866 | \thu@titlepage@secret
867 | }\par
868 | \vskip 1.5cm%
869 | {\sffamily\yihao[1.575]\thu@title\par}%
870 | \vskip 0.9cm%
871 | \thu@titlepage@degree
872 | \vfill
873 | \parbox[t][5.28cm][t]{\textwidth}{\centering\thu@titlepage@info}\par
874 | \parbox[t][1.25cm][t]{\textwidth}{\centering\thu@titlepage@date}\par

875 | \endgroup
876 | \clearpage
877 | \restoregeometry

878 }

879 \newcommand\thu@titlepage@secret{%
880 | \sffamily\CJKfamily+{}\sanhao
881 | \ifx\thu@secret@level\@empty
882 | \phantom{秘密}%
883 | \else
884 | \thu@secret@levelff\makebox[3em][c]{\thu@secret@year} 年%
885 | \fi\par

886 }

| 题名使用一号黑体字，一行写不下时可分两行写。由于 Word 模板这里设置了“对齐到网格”，
所以实际行距不是 1.25 倍。
887 \newcommand\thu@titlepage@title{%
888 \sffamily\yihao[1.8]\thu@title\par

889 }
| 申请学位的学科门类: 小二号宋体字，字距延伸 0.5bp，所以 \CJKglue 应该设为 1 bp。

890 \newcommand\thu@titlepage@degree{%
891 | \begingroup
892 | \def\CJKglue{\hskip 1bp}%
893 | \CJKfamily+{}\xiaoer
894 | (申请清华大学\thu@degree@name\ifthu@degree@type@professional 专业\fi 学位
| 论文)\par
895 | \endgroup

896 }

| 作者及导师信息部分使用三号仿宋字
897 \newcommand\thu@titlepage@info{%
898 | \ifthu@degree@doctor
899 | \thu@titlepage@info@doctor
900 | \else
901 | \thu@titlepage@info@master
902 | \fi

903 }
904 \newcommand\thu@cover@info@tabular[4]{%
905 | \def\thu@cover@item##1##2##3{%
906 | \ifx##3\@empty\else
907 | \thu@pad{#2}{\thu@fixed@box{#1}{##1}}%
908 | \thu@pad{#3}{：}%
909 | ##2{##3}\\
910 | \fi
911 | }%
912 | \begin{tabular}{l}%
913 | #4%

914 \end{tabular}

915 }
916 \newcommand\thu@titlepage@info@doctor{%
917 | \fangsong\sanhao[1.95]%
918 | \thu@cover@info@tabular{2.8cm}{2.8cm}{0.82cm}{%
919 | \thu@cover@item{培养单位}{}{\thu@department}%
920 | \ifthu@degree@type@academic
921 | \thu@cover@item{学科}{}{\thu@discipline}%
922 | \thu@cover@item{研究生}{\thu@name@title}{\thu@author}%
923 | \else
924 | \thu@cover@item{申请人}{\thu@name@title}{\thu@author}%
925 | \fi
926 | \thu@cover@item{指导教师}{\thu@name@title}{\thu@supervisor}%
927 | \thu@cover@item{副指导教师}{\thu@name@title}{\thu@associate@supervisor}%
928 | \thu@cover@item{联合导师}{\thu@name@title}{\thu@joint@supervisor}%
929 | }\par

930 }
931 \newcommand\thu@titlepage@info@master{%
932 | \fangsong\sanhao[1.95]%
933 | \thu@cover@info@tabular{5.5em}{3.6cm}{0.82cm}{%
934 | \thu@cover@item{培养单位}{}{\thu@department}%
935 | \ifthu@degree@type@academic
936 | \thu@cover@item{学科}{}{\thu@discipline}%
937 | \thu@cover@item{研究生}{\thu@name@title}{\thu@author}%
938 | \else
939 | \thu@cover@item{工程领域}{}{\thu@discipline}%
940 | \thu@cover@item{申请人}{\thu@name@title}{\thu@author}%
941 | \fi
942 | \thu@cover@item{指导教师}{\thu@name@title}{\thu@supervisor}%
943 | \thu@cover@item{副指导教师}{\thu@name@title}{\thu@associate@supervisor}%
944 | \thu@cover@item{联合指导教师}{\thu@name@title}{\thu@joint@supervisor}%
945 | }\par

946 }
论文成文打印的日期，用三号宋体汉字，字距延伸 0.5bp，所以 \CJKglue 应该设为 1 bp。

947 \newcommand\thu@titlepage@date{%
948 | \begingroup
949 | \def\CJKglue{\hskip 1bp}%
950 | \sanhao\thu@format@date{\thu@date@zh@short}{\thu@date}\par
951 | \endgroup

952 }
研究生英文封面
\thu@titlepage@en
953 \newcommand{\thu@titlepage@en}{%
954 | \newgeometry{
955 | top | = 5.5cm,
956 | bottom = 5cm,

957 | hmargin = 3.6cm,
958 | }%
959 | \ifthu@degree@type@academic
960 | \thu@titlepage@en@graduate@academic
961 | \else
962 | \thu@titlepage@en@graduate@professional
963 | \fi
964 | \clearpage
965 | \restoregeometry

966 }
967 \newcommand\thu@titlepage@en@graduate@academic{%
968 | \begingroup
969 | \centering
970 | \null\vskip -0.7cm%
971 | \thu@titlepage@en@title
972 | \vfill
973 | \sanhao[1.725]%
974 | \thu@titlepage@en@degree
975 | \vskip 0.13cm%
976 | in\par
977 | \vskip 0.1cm%
978 | {\bfseries\sffamily\thu@discipline@en\par}
979 | \vskip 0.7cm%
980 | {\sffamily by\par}
981 | \vskip 0.24cm%
982 | {\sffamily\bfseries\thu@author@en\par}%
983 | \vskip 0.14cm%
984 | \parbox[t][3.07cm][t]{\textwidth}{%
985 | \centering\xiaosan[2.1]%
986 | \thu@titlepage@en@supervisor
987 | }\par
988 | \thu@titlepage@en@date
989 | \vskip 0.65cm%
990 | \endgroup

991 }
992 \newcommand\thu@titlepage@en@graduate@professional{%
993 | \begingroup
994 | \centering
995 | \null\vskip -0.7cm%
996 | \thu@titlepage@en@title
997 | \vfill
998 | \sanhao[1.725]%
999 | \thu@titlepage@en@degree
1000 | \vskip 1.1cm%
1001 | {\sffamily by\par}
1002 | \vskip 0.24cm%

1003 | {\sffamily\bfseries\thu@author@en\par}%
1004 | \ifx\thu@discipline@en\empty
1005 | \vskip 1.95cm%
1006 | \else
1007 | \vskip -0.1cm%
1008 | {\sffamily\bfseries(\thu@discipline@en)\par}%
1009 | \vskip 1.1cm%
1010 | \fi
1011 | \parbox[t][3.37cm][t]{\textwidth}{%
1012 | \centering\xiaosan[1.82]%
1013 | \thu@titlepage@en@supervisor
1014 | }\par
1015 | \thu@titlepage@en@date
1016 | \vskip 0.3cm%
1017 | \endgroup

1018 }
1019 \newcommand\thu@titlepage@en@title{%
1020 | \begingroup
1021 | \sffamily\bfseries\fontsize{20bp}{31bp}\selectfont
1022 | \thu@title@en\par
1023 | \endgroup

1024 }
1025 \newcommand\thu@thesis@name@en{%
1026 | \ifthu@degree@master
1027 | Thesis%
1028 | \else
1029 | Dissertation%
1030 | \fi

1031 }
1032 \newcommand\thu@titlepage@en@degree{%
1033 | \thu@thesis@name@en{} Submitted to\par
1034 | {\bfseries Tsinghua University\par}%
1035 | in partial fulfillment of the requirement\par
1036 | for the
1037 | \ifthu@degree@type@professional
1038 | professional
1039 | \fi
1040 | degree of\par
1041 | {\sffamily\bfseries\thu@degree@name@en\par}%

1042 }
1043 \newcommand\thu@titlepage@en@supervisor{%
1044 | \begin{tabular}{r@{\makebox[0.71cm][l]{:}}l}%
1045 | \thu@thesis@name@en{} Supervisor & \thu@supervisor@en | \\
1046 | \ifx\thu@associate@supervisor@en\@empty\else
1047 | Associate Supervisor | & \thu@associate@supervisor@en \\
1048 | \fi

1049 | \ifx\thu@joint@supervisor@en\@empty\else
1050 | Cooperate Supervisor | & \thu@joint@supervisor@en | \\
1051 | \fi
1052 | \end{tabular}%

1053 }
1054 \newcommand\thu@titlepage@en@date{%
1055 | \begingroup
1056 | \sffamily\bfseries\sanhao
1057 | \thu@format@date{\thu@date@en@short}{\thu@date}\par
1058 | \endgroup

1059 }

本科生封面 1060 \newcommand\thu@titlepage@bachelor{%

1061 | \newgeometry{
1062 | vmargin = 2.54cm,
1063 | hmargin = 3.17cm,
1064 | }%
1065 | \null\vskip 0.44cm%
1066 | \begingroup
1067 | \centering
1068 | \parbox[t][2cm][t]{\textwidth}{%
1069 | \hfill
1070 | \sffamily\CJKfamily+{}\xiaosi
1071 | \ifx\thu@secret@level\@empty
1072 | \phantom{秘密}%
1073 | \else
1074 | \thu@secret@level\makebox[3em][c]{\thu@secret@year} 年%
1075 | \fi\par
1076 | }\par
1077 | \begingroup
1078 | \ifcsname lishu\endcsname
1079 | \lishu\yihao\ziju{0.5} 清华大学%
1080 | \else
1081 | \includegraphics{tsinghua.pdf}%
1082 | \fi
1083 | \par
1084 | \endgroup
1085 | \vskip 0.94cm%
1086 | {\sffamily\bfseries\xiaochu\ziju{0.5} 综合论文训练\par}%
1087 | \vskip 2.3cm%
1088 | \parbox[t][2.4cm][t]{\textwidth}{%
1089 | \heiti\xiaoer[1.56]%
1090 | \parindent=2em%
1091 | \hangindent=5em%
1092 | \makebox[3em][l]{题目：}%
1093 | \yihao[1.56]%

1094 | \CJKunderline[skip=false, thickness=0.05em, depth=0.12em]{\thu@title}\par
1095 | }\par
1096 | \vskip 2.5cm%
1097 | \parbox[t][6.0cm][t]{\textwidth}{%
1098 | \fangsong\sanhao[2.3]%
1099 | \leftskip=2.5cm%
1100 | \parindent=\z@
1101 | \def\thu@cover@item##1##2##3{%
1102 | \ifx##3\@empty\else
1103 | \thu@fixed@box{4em}{##1}：##2{##3}\\
1104 | \fi
1105 | }%
1106 | \def\thu@name@title@format##1##2{%
1107 | \thu@stretch{3em}{##1}\quad ##2%
1108 | }
1109 | \thu@cover@item{系别}{}{\thu@department}%
1110 | \thu@cover@item{专业}{}{\thu@discipline}%
1111 | \thu@cover@item{姓名}{\thu@name@title}{\thu@author}%
1112 | \thu@cover@item{指导教师}{\thu@name@title}{\thu@supervisor}%
1113 | \thu@cover@item{辅导教师}{\thu@name@title}{\thu@associate@supervisor}%
1114 | }\par
1115 | {\xiaosi\thu@format@date{\thu@date@zh@digit}{\thu@date}\par}%
1116 | \endgroup
1117 | \clearpage
1118 | \restoregeometry

1119 }
博士后封面 1120 \newcommand\thu@cover@postdoc{%
1121 | \begin{center}%
1122 | \renewcommand\ULthickness{0.7pt}%
1123 | \vspace*{0.35cm}%
1124 | {\sihao[2.6]%
1125 | \thu@stretch{3.1em}{分类号}\thu@underline[3.7cm]{\thu@clc}\hfill
1126 | 密级\thu@underline[3.7cm]{\thu@secret@level}\par
1127 | \thu@stretch{3.1em}{U D C}\thu@underline[3.7cm]{\thu@udc}\hfill
1128 | 编号\thu@underline[3.7cm]{\thu@id}\par
1129 | }%
1130 | \vskip 3.15cm%
1131 | {\sffamily\bfseries\xiaoer[2.6]%
1132 | {\ziju{1.5} 清华大学\par}%
1133 | {\ziju{0.5} 博士后研究工作报告\par}%
1134 | }%
1135 | \vskip 0.2cm%
1136 | \parbox[t][4.0cm][c]{\textwidth}{%
1137 | \centering\sihao[3.46]\CJKunderline*[depth=1em]{\thu@title}\par
1138 | }\par
1139 | \vskip 0.4cm%

1140 | {\xiaosi\thu@author\par}%
1141 | \vskip 1.4cm%
1142 | {\xiaosi[1.58]\xeCJKsetup{underline/depth=0.9em}%
1143 | 工作完成日期\quad
1144 | \thu@CJKunderline[5.9cm]{%
1145 | \thu@format@date{\thu@date@zh@digit@short}{\thu@start@date}—%
1146 | \thu@format@date{\thu@date@zh@digit@short}{\thu@end@date}
1147 | }\par
1148 | \vskip 0.55cm%
1149 | 报告提交日期\quad
1150 | \thu@CJKunderline[5.9cm]{\thu@format@date{\thu@date@zh@digit@short}{\thu@date}}\par
1151 | }%
1152 | \vskip 0.45cm%
1153 | {\xiaosi[2]{\ziju{1} 清华大学}\quad （北京）\par}%
1154 | \vskip 0.25cm%
1155 | {\xiaosi[2]\thu@format@date{\thu@date@zh@digit@short}{\thu@date}\par}%
1156 | \end{center}%

1157 }
博士后题名页 1158 \newcommand\thu@titlepage@postdoc{%
1159 | \begin{center}%
1160 | \vspace*{1.5cm}%
1161 | \parbox[t][3cm][c]{\textwidth}{%
1162 | \centering\sanhao[1.95]\thu@title\par
1163 | }\par
1164 | \vskip 0.15cm%
1165 | \parbox[t][3cm][c]{\textwidth}{%
1166 | \centering\sihao[1.36]\thu@title@en\par
1167 | }\par
1168 | \vskip 0.4cm%
1169 | {\xiaosi[2.6]%
1170 | \begin{tabular}{l@{\quad}l}%
1171 | \thu@stretch{11em}{博士后姓名} | & \thu@author | \\
1172 | \thu@stretch{11em}{流动站（一级学科）名称} | & \thu@discipline@level@i \\
1173 | \thu@stretch{11em}{专\quad{} 业（二级学科）名称} & \thu@discipline@level@ii \\
1174 | \end{tabular}\par
1175 | }%
1176 | \vskip 2.7cm%
1177 | {\xiaosi[2.6]%
1178 | 研究工作起始时间\quad\thu@format@date{\thu@date@zh@digit}{\thu@start@date}\par
1179 | \vskip 0.1cm%
1180 | 研究工作期满时间\quad\thu@format@date{\thu@date@zh@digit}{\thu@end@date}\par
1181 | }%
1182 | \vskip 2.1cm%
1183 | {\xiaosi[2.6] 清华大学人事部（北京）\par}%
1184 | \vskip 0.6cm%
1185 | {\wuhao\thu@format@date{\thu@date@zh@digit@short}{\thu@date}\par}%

1186 \end{center}%

1187 }
授权说明
\copyrightpage 授权说明
1188 \newcommand{\thu@authorization}{%
1189 \ifthu@degree@bachelor
1190 本人完全了解清华大学有关保留、使用学位论文的规定，即：学校有权保留学位 1191 论文的复印件，允许该论文被查阅和借阅；学校可以公布该论文的全部或部分内 1192 容，可以采用影印、缩印或其他复制手段保存该论文。
1193 \else
1194 本人完全了解清华大学有关保留、使用学位论文的规定，即：

1195
1196 清华大学拥有在著作权法规定范围内学位论文的使用权，其中包括：（1）已获学位的研究生
1197 必须按学校规定提交学位论文，学校可以采用影印、缩印或其他复制手段保存研究生上交的
1198 学位论文；（2）为教学和科研目的，学校可以将公开的学位论文作为资料在图书馆、资料
1199 室等场所供校内师生阅读，或在校园网上供校内师生浏览部分内容\ifthu@degree@master 。\else ； 1200 （3）根据《中华人民共和国学位条例暂行实施办法》，向国家图书馆报送可以公开的学位

1201 论文。\fi

1202
1203 本人保证遵守上述规定。

1204 \fi}
1205 \newcommand{\thu@authorizationaddon}{%
1206 | \ifthu@degree@bachelor(涉密的学位论文在解密后应遵守此规定)\else （保密的论文在解密
| 后应遵守此规定）\fi}
1207 \newcommand{\thu@authorsig}{\ifthu@degree@bachelor 签\hskip1em 名：\else 作
| 者签名：\fi}
1208 \newcommand{\thu@teachersig}{导师签名：}
1209 \newcommand{\thu@frontdate}{%
1210 日\ifthu@degree@bachelor\hspace{1em}\else\hspace{2em}\fi 期：} 1211 \newcommand\copyrightpage[1][]{%
1212 | \ifthu@degree@postdoc\relax\else
1213 | \ifthu@degree@bachelor\clearpage\else\cleardoublepage\fi%
1214 | \def\thu@@tmp{#1}
1215 | \ifx\thu@@tmp\@empty
1216 | \ifthu@degree@bachelor\thu@authorization@mk\else%
1217 | \begin{list}{}{%
1218 | \topsep\z@%
1219 | \listparindent\parindent%
1220 | \parsep\parskip%
1221 | \setlength{\leftmargin}{0.9mm}%
1222 | \setlength{\rightmargin}{0.9mm}}%
1223 | \item[]\thu@authorization@mk%
1224 | \end{list}%
1225 | \fi%
1226 | \else
1227 | \includepdf{#1}%

1228 | \fi
1229 | \fi

1230 }

| 支持扫描文件替换。
1231 \newcommand{\thu@authorization@mk}{%
1232 | \ifthu@degree@bachelor\vspace*{0.2cm}\else\vspace*{0.42cm}\fi % shit code!
1233 | \begin{center}\erhao\heiti 关于学位论文使用授权的说明\end{center}
1234 | \ifthu@degree@bachelor\vskip5pt\else\vskip40pt\sihao[2.03]\fi\par
1235 | \thu@authorization\par
1236 | \textbf{\thu@authorizationaddon}\par
1237 | \ifthu@degree@bachelor\vskip0.7cm\else\vskip1.0cm\fi
1238 | \ifthu@degree@bachelor
1239 | \indent\mbox{\thu@authorsig\thu@underline\relax%
1240 | \thu@teachersig\thu@underline\relax\thu@frontdate\thu@underline\relax}
1241 | \else
1242 | \begingroup
1243 | \parindent0pt\xiaosi
1244 | \hspace*{1.5cm}\thu@authorsig\thu@underline[7em]\relax\hfill%
1245 | \thu@teachersig\thu@underline[7em]\relax\hspace*{1cm}\\[3pt]
1246 | \hspace*{1.5cm}\thu@frontdate\thu@underline[7em]\relax\hfill%
1247 | \thu@frontdate\thu@underline[7em]\relax\hspace*{1cm}
1248 | \endgroup
1249 | \fi}

### 5.5.12 摘要

\thu@clist@use 不同论文格式关键词之间的分割不太相同，我们用 keywords 和 keywords* 来收集关键词列表，然 后用本命令来生成符合要求的格式，类似于 LATEX3 的 \clist_use:Nn。

1250 \thu@define@key{
1251 | keywords,
1252 | keywords* = {
1253 | name = keywords@en,
1254 | },

1255 }
1256 \newcommand\thu@clist@use[2]{%
1257 | \def\thu@@tmp{}%
1258 | \kv@set@family@handler{thu@clist}{%
1259 | \ifx\thu@@tmp\@empty
1260 | \def\thu@@tmp{#2}%
1261 | \else
1262 | #2%
1263 | \fi
1264 | ##1%
1265 | }%
1266 | \kvsetkeys@expandafter{thu@clist}{#1}%

1267 }

\thu@put@keywords 排版关键字。
1268 \newbox\thu@kw
1269 \newcommand\thu@put@keywords[2]{%
1270 | \begingroup
1271 | \setbox\thu@kw=\hbox{#1}
1272 | \ifthu@degree@bachelor\indent\else\noindent\hangindent\wd\thu@kw\hangafter1\fi%
1273 | \box\thu@kw#2\par
1274 | \endgroup}

abstract 中文摘要部分的标题为“摘要”，用黑体三号字。摘要内容用小四号字书写，两端对齐，汉字用宋 体，外文字用 Times New Roman 体，标点符号一律用中文输入状态下的标点符号。 1275 \newenvironment{abstract}{%
1276 | \ifthu@degree@bachelor\clearpage\else\cleardoublepage\fi
1277 | \thu@setchinese
1278 | \thu@chapter*[]{\cabstractname} % no tocline

1279 }{%

| 每个关键词之间空两个汉字符宽度，且为悬挂缩进。
1280 | \ifthu@degree@doctor\vfill\else\vskip12bp\fi
1281 | \thu@put@keywords{\textbf{关键词：}}{%
1282 | \thu@clist@use{\thu@keywords}{；}%
1283 | }%
1284 | \thu@setdefaultlanguage

1285 }

abstract* 英文摘要部分的标题为 Abstract，用 Arial 体三号字。研究生的英文摘要要求非常怪异：虽然正文 前的封面部分为右开，但是英文摘要要跟中文摘要连续。摘要内容用小四号 Times New Roman。 1286 \newenvironment{abstract*}{%
1287 | \thu@setenglish
1288 | \thu@chapter*[]{\eabstractname} % no tocline

1289 }{%
1290 | \ifthu@degree@doctor\vfill\else\vskip12bp\fi
1291 | \thu@put@keywords{%
1292 | \textbf{\ifthu@degree@bachelor Keywords:\else Key Words:\fi\enskip}%
1293 | }{%
1294 | \thu@clist@use{\thu@keywords@en}{; }%
1295 | }%
1296 | \thu@setdefaultlanguage

1297 }

### 5.5.13 主要符号表

denotation 主要符号对照表。
1298 \newenvironment{denotation}[1][2.5cm]{%

1299 | \thu@chapter*[]{\thu@denotation@name} % no tocline
1300 | \vskip-30bp\xiaosi[1.6]\begin{thu@denotation}[labelwidth=#1]

1301 }{%
1302 \end{thu@denotation}

1303 }
1304 \newlist{thu@denotation}{description}{1} 1305 \setlist[thu@denotation]{%
1306 | nosep,
1307 | font=\normalfont,
1308 | align=left,
1309 | leftmargin=!, % sum of the following 3 lengths
1310 | labelindent=0pt,
1311 | labelwidth=2.5cm,
1312 | labelsep*=0.5cm,
1313 | itemindent=0pt,

1314 }

### 5.5.14 致谢以及声明

acknowledgements 支持扫描文件替换。 1315 \newcommand\thu@declarename{声\hspace{\ccwd} 明}
1316 \newcommand{\thu@declaretext}{本人郑重声明：所呈交的学位论文，是本人在导师指导下
1317 | ，独立进行研究工作所取得的成果。尽我所知，除文中已经注明引用的内容外，本学位论
1318 | 文的研究成果不包含任何他人享有著作权的内容。对本论文所涉及的研究工作做出贡献的
1319 | 其他个人和集体，均已在文中以明确方式标明。}
1320 \newcommand{\thu@signature}{签\hspace{1em} 名：}
1321 \newcommand{\thu@backdate}{日\hspace{1em} 期：}
| 定义致谢与声明环境。
1322 \newenvironment{acknowledgements}{%
1323 \thu@chapter*{\thu@ack@name}%

1324 }{}

| 声明部分
1325 \newcommand\statement[1][]{%
1326 | \def\thu@@tmp{#1}%
1327 | \ifx\thu@@tmp\@empty
1328 | \thu@chapter*{\thu@declarename}%
1329 | \par{\xiaosi\parindent2em\thu@declaretext}\vskip2cm%
1330 | {\xiaosi\hfill\thu@signature\thu@underline[2.5cm]\relax
1331 | \thu@backdate\thu@underline[2.5cm]\relax}%
1332 | \else
1333 | \includepdf[pagecommand={\thispagestyle{thu@empty}%
1334 | \addcontentsline{toc}{chapter}{\thu@declarename}%
1335 | }]{#1}%
1336 | \fi

1337 }

5.6 参考文献 | 5 实现细节

### 兼容旧版本保留 acknowledgement。

1338 \let\acknowledgement\acknowledgements
1339 \let\endacknowledgement\endacknowledgements

### 5.5.15 图表索引

\listoffigures
\listoffigures*
\listoftables
\listoftables*

定义图表以及公式目录样式。
1340 \def\thu@starttoc#1{% #1: float type, prepend type name in \listof*** en-try.
1341 | \let\oldnumberline\numberline
1342 | \def\numberline##1{\oldnumberline{\csname #1name\endcsname\hskip.4em ##1}}
1343 | \@starttoc{\csname ext@#1\endcsname}
1344 | \let\numberline\oldnumberline}
1345 \def\thu@listof#1{% #1: float type
1346 | \setcounter{tocdepth}{2} % restore tocdepth in case being modified
1347 | \@ifstar
1348 | {\thu@chapter*[]{\csname list#1name\endcsname}\thu@starttoc{#1}}
1349 | {\thu@chapter*{\csname list#1name\endcsname}\thu@starttoc{#1}}}
1350 \renewcommand\listoffigures{\thu@listof{figure}}
1351 \renewcommand*\l@figure{\ifthu@degree@bachelor\relax\else\addvspace{6bp}\fi\@dottedtocline{1}{0em}{4em}} 1352 \renewcommand\listoftables{\thu@listof{table}}
1353 \let\l@table\l@figure

\equcaption 本命令只是为了生成公式列表，所以这个 caption 是假的。如果要编号最好用 equation 环境， 如果是其它编号环境，请手动添加 \equcaption。用法如下：

### \equcaption{⟨counter⟩}

{⟨counter⟩} 指定出现在索引中的编号，一般取 \theequation，如果你是用 amsmath 的 \tag，那么默认是 \tag 的参数；除此之外可能需要你手工指定。

1354 \def\ext@equation{loe}
1355 \def\equcaption#1{%
1356 | \addcontentsline{\ext@equation}{equation}%
1357 | {\protect\numberline{#1}}}

\listofequations
\listofequations*

LATEX 默认没有公式索引，此处定义自己的 \listofequations。

1358 \newcommand\listofequations{\thu@listof{equation}} 1359 \let\l@equation\l@figure

### 5.6 参考文献

\inlinecite 依赖于 natbib 宏包，修改其中的命令。旧命令 \onlinecite 依然可用。

1360 \DeclareRobustCommand\inlinecite{\@inlinecite}
1361 \def\@inlinecite#1{\begingroup\let\@cite\NAT@citenum\citep{#1}\endgroup} 1362 \let\onlinecite\inlinecite

5.6 参考文献 | 5 实现细节

参考文献的正文部分用五号字。行距采用固定值 16 磅，段前空 3 磅，段后空 0 磅。本科生要 求固定行距 17pt，段前后间距 3pt。

### 复用 natbib 的 thebibliography 环境，调整距离。

1363 \renewcommand\bibsection{\thu@chapter*{\bibname}}
1364 \renewcommand\bibfont{\ifthu@degree@bachelor\wuhao[1.619]\else\wuhao[1.5]\fi} 1365 \setlength\bibhang{2\ccwd}
1366 \addtolength{\bibsep}{-0.7em}
1367 \setlength{\labelsep}{0.4em}
1368 \def\@biblabel#1{[#1]\hfill}

几种种引用样式：
1369 \expandafter\newcommand\csname bibstyle@thuthesis-numeric\endcsname{% 1370 \bibpunct{[}{]}{,}{s}{,}{\textsuperscript{,}}}
1371 \expandafter\newcommand\csname bibstyle@thuthesis-author-year\endcsname{% 1372 \bibpunct{(}{)}{;}{a}{,}{,}}
1373 \expandafter\newcommand\csname bibstyle@thuthesis-bachelor\endcsname{% 1374 \bibpunct{[}{]}{,}{s}{,}{\textsuperscript{,}}}

设置 cite-style 的接口：
1375 \@namedef{bibstyle@thuthesis-inline}{\bibpunct{[}{]}{,}{n}{,}{,}} 1376 \thu@define@key{
1377 | cite-style = {
1378 | name = cite@style,
1379 | code = {
1380 | \@nameuse{bibstyle@thuthesis-\thu@cite@style}
1381 | },
1382 | }

1383 }
下面修改 natbib 的引用格式，主要是将页码写在上标位置。numeric 模式的 \citet 的 页码：
1384 \patchcmd\NAT@citexnum{%
1385 | \@ifnum{\NAT@ctype=\z@}{%
1386 | \if*#2*\else\NAT@cmt#2\fi
1387 | }{}%
1388 | \NAT@mbox{\NAT@@close}%

1389 }{%
1390 | \NAT@mbox{\NAT@@close}%
1391 | \@ifnum{\NAT@ctype=\z@}{%
1392 | \if*#2*\else\textsuperscript{#2}\fi
1393 | }{}%
1394 }{}{}
Numeric 模式的 \citep 的页码：

1395 \renewcommand\NAT@citesuper[3]{\ifNAT@swa
1396 \if*#2*\else#2\NAT@spacechar\fi
1397 \unskip\kern\p@\textsuperscript{\NAT@@open#1\NAT@@close\if*#3*\else#3\fi}% 1398 \else #1\fi\endgroup}

5.7 附录 | 5 实现细节

Author-year 模式的 \citet 的页码：

1399 \patchcmd{\NAT@citex}{%
1400 | \if*#2*\else\NAT@cmt#2\fi
1401 | \if\relax\NAT@date\relax\else\NAT@@close\fi

1402 }{%
1403 | \if\relax\NAT@date\relax\else\NAT@@close\fi
1404 | \if*#2*\else\textsuperscript{#2}\fi
1405 }{}{}
Author-year 模式的 \citep 的页码：

1406 \renewcommand\NAT@cite%
1407 | [3]{\ifNAT@swa\NAT@@open\if*#2*\else#2\NAT@spacechar\fi
1408 | #1\NAT@@close\if*#3*\else\textsuperscript{#3}\fi\else#1\fi\endgroup}
在顺序编码制下，natbib 只有在三个以上连续文献引用才会使用连接号，这里修改为允许 两个引用使用连接号。
1409 \patchcmd{\NAT@citexnum}{%
1410 | \ifx\NAT@last@yr\relax
1411 | \def@NAT@last@yr{\@citea}%
1412 | \else
1413 | \def@NAT@last@yr{--\NAT@penalty}%
1414 | \fi

1415 }{%
1416 \def@NAT@last@yr{-\NAT@penalty}% 1417 }{}{}

### 5.7 附录

研究生和本科生的写作指南均未规定附录的节标题是否加入目录，但是从示例来看，目录中 只出现附录的 chapter 标题，不出现附录中的 section 及 subsection 的标题。部分院系（例如自动 化系）的格式审查的老师甚至一致口头如此要求。（#425） (https://github.com/xueruini/thuthesis/pull/425)
1418 \thu@define@key{
1419 | toc-depth = {
1420 | name = toc@depth,
1421 | code = {\addtocontents{toc}{\protect\setcounter{tocdepth}{\thu@toc@depth}}},
1422 | },

1423 }
1424 \g@addto@macro\appendix{\addtocontents{toc}{\protect\setcounter{tocdepth}{0}}}

本科生《写作指南》有独特的要求：附录 A 为外文资料的调研阅读报告或书面翻译，并且要 分别附上独立的参考文献和外文资料的原文索引。所以这里定义 survey 和 translation 专 门处理这两种情况，其中参考文献使用了 bibunits 宏包的功能。

survey 外文资料的调研阅读报告。
1425 \newenvironment{survey}{%
1426 \chapter{外文资料的调研阅读报告}%

5.7 附录 | 5 实现细节
1427 | \thu@setenglish
1428 | \let\title\thu@appendix@title
1429 | \let\maketitle\thu@appendix@maketitle
1430 | \renewcommand\bibname{参考文献}%
1431 | \let\bibsection\thu@appendix@bibsection
1432 | \renewcommand\@bibunitname{main-survey}%
1433 | \let\bibliographystyle\defaultbibliographystyle
1434 | \let\bibliography\thu@appendix@bibliography
1435 | \begin{bibunit}%

1436 }{%
1437 \end{bibunit}%

1438 }

translation 外文资料的书面翻译。
1439 \newenvironment{translation}{%
1440 | \chapter{外文资料的书面翻译}%
1441 | \thu@setenglish
1442 | \let\title\thu@appendix@title
1443 | \let\maketitle\thu@appendix@maketitle
1444 | \renewcommand\bibname{书面翻译对应的原文索引}%
1445 | \let\bibsection\thu@appendix@bibsection
1446 | \renewcommand\@bibunitname{main-translation}%
1447 | \let\bibliographystyle\defaultbibliographystyle
1448 | \let\bibliography\thu@appendix@bibliography
1449 | \begin{bibunit}%

1450 }{%
1451 \end{bibunit}%

1452 }

调研阅读报告需要独立的标题，这里仿照了标准文档类的用法 \title, \maketitle。

1453 \DeclareRobustCommand\thu@appendix@title[1]{\gdef\thu@appendix@@title{#1}} 1454 \newcommand\thu@appendix@maketitle{%

1455 | \par
1456 | \begin{center}%
1457 | \xiaosi[1.667]\thu@appendix@@title
1458 | \end{center}%
1459 | \par

1460 }

调研阅读报告的参考文献 (或书面翻译对应的外文资料的原文索引) 标题用宋体小四号字，段 前 20pt，段后 6pt，行距 20pt。
1461 \newcommand\thu@appendix@bibsection{%
1462 | \par
1463 | \vskip 20bp%
1464 | \begingroup
1465 | \centering
1466 | \xiaosi[1.667]\bibname\par

5.8 个人简历 | 5 实现细节
1467 | \endgroup
1468 | \vskip 6bp%

1469 }%
1470 \newcommand\thu@appendix@bibliography[1]{\putbib[#1]}

### 5.8 个人简历

resume 个人简历发表文章等。
1471 \newenvironment{resume}[1][\thu@resume@title]{% 1472 \thu@chapter*{#1}}{}

\resumeitem 个人简历部分。每条信息一个段落，故不需要特别处理。 1473 \newcommand{\resumeitem}[1]{%
1474 \vspace{24bp}{\sihao\heiti\centerline{#1}}\par\vspace{6bp}}

\researchitem 研究成果用 \researchitem{⟨类别⟩} 开启，包括“学术论文”和“研究成果”两个列表。

1475 \newcommand{\researchitem}[1]{%
1476 \vspace{32bp}{\sihao\heiti\centerline{#1}}\par\vspace{14bp}}

publications
achievements

### 二者分别通过两个环境 publications 和 achievements 罗列。

1477 \newlist{publications}{enumerate}{1}
1478 \setlist[publications]{label=[\arabic*],align=left,nosep,itemsep=8bp, 1479 leftmargin=10mm,labelsep=!,before=\xiaosi[1.26],resume}
1480 \newlist{achievements}{enumerate}{1}
1481 \setlist[achievements]{label=[\arabic*],align=left,nosep,itemsep=8bp, 1482 leftmargin=10mm,labelsep=!,before=\xiaosi[1.26]}

\publicationskip publications 环境可以连续出现多次，第二类论文列表前后要空一行，使用 \publica-

### tionskip。

1483 \def\publicationskip{\bigskip\bigskip}

### 5.9 其他宏包的设置

这些宏包并非格式要求，但是为了方便同学们使用，在这里进行简单设置。
1484 \newcommand\thu@atendpackage{\csname ctex_at_end_package:nn\endcsname}

### 5.9.1 hyperref 宏包

1485 \thu@atendpackage{hyperref}{
1486 | \hypersetup{
1487 | linktoc | = all,
1488 | bookmarksdepth | = 2,
1489 | bookmarksnumbered = true,
1490 | bookmarksopen | = true,
1491 | bookmarksopenlevel = 1,

5.9 其他宏包的设置 | 5 实现细节
1492 | unicode | = true,
1493 | psdextra | = true,
1494 | breaklinks | = true,
1495 | plainpages | = false,
1496 | pdfdisplaydoctitle = true,
1497 | hidelinks,
1498 | }%
1499 | \newcounter{thu@bookmark}
1500 | \renewcommand\thu@pdfbookmark[2]{%
1501 | \phantomsection
1502 | \stepcounter{thu@bookmark}%
1503 | \pdfbookmark[#1]{#2}{thuchapter.\thethu@bookmark}%
1504 | }
1505 | \renewcommand\thu@phantomsection{%
1506 | \phantomsection
1507 | }
1508 | \pdfstringdefDisableCommands{
1509 | \let\\\@empty
1510 | \let\hspace\@gobble
1511 | }%

hyperref 与 unicode-math 存在一些兼容性问题，见 ustctug/ustcthesis#223， (https://github.com/ustctug/ustcthesis/issues/223)ho-tex/hyperref#90 (https://github.com/ho-tex/hyperref/pull/90) 和 ustctug/ustcthesis/#235。 (https://github.com/ustctug/ustcthesis/issues/235)
1512 | \@ifpackagelater{hyperref}{2019/04/27}{}{%
1513 | \g@addto@macro\psdmapshortnames{\let\mu\textmu}
1514 | }%
1515 | \AtBeginDocument{%
1516 | \ifthu@language@chinese
1517 | \hypersetup{
1518 | pdftitle | = \thu@title,
1519 | pdfauthor | = \thu@author,
1520 | pdfsubject = \thu@degree@name,
1521 | pdfkeywords = \thu@keywords,
1522 | pdflang | = zh-CN,
1523 | }%
1524 | \else
1525 | \hypersetup{
1526 | pdftitle | = \thu@title@en,
1527 | pdfauthor | = \thu@author@en,
1528 | pdfsubject = \thu@degree@name@en,
1529 | pdfkeywords = \thu@keywords@en,
1530 | pdflang | = en-US,
1531 | }%
1532 | \fi
1533 | \hypersetup{
1534 | pdfcreator={\thuthesis-v\version}}
1535 | }%

5.9 其他宏包的设置 | 5 实现细节

1536 }

### 5.9.2 nomencl 宏包

1537 \thu@atendpackage{nomencl}{
1538 | \let\nomname\thu@denotation@name
1539 | \def\thenomenclature{\begin{denotation}[\nom@tempdim]}
1540 | \def\endthenomenclature{\end{denotation}}

1541 }

### 5.9.3 longtable 宏包

我们采用 longtable 来处理跨页的表格。同样我们需要设置其默认字体为五号。

1542 \AtBeginDocument{%
1543 | \let\thu@LT@array\LT@array
1544 | \def\LT@array{\dawu[1.5]\thu@LT@array} % set default font size

1545 }

### 5.9.4 siunitx 宏包

1546 \thu@atendpackage{siunitx}{%
1547 | \sisetup{
1548 | group-minimum-digits = 4,
1549 | separate-uncertainty = true,
1550 | inter-unit-product | = \ensuremath{{}\cdot{}},
1551 | }
1552 | \newcommand\thu@set@siunitx@language{%
1553 | \ifthu@language@chinese
1554 | \sisetup{
1555 | list-final-separator = { 和 },
1556 | list-pair-separator = { 和 },
1557 | range-phrase | = {～},
1558 | }%
1559 | \else
1560 | \ifthu@language@english
1561 | \sisetup{
1562 | list-final-separator = { and },
1563 | list-pair-separator = { and },
1564 | range-phrase | = { to },
1565 | }%
1566 | \fi
1567 | \fi
1568 | }
1569 | \thu@set@siunitx@language
1570 | \thu@addto{language}{\thu@set@siunitx@language}

1571 }

5.10 书脊 | 6 索引

### 5.9.5 ntheorem 宏包

定理标题使用黑体，正文使用宋体，冒号隔开。
1572 \thu@atendpackage{ntheorem}{%
1573 | \theorembodyfont{\normalfont}%
1574 | \theoremheaderfont{\normalfont\sffamily}%
1575 | \theoremsymbol{\ensuremath{\square}}%
1576 | \newtheorem*{proof}{\thu@proof@name}%
1577 | \theoremstyle{plain}%
1578 | \theoremsymbol{}%
1579 | \theoremseparator{\thu@theorem@separator}%
1580 | \newtheorem{assumption}{\thu@assumption@name}[chapter]%
1581 | \newtheorem{definition}{\thu@definition@name}[chapter]%
1582 | \newtheorem{proposition}{\thu@proposition@name}[chapter]%
1583 | \newtheorem{lemma}{\thu@lemma@name}[chapter]%
1584 | \newtheorem{theorem}{\thu@theorem@name}[chapter]%
1585 | \newtheorem{axiom}{\thu@axiom@name}[chapter]%
1586 | \newtheorem{corollary}{\thu@corollary@name}[chapter]%
1587 | \newtheorem{exercise}{\thu@exercise@name}[chapter]%
1588 | \newtheorem{example}{\thu@example@name}[chapter]%
1589 | \newtheorem{remark}{\thu@remark@name}[chapter]%
1590 | \newtheorem{problem}{\thu@problem@name}[chapter]%
1591 | \newtheorem{conjecture}{\thu@conjecture@name}[chapter]%

1592 }

### 5.10 书脊

\spine 单独使用书脊命令会在新的一页产生竖排书脊。 1593 \NewDocumentCommand{\spine}{O{\thu@title} O{\thu@author}}{%
1594 | \newpage\thispagestyle{empty}%
1595 | \fangsong\addCJKfontfeatures*{RawFeature={vertical:}}
1596 | \xiaosan\ziju{0.4}%
1597 | \noindent\hfill\rotatebox[origin=lt]{-90}{\makebox[\textheight]{#1\hfill#2}}}

### 5.11 其它

在模板文档结束时即装入配置文件，这样用户就能在导言区进行相应的修改。 1598 \AtEndOfClass{\sloppy}
1599 ⟨/cls⟩

## 6 索引

Symbols

.bib (file) | 18, 18
.cls (file) | 4, 4
\@@italiccorr |
| 485, 487, 490, 491
\@arabic | 479

6 索引

\@biblabel | 1368
\@bibunitname . . 1432, 1446
\@cite | 1361
\@citea | 1411
\@currentlabel | 481
\@currext | 39
\@currname | 39
\@dotsep | 615, 637
\@dottedtocline . . . . .
. . . 642, 644, 646, 648, 1351
\@fpbot | 498
\@fpsep | 497
\@fptop | 496
\@gobble | 1510
\@height | 441, 523
\@highpenalty . . . 618, 639
\@ifnum | 1385, 1391
\@ifpackagelater . . . 1512
\@ifstar | 480, 1347
\@ifundefined | 51
\@inlinecite . . . . 1360, 1361 \@mainmatterfalse . . . 191 \@mainmattertrue 202, 207
\@makefnmark . . 445, 447, 448
\@makefntext | 447, 448
\@mkboth . . . 534, 600, 602, 605 \@namedef . . . . 27, 31, 34, 36, 37, 38, 49, 50, 64, 81, 1375
\@nameuse | 40, 43,
52, 54, 56, 57, 64, 69, 71, 75, 76, 77, 78, 81, 82, 83, 1380
\@nil | 732, 735
\@pnumwidth |
. . . . 613, 614, 622, 623, 642
\@starttoc | 612, 1343
\@tabular | 198, 507
\@tempdima | 620, 625
\@thefnmark | 446
\@tocrmarg | 614
\@width | 441
\@xhline | 524

A
\A | 154
\a | 156
\abovedisplayshortskip
| 294, 296

\abovedisplayskip 293, 295 abstract (environment) . .
| 15, 1275
abstract* (environment) .
| 15, 1286
achievements (environ-
ment) | 21, 1477
\acknowledgement . . . 1338 acknowledgement (envi-
ronment) | 19
\acknowledgements . . 1338 acknowledgements (envi-
ronment) | 1315
\addCJKfontfeatures 1595
\addcontentsline . . . .
| 589, 593, 1334, 1356
\addpenalty | 618
\addtocontents . 1421, 1424
\addtolength | 1366
\addvspace | 1351
\advance | 625
\allowdisplaybreaks . 478
\alph | 519, 520
amsmath (package) |
| 16, 37, 37, 37, 60
amssymb (package) | 37
\appendix . . . . 504, 505, 1424
\apptocmd | 448
\arabic . . 504, 505, 1478, 1481 \AtEndOfClass . . . 42, 1598
\awint | 461

B
\B | 154
\b | 156
\backmatter | 189
\bahao | 300
\banxiaosi . . . . 300, 566, 567 \belowdisplayshortskip
| 296
\belowdisplayskip . . . 295
\bibfont | 1364
\bibhang | 1365
\bibliography . . 1434, 1448 \bibliographystyle . .
| 1433, 1447

\bibname 1363, 1430, 1444, 1466
\bibpunct |
. . . . 1370, 1372, 1374, 1375 \bibsection 1363, 1431, 1445
\bibsep | 1366
bibunits (package) | 62
\bigskip | 1483
\bm | 472
bm (package) | 37
\boldsymbol | 472
book.cls (file) | 39
booktabs (package) | 39
\bottomfraction | 501
\box | 764, 771, 773, 1273
bst (file) | 19, 19

C
\C | 154
\c | 156
\c@chapter | 479
\c@equation | 479
\c@thu@csl@count . . . . 778
\c@tocdepth | 617
\cabstractname |
| 526, 529, 1278
caption (package) | 27
caption2 (package) | 27
\captionsetup . . . 511, 518 \ccwd . . 338, 363, 510, 529, 534, 547, 644, 646, 1315, 1365
\cdot | 1550
\cdots | 450
\centerline | 1474, 1476
\chapter . . . . 596, 1426, 1440
\chaptermark | 534
\checkmark | 475
\chuhao | 300
\cirfnint | 461
cite-style (option) . . . . 18
\citep | 1361
\CJKfamily . . . 880, 893, 1070 \CJKglue . . . 751, 760, 892, 949 \CJKunderline 748, 1094, 1137 \ClassError . . . . 18, 434, 581 \cleardoublepage . . . .
. . . . 185, 190, 201, 206, 583, 797, 803, 825, 1213, 1276

6 索引

\clearpage . . . . 187, 190, 201, 206, 583, 806, 852,
876, 964, 1117, 1213, 1276
\comma@parse | 793
\contentsname | 611
\copyrightpage . . 14, 1188 ctex (package) . . . 11, 26, 31, 31 ctexbook (package) 26, 26, 26 \ctexset 335, 414, 542, 595, 597
\CTEXthechapter | 534
\CurrentOption | 125

D
\D | 154
\d | 156
data/ (file) | 5
data/resume.tex (file) . 21
\dawu | 300, 508, 509, 1544
\day | 708, 723, 727
\DeclareBoolOption . . 124 \DeclareCaptionFont . 509
\DeclareCaptionLabelSeparator
| 510
\DeclareDefaultOption
| 125
\DeclareRobustCommand
| 1360, 1453
\def@NAT@last@yr . . . .
| 1411, 1413, 1416
\defaultbibliographystyle
| 1433, 1447
degree (option) | 10
denotation (environment)
| 16, 1298
description (environ-
ment) | 17
\df@tag | 481
\dimexpr | 299
\do | 153, 154, 155, 156, 157

E
\E | 154
\e | 156
\eabstractname |
| 527, 530, 538, 1288
\empty | 1004
\endacknowledgement 1339

\endacknowledgements
| 1339
\endthenomenclature 1540
\enskip | 1292
\ensuremath . 476, 1550, 1575 enumerate (environment) . 17 enumitem (package) 17, 17, 35

environments:
abstract | 15, 1275
abstract* | 15, 1286
achievements . . 21, 1477
acknowledgement . . 19
acknowledgements 1315
denotation . . . . 16, 1298
description | 17
enumerate | 17
itemize | 17
publications . . 20, 1477
resume | 20, 1471
survey | 19, 1425
translation . . . 19, 1439
\eqref | 492
\equal | 209, 235, 262,
275, 419, 422, 538, 585, 599
\equationname |
| 348, 376, 485, 487
\equcaption . . 487, 491, 1354
\erhao | 300, 1233
\ext@equation . . 1354, 1356

F
\F | 154
\f | 156
\fancyfoot . . . . 404, 410, 411 fancyhdr (package) . . . . .
| 28, 39, 39, 39, 39
\fancyhead . . . . 403, 408, 409
\fancyhf | 399
\fancypagestyle . . . . .
| 398, 402, 407
\fangsong 917, 932, 1098, 1595

file:
.bib | 18, 18
.cls | 4, 4
book.cls | 39
bst | 19, 19
data/ | 5
data/resume.tex . . 21
latexmk | 4
main.tex | 4, 5
Makefile | 4
spine.tex | 21
thusetup.tex | 7
thuthesis-*.bst . . . 5
thuthesis-author-
year.bst | 5
thuthesis-
numeric.bst | 5
thuthesis.cls . 4, 4, 4, 5 thuthesis.dtx . . . 4, 4, 5
thuthesis.ins | 4, 5
thuthesis.pdf | 4
tsinghua.pdf | 5, 5
\fint | 461
\floatpagefraction . . . 502
\floatsep | 493
\fontsize | 299, 1021
fontspec (package) . . . 11, 29
\footnotemargin | 444
\footnoterule | 441
\footrulewidth 401, 406, 413
\frontmatter | 189
\futurelet | 523

G
\G | 154
\g | 156
\g@addto@macro . . . 70,
87, 152, 504, 505, 1424, 1513 \gdef 481, 779, 781, 791, 792, 1453
\ge | 452
\geometry | 161, 166, 176
\geq | 452
\geqslant | 453, 456

H
\H | 154
\h | 156
\hangafter | 1272
\hangindent | 1091, 1272
\hb@xt@ | 642, 747, 748
\hbox | 446, 637, 642, 1271
\headrulewidth 400, 405, 412

6 索引

\heiti 632, 1089, 1233, 1474, 1476 \hfill 637, 1069, 1125, 1127, 1244, 1246, 1330, 1368, 1597
\hlinewd | 522
\hrule | 441, 523
\hspace 338, 363, 510, 529, 1210, 1244, 1245, 1246,
1247, 1315, 1320, 1321, 1510
\hss | 747, 748
hyperref (package) . 2, 64, 65
\hypersetup |
. . . . 1486, 1517, 1525, 1533
\hyphenation | 7
| I
\I | 154
\i | 156
\if@openright |
| 190, 201, 206, 583
\IfBooleanF | 580
\ifcsname | 1078
\iffalse | 482
\IfFileExists | 264
\IfFontExistsTF . 247, 425
\ifNAT@swa | 1395, 1407
\ifthenelse 209, 235, 262, 275, 419, 422, 537, 585, 599 \ifthu@degree@bachelor
| 165,
192, 204, 364, 392, 483,
503, 525, 536, 545, 546,
548, 549, 558, 559, 560,
564, 566, 567, 571, 573,
595, 597, 612, 619, 631,
646, 648, 820, 1189, 1206, 1207, 1210, 1213, 1216,
1232, 1234, 1237, 1238,
1272, 1276, 1292, 1351, 1364 \ifthu@degree@doctor
| 92, 898, 1280, 1290
\ifthu@degree@graduate
| 89, 628, 802, 809
\ifthu@degree@master
| 95, 1026, 1199
\ifthu@degree@postdoc
| 367, 823, 1212

\ifthu@degree@type@academic
| 810, 920, 935, 959
\ifthu@degree@type@professional
| 894, 1037
\ifthu@language@chinese
. . 328, 334, 449, 1516, 1553 \ifthu@language@english
| 1560
\ifthu@raggedbottom . 139
\IfValueTF | 584, 598
\ignorespaces |
| 485, 487, 490, 491
\iiiint | 459
\iiint | 459
\iint | 459
\Im | 465
\includegraphics . . . 1081
\includepdf | 1227, 1333
\includepdfset | 136
\indent | 1239, 1272
\inlinecite | 18, 1360
\int | 458
\intBar | 461
\intbar | 461
\intcap | 463
\intclockwise | 460
\intcup | 463
\intextsep | 495
\intlarhk | 462
\intx | 462
\item | 1223
itemize (environment) . . . 17

J
\J | 154
\j | 156

K
\K | 154
\k | 156
\kern | 1397
\kv@define@key |
| 30, 33, 47, 60, 80
\kv@set@family@handler
| 26, 65, 1258
kvoptions (package) . . . . 23 \kvsetkeys . . . . 16, 21, 24, 63 kvsetkeys (package) . . 12, 46 \kvsetkeys@expandafter
| 74, 1266

L
\L | 154
\l | 156
\l@chapter | 616
\l@equation | 1359
\l@figure . . . 1351, 1353, 1359
\l@section | 643
\l@subsection | 645
\l@subsubsection . . . . 647
\l@table | 1353
\labelsep | 1367
language (option) | 11
latexmk (file) | 4
latexmk (package) | 4
\ldots | 449
\le | 452
\leaders | 637
\leavevmode | 624
\leftmargin | 1221
\leftmark | 409
\leftskip . . . . 625, 626, 1099
\leq | 452
\leqslant | 452, 455
\lishu | 1079
\listequationname 347, 375
\listof | 1340
\listofequations 15, 1358
\listofequations* 15, 1358 \listoffigures . . . 15, 1340 \listoffigures* . . 15, 1340 \listoftables . . . 15, 1340 \listoftables* . . 15, 1340
\listparindent | 1219
\liuhao | 300
longtable (package) 2, 66, 66
\lowint | 463
\LT@array | 1543, 1544

M
\M | 154
\m | 156
\m@th | 637
main.tex (file) | 4, 5

6 索引

\mainmatter | 189
\make@df@tag | 480
\make@df@tag@@@ | 480
\makebox . . . 752, 761, 771, 884, 1044, 1074, 1092, 1597
Makefile (file) | 4
\maketag@@@ 484, 486, 490, 491 \maketitle 14, 796, 1429, 1443
\mathellipsis | 450
\mbfnabla | 470
\mbox | 1239
\mdlgwhtsquare | 474
\mkern | 637
\month | 708, 723, 727
\mu | 1513

N
\N | 155
\n | 157
\nabla | 469
\NAT@@close | 1388,
1390, 1397, 1401, 1403, 1408
\NAT@@open | 1397, 1407
\NAT@cite | 1406
\NAT@citenum | 1361
\NAT@citesuper | 1395
\NAT@citex | 1399
\NAT@citexnum . . 1384, 1409
\NAT@cmt | 1386, 1400
\NAT@ctype | 1385, 1391
\NAT@date | 1401, 1403
\NAT@last@yr | 1410
\NAT@mbox | 1388, 1390
\NAT@penalty . . . . 1413, 1416 \NAT@spacechar . 1396, 1407
natbib (package) |
| 18, 60, 61, 61, 62
\NeedsTeXFormat | 1
\newbox | 755, 767, 1268
\NewDocumentCommand .
| 579, 1593
\newfontfamily |
| 420, 423, 426, 428
\newgeometry |
| 832, 856, 954, 1061
\newif | 69, 89

\newlist . . . 1304, 1477, 1480
\newpage | 1594
\newtheorem |
. 1576, 1580, 1581, 1582,
1583, 1584, 1585, 1586,
1587, 1588, 1589, 1590, 1591
\noalign | 523
\nobreak | 638
\nom@tempdim | 1539
nomencl (package) 2, 16, 17, 66
\nomname | 1538
\normalsize | 291
notoccite (package) . . . . 29
\npolint | 462
ntheorem (package) . . . . 2, 67 \null . 837, 861, 970, 995, 1065
\number | 737, 738, 741
\numberline |
. . . . 1341, 1342, 1344, 1357
\numexpr | 437

O
\O | 155
\o | 157
\oiiint | 459
\oiint | 459
\oint | 459
\ointctrclockwise . . . 460
\old@tabular | 507, 508
\oldnumberline |
| 1341, 1342, 1344
\onlinecite | 1362
\operatorname . . . 466, 467

option:
cite-style | 18
degree | 10
language | 11
toc-depth | 19

P
\P | 155
\p | 157
\p@subfigure | 521
package:
amsmath . 16, 37, 37, 37, 60
amssymb | 37
bibunits | 62
bm | 37
booktabs | 39
caption | 27
caption2 | 27
ctex | 11, 26, 31, 31
ctexbook | 26, 26, 26
enumitem | 17, 17, 35
fancyhdr 28, 39, 39, 39, 39
fontspec | 11, 29
hyperref | 2, 64, 65
kvoptions | 23
kvsetkeys | 12, 46
latexmk | 4
longtable | 2, 66, 66
natbib . . . 18, 60, 61, 61, 62
nomencl | 2, 16, 17, 66
notoccite | 29
ntheorem | 2, 67
pdfpages | 27
siunitx | 2, 66
subcaption | 27
subfig | 27
subfigure | 27
unicode-math . 27, 30, 65
xeCJK | 11
xeCJKfntef | 27
xurl | 28
\pagenumbering 197, 203, 799
\pagestyle |
187, 193, 195, 204, 533, 798 \parbox 840, 849, 850, 864, 873, 874, 984, 1011, 1068, 1088, 1097, 1136, 1161, 1165
\parfillskip | 623
\parindent | 622,
1090, 1100, 1219, 1243, 1329
\parsep | 1220
\PassOptionsToClass . 125
\PassOptionsToPackage
| 127
\patchcmd 642, 1384, 1399, 1409
\pdfbookmark | 1503
pdfpages (package) | 27
\pdfstringdefDisableCommands
| 1508
\penalty | 639

6 索引

\phantom | 882, 1072
\pointint | 462
\pretocmd | 447
\ProcessKeyvalOptions
| 126
\protected | 452, 453
\ProvidesClass | 2
\ps@thu@empty | 398
\ps@thu@headings . . . . 398
\ps@thu@plain | 398
\psdmapshortnames . . 1513 publications (environ-
ment) | 20, 1477
\publicationskip 20, 1483
\putbib | 1470

Q
\Q | 155
\q | 157
\qihao | 300

R
\R | 155
\r | 157
\raggedbottom | 141
\Re | 465
\removenolimits | 458
\RequireXeTeX | 5
\researchitem . . . 20, 1475
\reserved@a | 524
\restoregeometry . . . .
| 853, 877, 965, 1118
resume (environment) 20, 1471
\resumeitem | 20, 1473
\rightmargin | 1222
\rightskip | 622
\rotatebox | 1597
\rppolint | 461

S
\S | 155
\s | 157
\sanhao | 300,
549, 880, 917, 932, 950,
973, 998, 1056, 1098, 1162
\sbox | 757, 769
\scpolint | 462
\selectfont | 299, 1021
\setbox | 1271
\setCJKfamilyfont 266,
269, 272, 273, 283, 287, 288 \setCJKmainfont . . . . .
| 265, 268, 276
\setCJKsansfont . 271, 282 \setlist 418, 1305, 1478, 1481
\setmainfont | 210, 233
\setmathfont |
| 248, 253, 255, 260
\setmonofont . . 224, 236, 238
\setsansfont | 217, 234
\SetupKeyvalOptions . 13
\sihao . . . . 300, 560, 1124, 1137, 1166, 1234, 1474, 1476 \sisetup . . . 1547, 1554, 1561
siunitx (package) | 2, 66
\sloppy | 1598
\spine | 21, 1593
spine.tex (file) | 21
\sqint | 462
\square | 474, 1575
\statement | 19, 1325
\stepcounter . . . . 783, 1502 subcaption (package) . . . 27
subfig (package) | 27
subfigure (package) | 27
\sumint | 460
survey (environment) 19, 1425
\symbf | 472, 473
\symbol | 437

T
\T | 155
\t | 157
\tableofcontents . 15, 610
\tagform@ | 486, 491
\text | 485, 487
\textfloatsep | 494
\textfraction | 499
\textheight | 1597
\textmu | 1513
\textsuperscript 1370,
1374, 1392, 1397, 1404, 1408
\textup | 492
\textwidth |
. 441, 840, 849, 850, 864, 873, 874, 984, 1011, 1068, 1088, 1097, 1136, 1161, 1165
\the | 437, 708, 723, 727
\thechapter . . . 479, 504, 505
\theequation | 479
\thefigure | 504
\thefootnote | 439
\thempfootnote | 440
\thenomenclature . . . 1539 \theorembodyfont . . . 1573 \theoremheaderfont . 1574
\theoremseparator . . 1579
\theoremstyle | 1577
\theoremsymbol . 1575, 1578
\thepage | 404, 411
\thesubfigure | 519
\thesubtable | 520
\thetable | 505
\thethu@bookmark . . . 1503 \thispagestyle . 1333, 1594 \thu@@choices . . 29, 48, 74
\thu@@date | 731, 735
\thu@@default |
| 28, 61, 66, 67, 75
\thu@@makefnmark 446, 447
\thu@@name . . . . 779, 791, 794 \thu@@process@date . .
| 732, 735
\thu@@title . . . 781, 792, 794 \thu@@tmp . . . 1214, 1215, 1257, 1259, 1260, 1326, 1327 \thu@ack@name 363, 391, 1323
\thu@addto | 86, 1570
\thu@appendix@@title
| 1453, 1457
\thu@appendix@bibliography
| 1434, 1448, 1470
\thu@appendix@bibsection
| 1431, 1445, 1461
\thu@appendix@maketitle
| 1429, 1443, 1454
\thu@appendix@title .
| 1428, 1442, 1453

6 索引

\thu@associate@supervisor
| 927, 943, 1113
\thu@associate@supervisor@en
| 1046, 1047
\thu@assumption@name
| 349, 377, 1580
\thu@atendpackage . . .
1484, 1485, 1537, 1546, 1572
\thu@author |
. . . . 922, 924, 937, 940, 1111, 1140, 1171, 1519, 1593
\thu@author@en |
| 982, 1003, 1527
\thu@authorization . .
| 1188, 1235
\thu@authorization@mk
| 1216, 1223, 1231
\thu@authorizationaddon
| 1205, 1236
\thu@authorsig |
| 1207, 1239, 1244
\thu@axiom@name . . . . .
| 354, 382, 1585
\thu@backdate . . 1321, 1331
\thu@chapter |
| 579, 581, 611,
1278, 1288, 1299, 1323,
1328, 1348, 1349, 1363, 1472
\thu@chapter* | 577
\thu@chapter@titleformat
| 535, 552
\thu@circlefont . . . . .
. . . . 420, 423, 426, 428, 437 \thu@cite@style . . . . 1380 \thu@CJKunderline . . .
| 748, 1144, 1150
\thu@clc | 1125
\thu@cleardoublepage
| 185, 187
\thu@clearemptydoublepage
| 186, 188
\thu@clist@use |
| 1250, 1282, 1294
\thu@conjecture@name
| 360, 388, 1591

\thu@corollary@name .
| 355, 383, 1586
\thu@cover@info@tabular
| 904, 918, 933
\thu@cover@item . . . . .
| 905, 919,
921, 922, 924, 926, 927,
928, 934, 936, 937, 939,
940, 942, 943, 944, 1101,
1109, 1110, 1111, 1112, 1113 \thu@cover@postdoc . .
| 824, 1120
\thu@date | 950,
1057, 1115, 1150, 1155, 1185 \thu@date@en@short . .
| 746, 1057
\thu@date@month . 740, 746 \thu@date@zh@digit . .
| 737, 1115, 1178, 1180
\thu@date@zh@digit@short
| 738,
1145, 1146, 1150, 1155, 1185 \thu@date@zh@short . .
| 739, 950
\thu@declarename . . . .
| 1315, 1328, 1334
\thu@declaretext 1316, 1329 \thu@def@fontsize . . .
| 297, 300, 301,
302, 303, 304, 305, 306,
307, 308, 309, 310, 311,
312, 313, 314, 315, 316, 317
\thu@define@key |
23, 99, 649, 1250, 1376, 1418 \thu@definition@name .
| 350, 378, 1581
\thu@degree@graduatefalse
| 91
\thu@degree@graduatetrue
| 93, 96
\thu@degree@name 894, 1520 \thu@degree@name@en .
| 1041, 1528
\thu@denotation@name
| 346, 374, 1299, 1538

\thu@department . . . . .
| 919, 934, 1109
\thu@discipline . . . . .
. . . 813, 921, 936, 939, 1110 \thu@discipline@en . .
| 978, 1004, 1008
\thu@discipline@level@i
| 1172
\thu@discipline@level@ii
| 1173
\thu@end@date . . 1146, 1180
\thu@error | 17, 54
\thu@example@name . . .
| 357, 385, 1588
\thu@exercise@name . .
| 356, 384, 1587
\thu@fixed@box 749, 907, 1103
\thu@fontset | 208,
209, 235, 262, 275, 419, 422 \thu@footnotesize 442, 443 \thu@format@date . . . .
| 730, 950,
1057, 1115, 1145, 1146,
1150, 1155, 1178, 1180, 1185
\thu@frontdate |
. . . . 1209, 1240, 1246, 1247
\thu@id | 1128
\thu@joint@supervisor
| 928, 944
\thu@joint@supervisor@en
| 1049, 1050
\thu@keywords . . 1282, 1521 \thu@keywords@en 1294, 1529 \thu@kw 1268, 1271, 1272, 1273 \thu@lemma@name . . . . .
| 352, 380, 1583
\thu@listof |
. . . . 1345, 1350, 1352, 1358 \thu@LT@array . . 1543, 1544 \thu@make@df@tag@@ . .
| 480, 481
\thu@makefnmark . 445, 448 \thu@maketag . . 481, 484, 490 \thu@name@title . . . . .
. . . . 789, 922, 924, 926,

6 索引

927, 928, 937, 940, 942,
943, 944, 1111, 1112, 1113 \thu@name@title@format
| 785, 794, 1106
\thu@name@title@process
| 777, 793
\thu@pad . . . 768, 786, 907, 908
\thu@pad@box |
. . . . 767, 769, 770, 771, 773 \thu@pdfbookmark . . . .
| 577, 586, 800, 1500
\thu@phantomsection .
| 578, 588, 592, 1505
\thu@problem@name . . .
| 359, 387, 1590
\thu@proof@name . . . . .
| 361, 389, 1576
\thu@proposition@name
| 351, 379, 1582
\thu@put@keywords . . .
| 1268, 1281, 1291
\thu@remark@name . . . .
| 358, 386, 1589
\thu@resume@title . . .
365, 368, 370, 393, 395, 1471 \thu@secret@level . . .
. 881, 884, 1071, 1074, 1126 \thu@secret@year 884, 1074 \thu@set@graduate 90, 108
\thu@set@siunitx@language
| 1552, 1569, 1570
\thu@setchinese . . . . .
| 318, 329, 1277
\thu@setdefaultlanguage
| 327, 1284, 1296
\thu@setenglish . . . . .
. 321, 331, 1287, 1427, 1441 \thu@signature . 1320, 1330 \thu@start@date 1145, 1178
\thu@starttoc |
| 1340, 1348, 1349
\thu@stretch |
. . . 756, 786, 787, 1107, 1125, 1127, 1171, 1172, 1173 \thu@stretch@box . . . .
| 755, 757, 758, 764

\thu@supervisor . . . . .
| 926, 942, 1112
\thu@supervisor@en . 1045
\thu@tabular | 198, 508
\thu@teachersig . . . . .
| 1208, 1240, 1245
\thu@textcircled . . . . 419 \thu@theorem@name . . .
| 353, 381, 1584
\thu@theorem@separator
| 362, 390, 1579
\thu@thesis@name@en .
| 1025, 1033, 1045
\thu@title . 800, 869, 888, 1094, 1137, 1162, 1518, 1593
\thu@title@en |
| 1022, 1166, 1526
\thu@titlepage . . 801, 808 \thu@titlepage@bachelor
| 821, 1060
\thu@titlepage@date .
| 850, 874, 947
\thu@titlepage@degree
| 847, 871, 890
\thu@titlepage@en 804, 953 \thu@titlepage@en@date
| 988, 1015, 1054
\thu@titlepage@en@degree
| 974, 999, 1032
\thu@titlepage@en@graduate@academic
| 960, 967
\thu@titlepage@en@graduate@professional
| 962, 992
\thu@titlepage@en@supervisor
| 986, 1013, 1043
\thu@titlepage@en@title
| 971, 996, 1019
\thu@titlepage@graduate@academic
| 811, 816, 831
\thu@titlepage@graduate@professional
| 814, 855
\thu@titlepage@info .
| 849, 873, 897
\thu@titlepage@info@doctor
| 899, 916

\thu@titlepage@info@master
| 901, 931
\thu@titlepage@postdoc
| 826, 1158
\thu@titlepage@secret
| 842, 866, 879
\thu@titlepage@title
| 845, 887
\thu@toc@depth | 1421
\thu@udc | 1127
\thu@underline |
. 747, 1125, 1126, 1127,
1128, 1239, 1240, 1244,
1245, 1246, 1247, 1330, 1331
\thusetup | 12, 20
thusetup.tex (file) | 7
\thuthesis | 8, 1534
thuthesis-*.bst (file) . . 5 thuthesis-author-
year.bst (file) | 5
thuthesis-numeric.bst
(file) | 5
thuthesis.cls (file) . . .
| 4, 4, 4, 5
thuthesis.dtx (file) . 4, 4, 5 thuthesis.ins (file) . . . 4, 5 thuthesis.pdf (file) . . . . 4
\title | 1428, 1442
toc-depth (option) | 19
\topfraction | 500
\topsep | 1218
translation (environ-
ment) | 19, 1439
tsinghua.pdf (file) . . . . 5, 5 \two@digits . . . 708, 723, 727

U
\U | 155
\u | 157
\ULthickness | 1122
\underline | 747
unicode-math (package) .
| 27, 30, 65
\unimathsetup | 241
\unskip 485, 487, 490, 491, 1397
\upint | 463

6 索引

\UrlBreaks | 152
\Urlmuskip | 159
\urlstyle | 151

V
\V | 155
\v | 157
\value | 433, 437
\varointclockwise . . . 460
\version | 9, 1534
\vfill | 848,
872, 972, 997, 1280, 1290

W
\W | 155
\w | 157
\wd | 758, 770, 1272
\wuhao 300, 409, 411, 1185, 1364

X
\X | 155
\x | 157
xeCJK (package) | 11
\xeCJKDeclareCharClass
| 322, 323
xeCJKfntef (package) . . . 27 \xeCJKResetPunctClass
| 319
\xeCJKsetup | 263, 1142
\xeCJKsetwidth | 289
\xiaochu | 300, 1086
\xiaoer . . 300, 893, 1089, 1131
\xiaoliu | 300
\xiaosan |
. . 300, 549, 985, 1012, 1596 \xiaosi 300, 566, 573, 612, 1070, 1115, 1140, 1142,
1153, 1155, 1169, 1177,

1183, 1243, 1300, 1329,
1330, 1457, 1466, 1479, 1482
\xiaowu | 300, 404, 443
\xiaoyi | 300
xurl (package) | 28

Y
\Y | 155
\y | 157
\year | 708, 723, 727
\yihao 300, 869, 888, 1079, 1093

Z
\Z | 155
\z | 157
\zhdigits | 739
\zhnumber | 739
\ziju | 1079,
1086, 1132, 1133, 1153, 1596
