PeterBee97/Gradesign/机械设计/渲染图1.JPG

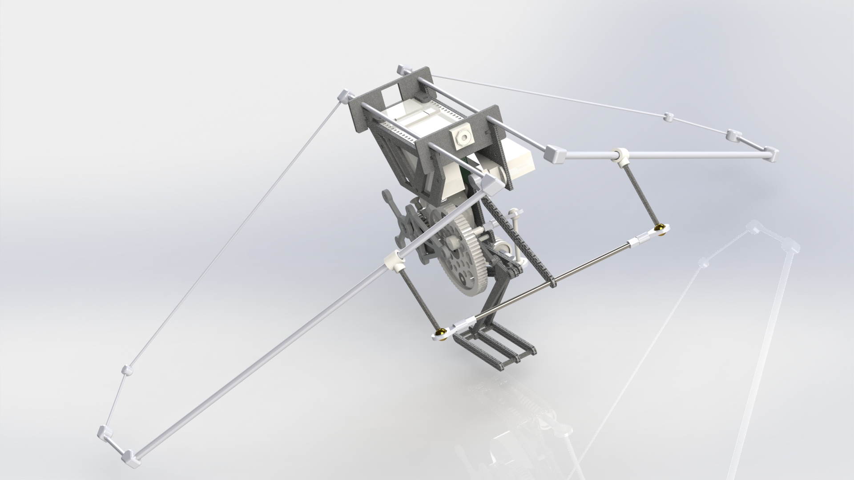
机械设计/渲染图1.JPG
