PeterBee97/Gradesign/机械设计/M2球头关节.SLDASM

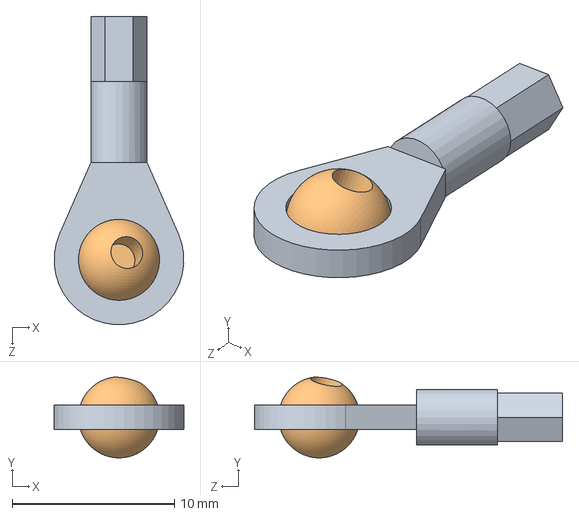
[picture p77: CAD file, 2020-05-10]
机械设计/M2球头关节.SLDASM
7.98 x 4.98 x 19.0 mm
M2球头
零件2^M2球头关节
