PeterBee97/Gradesign/机械设计/腿_装配.SLDASM

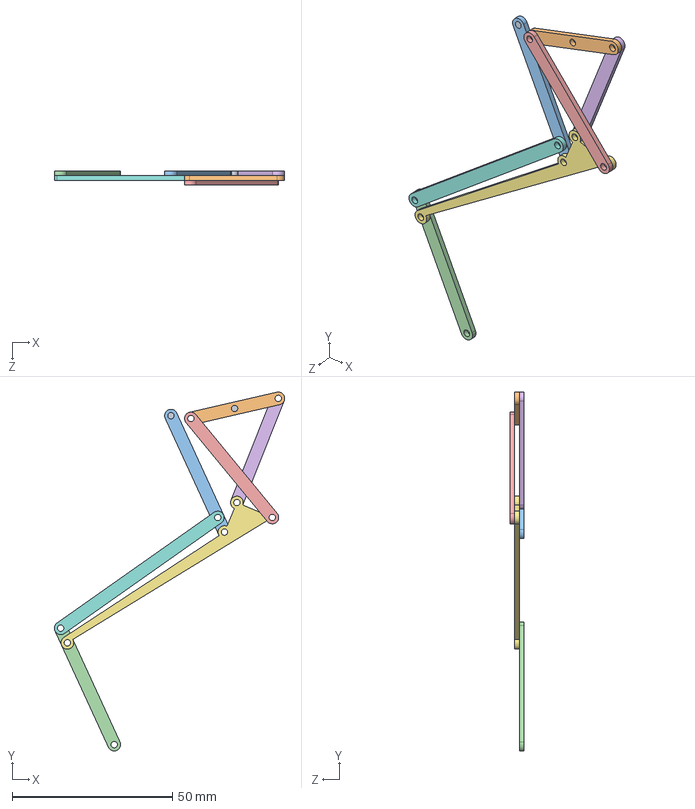
[picture p78: CAD file, 2020-05-10]
机械设计/腿_装配.SLDASM
71.9 x 112.1 x 4.50 mm
2d_leg_sim_test
摇臂
大腿
脚
连杆A
连杆B
曲柄块
小腿
