PeterBee97/Gradesign/机械设计/舵机装配.SLDASM

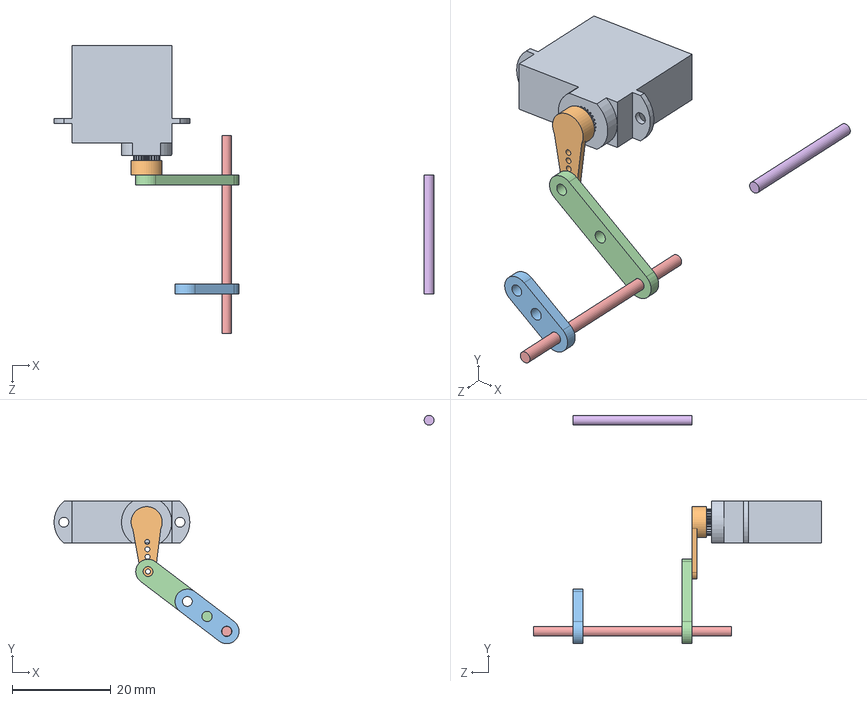
[picture p79: CAD file, 2020-05-10]
机械设计/舵机装配.SLDASM
76.9 x 46.2 x 58.2 mm
4.3g舵机
舵机臂
延长杆2
延长杆1
摇臂长杆^舵机装配
摇臂短杆^舵机装配
