PeterBee97/Gradesign/机械设计/主体装配.SLDASM

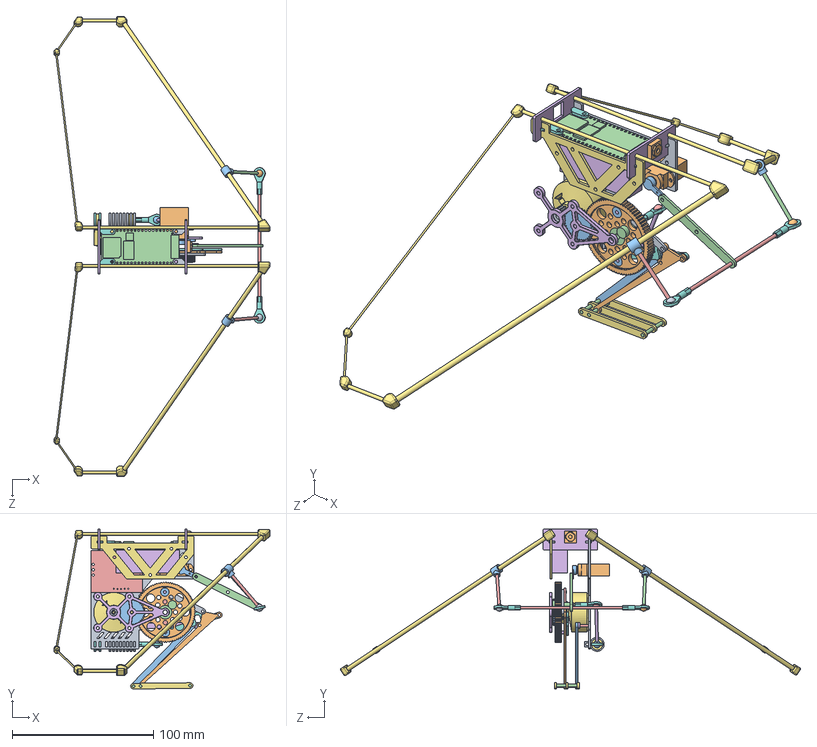
[picture p80: CAD file, 2020-05-10]
机械设计/主体装配.SLDASM
152.6 x 113.1 x 325.2 mm
主板
4.3g舵机
舵机臂
延长杆1
摇臂长杆^主体装配
减速器
X2305电机
圆柱齿轮10×0.5
圆柱齿轮15×0.5
圆柱齿轮80×0.5
圆柱齿轮36×0.5
nanopi_duo2
795532117DJFLY-DG.step
机翼支架 x 2
机翼 x 2
M2球头 x 4
万向节^主体装配
万向节2^主体装配
机翼接头 x 2
零件3^主体装配
零件4^主体装配
2S电池300mAh^主体装配
子板
长楔 x 2
短楔2 x 2
摄像头^主体装配
L-620ZZ轴承^主体装配
R2ZZ轴承^主体装配
摇臂
大腿
脚 x 3
连杆A
连杆B
曲柄块
小腿
2x14.5杆 x 3
大腿根^主体装配
齿轮双轴^主体装配
磁铁 x 2
磁铁支架 x 2
磁铁轴承支架 x 8
磁铁接触杆^主体装配
复件 零件2^主体装配
零件6^主体装配
复件 (2) 零件2^主体装配
磁铁连杆^主体装配
