PeterBee97/Gradesign/机械设计/减速器装配.SLDASM

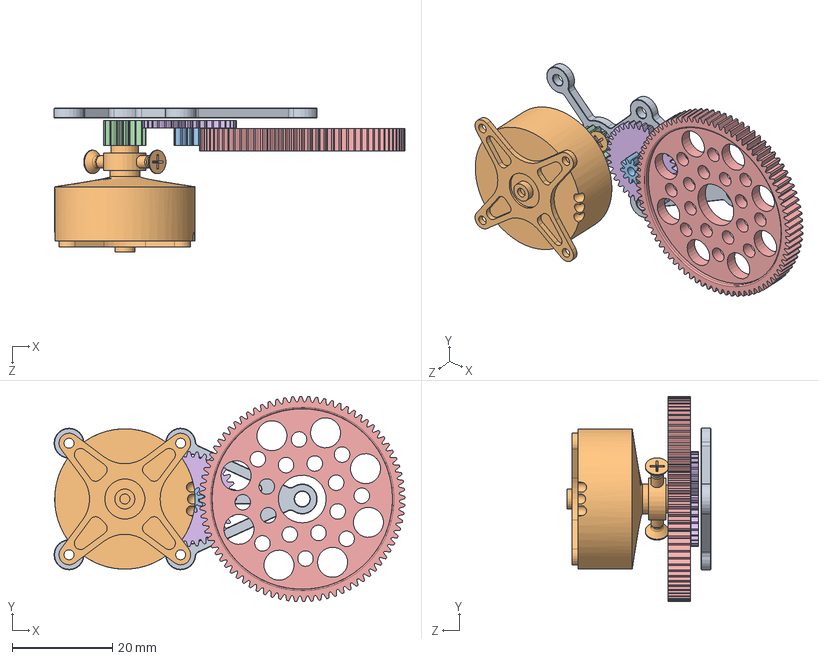
[picture p81: CAD file, 2020-05-10]
机械设计/减速器装配.SLDASM
70.0 x 41.0 x 28.7 mm
减速器
X2305电机
圆柱齿轮10×0.5
圆柱齿轮15×0.5
圆柱齿轮80×0.5
圆柱齿轮36×0.5
