PeterBee97/Gradesign/机械设计/翼后内角连接件.SLDPRT

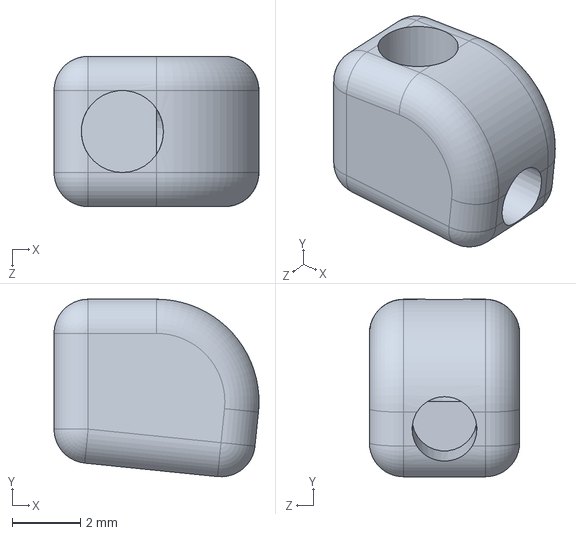
[picture p82: CAD file, 2020-05-10]
机械设计/翼后内角连接件.SLDPRT
6.00 x 5.20 x 4.40 mm
