PeterBee97/Gradesign/机械设计/圆柱齿轮25×0.2.SLDPRT

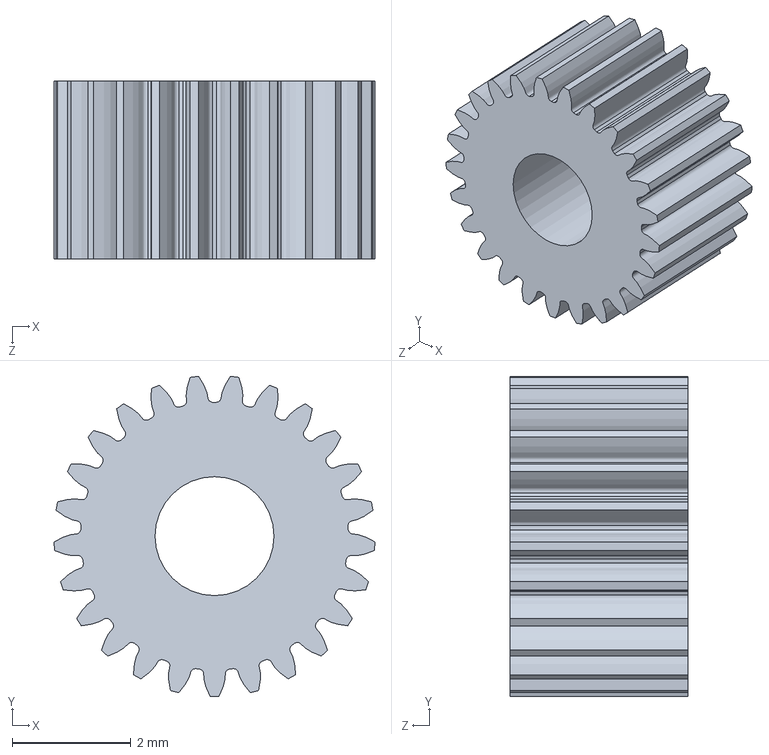
[picture p83: CAD file, 2020-05-10]
机械设计/圆柱齿轮25×0.2.SLDPRT
5.40 x 5.39 x 3.00 mm
