PeterBee97/Gradesign/机械设计/磁铁.SLDPRT

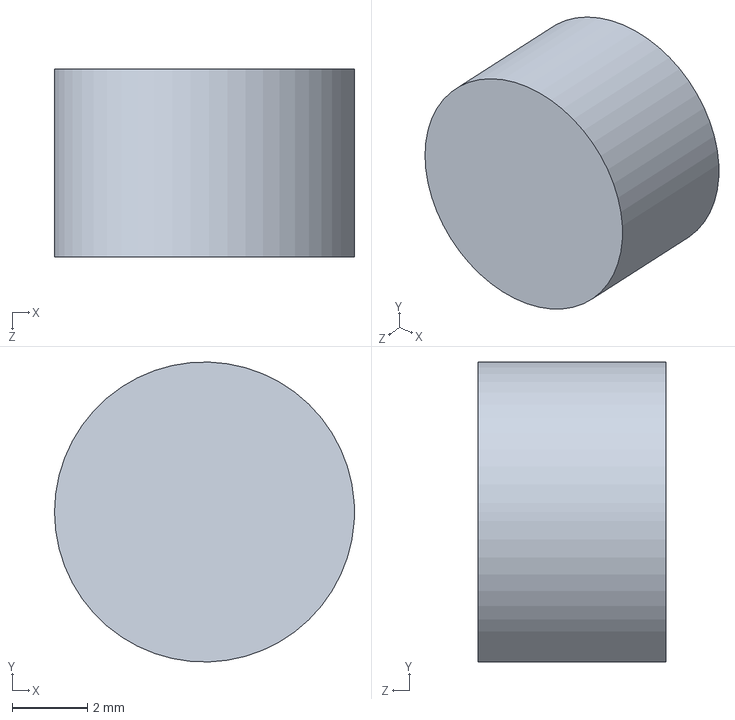
[picture p84: CAD file, 2020-05-10]
机械设计/磁铁.SLDPRT
8.00 x 8.00 x 5.00 mm
