PeterBee97/Gradesign/机械设计/连杆B.SLDPRT

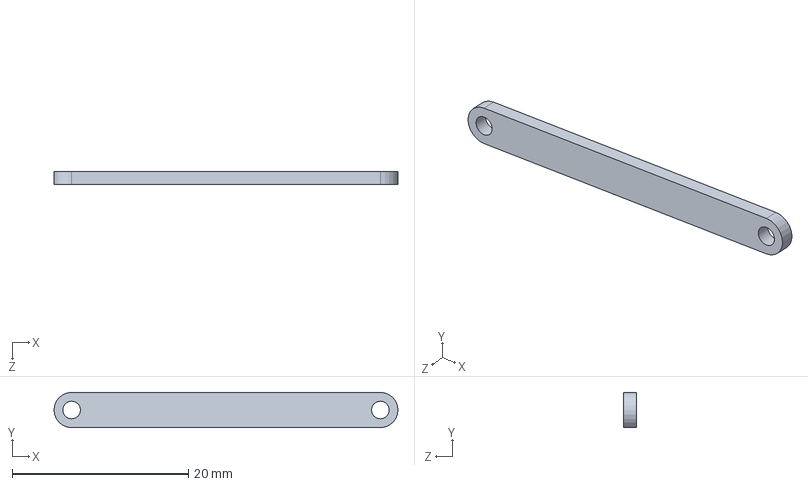
[picture p85: CAD file, 2020-05-10]
机械设计/连杆B.SLDPRT
39.0 x 4.00 x 1.50 mm
