PeterBee97/Gradesign/机械设计/连杆A.SLDPRT

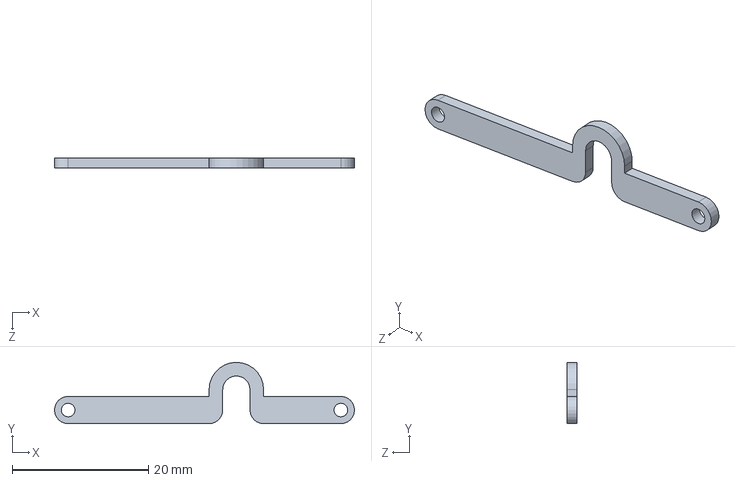
[picture p86: CAD file, 2020-05-10]
机械设计/连杆A.SLDPRT
44.0 x 9.00 x 1.50 mm
