PeterBee97/Gradesign/机械设计/磁铁轴承支架x9.DXF

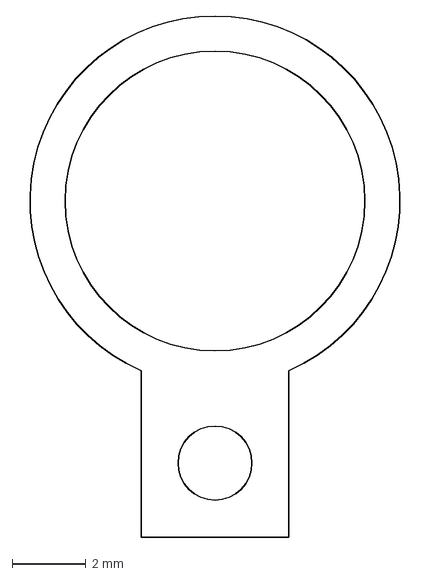
[picture p87: CAD file, 2020-05-10]
机械设计/磁铁轴承支架x9.DXF
10.8 x 14.1 mm
