PeterBee97/Gradesign/机械设计/延长杆2.SLDPRT

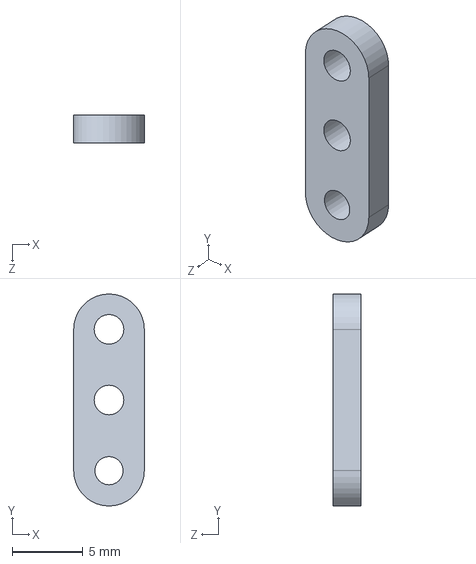
[picture p88: CAD file, 2020-05-10]
机械设计/延长杆2.SLDPRT
5.00 x 15.0 x 2.00 mm
