PeterBee97/Gradesign/机械设计/延长杆1.SLDPRT

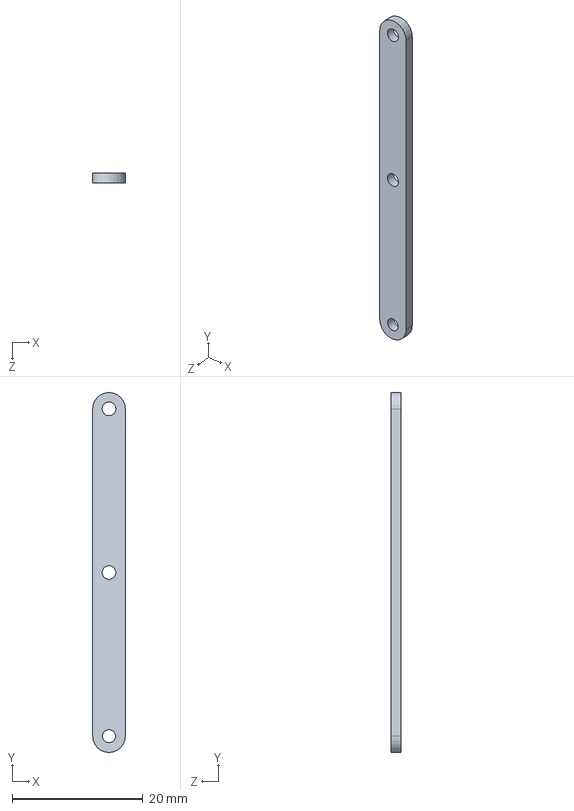
[picture p89: CAD file, 2020-05-10]
机械设计/延长杆1.SLDPRT
5.00 x 55.0 x 1.50 mm
