PeterBee97/Gradesign/机械设计/X2305电机.SLDPRT

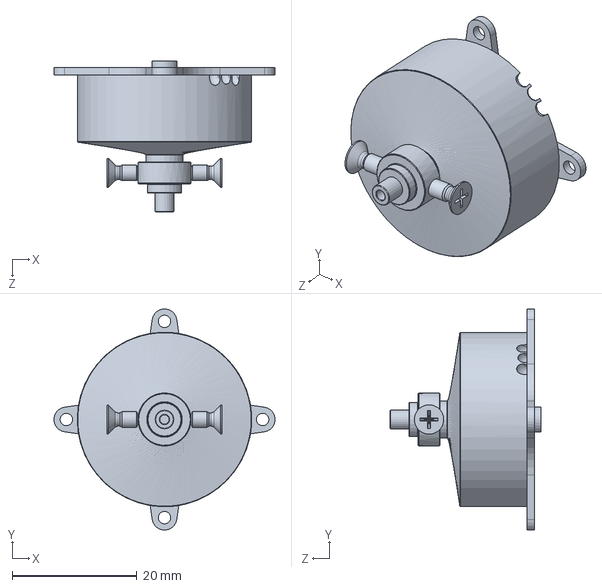
[picture p90: CAD file, 2020-05-10]
机械设计/X2305电机.SLDPRT
35.5 x 35.5 x 24.2 mm
