PeterBee97/Gradesign/机械设计/减速器.SLDPRT

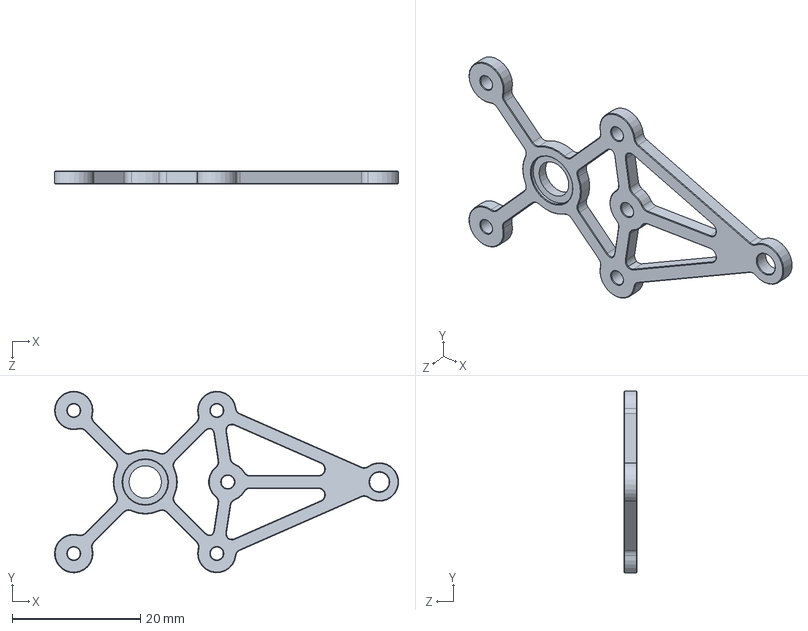
[picture p91: CAD file, 2020-05-10]
机械设计/减速器.SLDPRT
53.6 x 28.3 x 2.00 mm
