PeterBee97/Gradesign/机械设计/舵机齿轮25T.SLDPRT

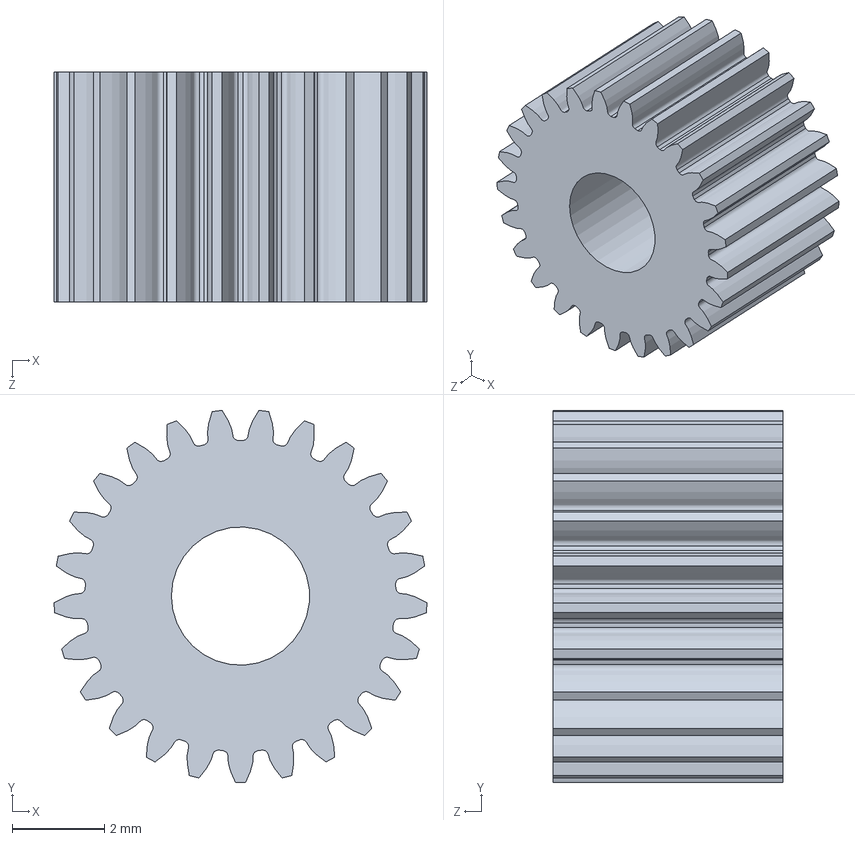
[picture p92: CAD file, 2020-05-10]
机械设计/舵机齿轮25T.SLDPRT
8.09 x 8.08 x 5.00 mm
