PeterBee97/Gradesign/机械设计/子板.SLDPRT

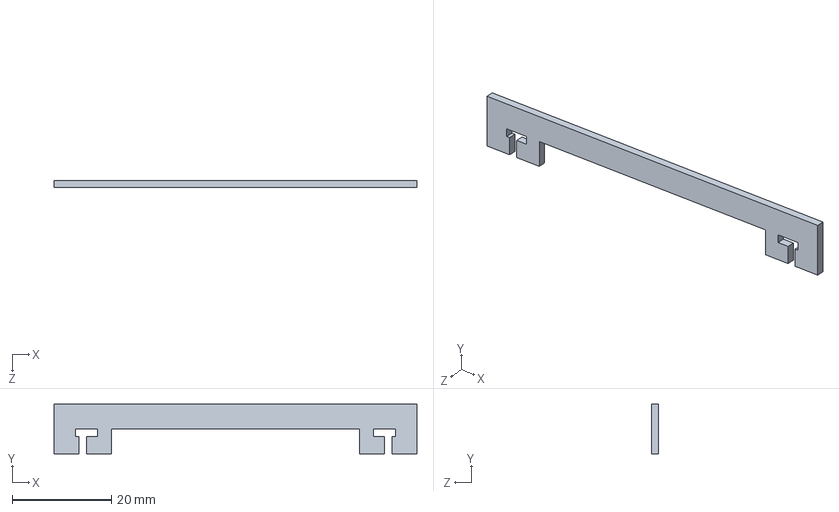
[picture p93: CAD file, 2020-05-10]
机械设计/子板.SLDPRT
73.1 x 10.0 x 1.50 mm
