PeterBee97/Gradesign/机械设计/Dimensions_NanoPi_Duo2_V1.0_1807_PCB.dxf

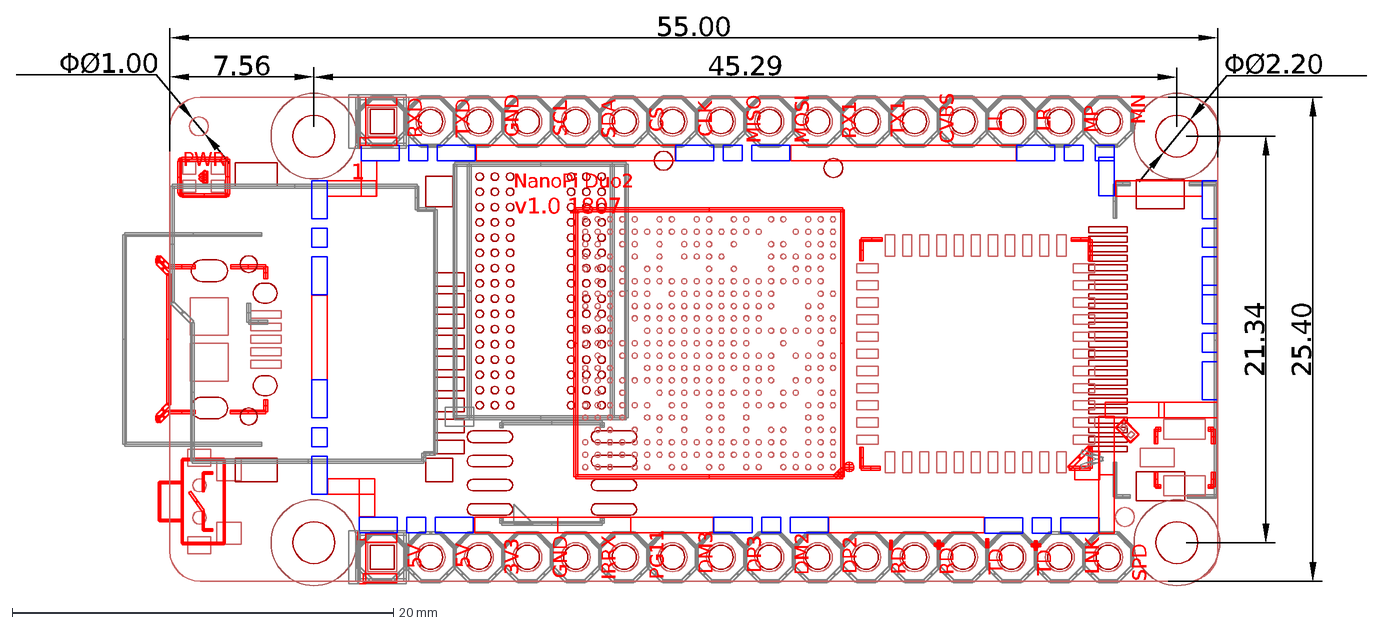
[picture p94: CAD file, 2020-05-10]
机械设计/Dimensions_NanoPi_Duo2_V1.0_1807_PCB.dxf
ΦØ2.20
ΦØ1.00
1
PWR
v1.0 1807
NanoPi Duo2
SPD
LNK
TD
RD
DP2
DM2
DP3
DM3
PG11
IRRX
3V3
5V
MN
MP
LR
LL
CVBS
TX1
RX1
MOSI
MISO
CLK
CS
SDA
SCL
GND
TXD
RXD
45.29
55.00
21.34
25.40
7.56
