PeterBee97/Gradesign/机械设计/小腿.SLDPRT

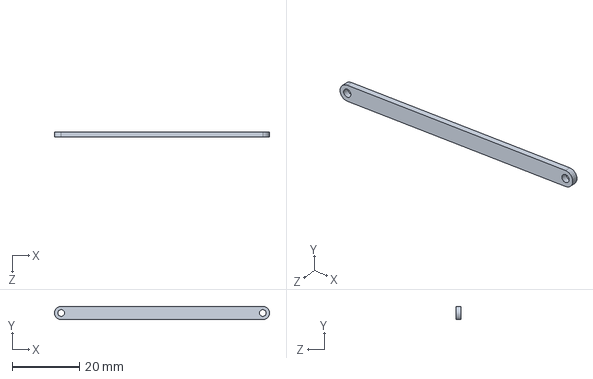
[picture p95: CAD file, 2020-05-10]
机械设计/小腿.SLDPRT
64.0 x 4.00 x 1.50 mm
