PeterBee97/Gradesign/机械设计/2x14.5杆.SLDPRT

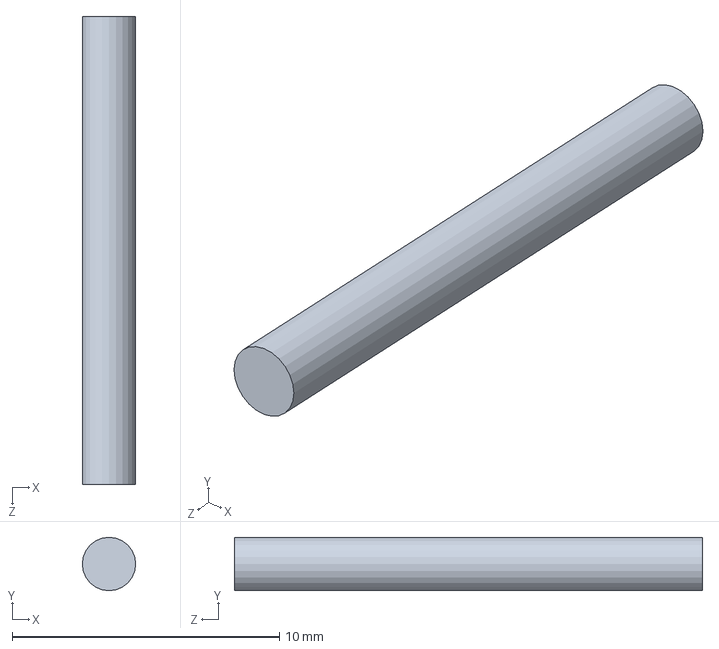
[picture p96: CAD file, 2020-05-10]
机械设计/2x14.5杆.SLDPRT
2.00 x 2.00 x 17.5 mm
