PeterBee97/Gradesign/机械设计/舵机臂.SLDPRT

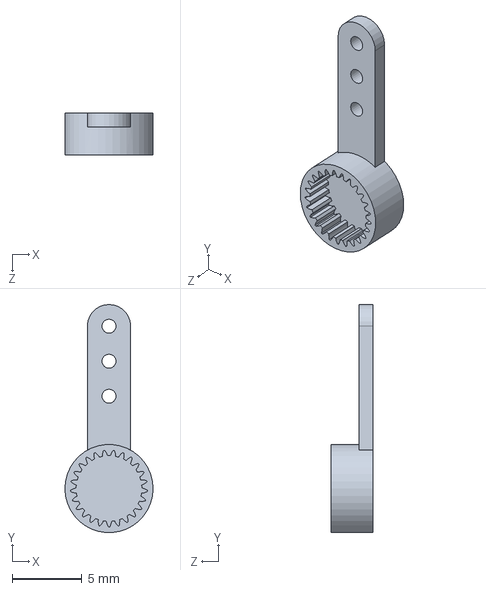
[picture p97: CAD file, 2020-05-10]
机械设计/舵机臂.SLDPRT
6.30 x 16.3 x 3.00 mm
