PeterBee97/Gradesign/机械设计/圆柱齿轮10×0.5.SLDPRT

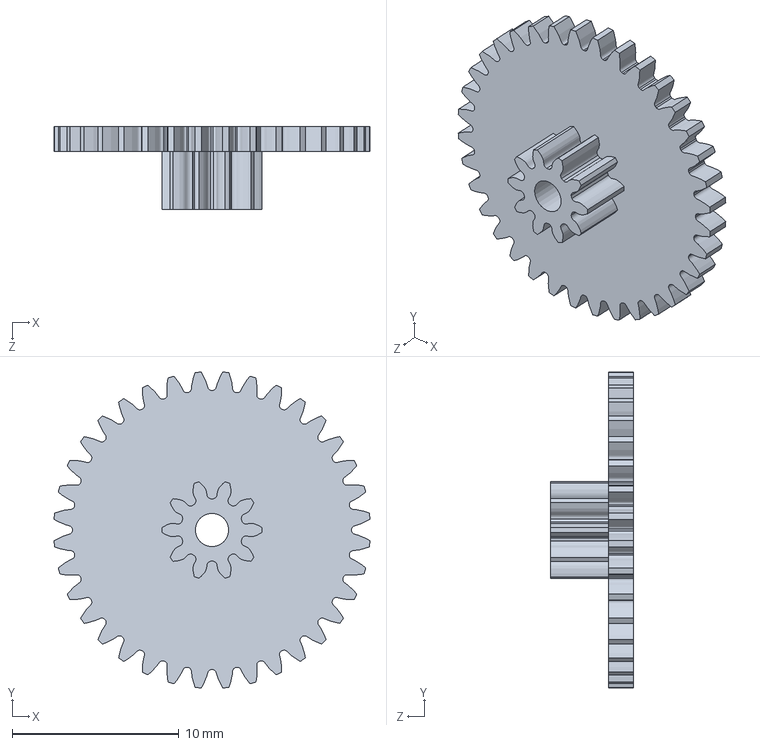
[picture p98: CAD file, 2020-05-10]
机械设计/圆柱齿轮10×0.5.SLDPRT
19.0 x 19.0 x 5.00 mm
