PeterBee97/Gradesign/机械设计/GB845-1985十字槽盘头自攻螺钉-C型ST2．2×4．5.SLDPRT

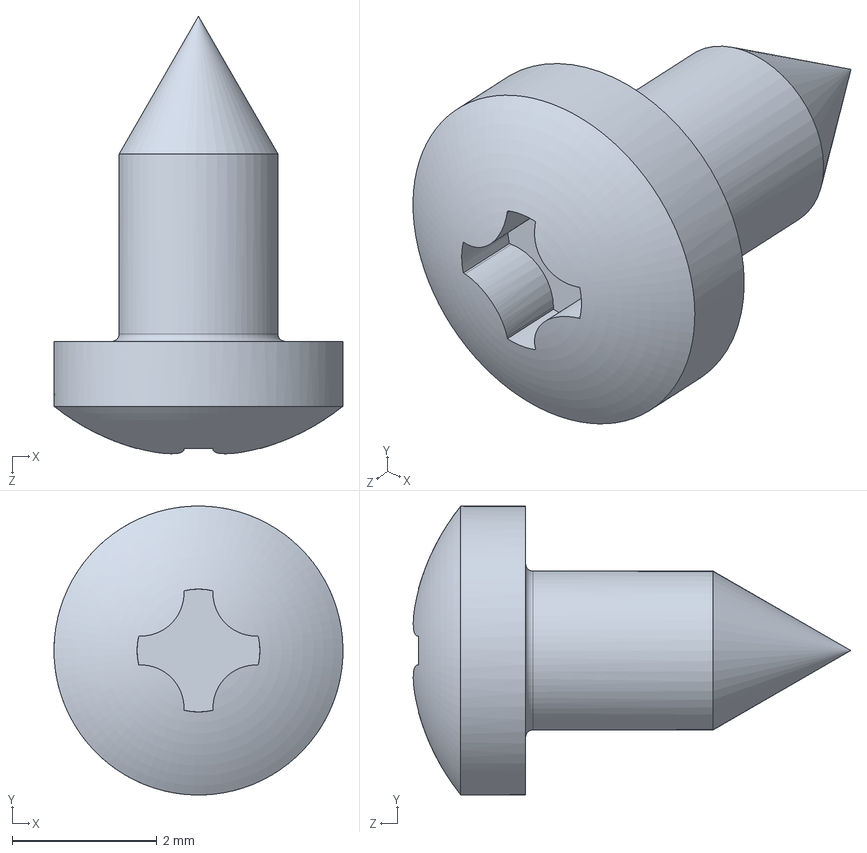
[picture p99: CAD file, 2020-05-10]
机械设计/GB845-1985十字槽盘头自攻螺钉-C型ST2．2×4．5.SLDPRT
4.00 x 4.00 x 6.06 mm
