PeterBee97/Gradesign/机械设计/短楔x4.DXF

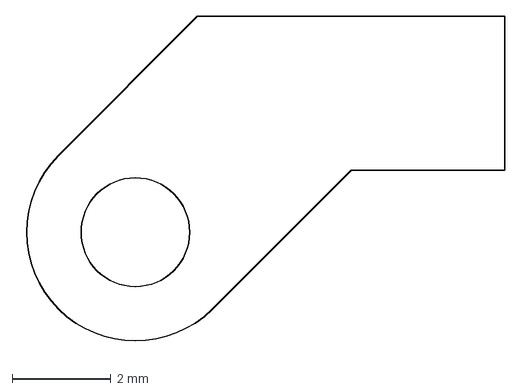
[picture p100: CAD file, 2020-05-10]
机械设计/短楔x4.DXF
9.89 x 6.78 mm
