PeterBee97/Gradesign/机械设计/2d_leg_sim_test.SLDPRT

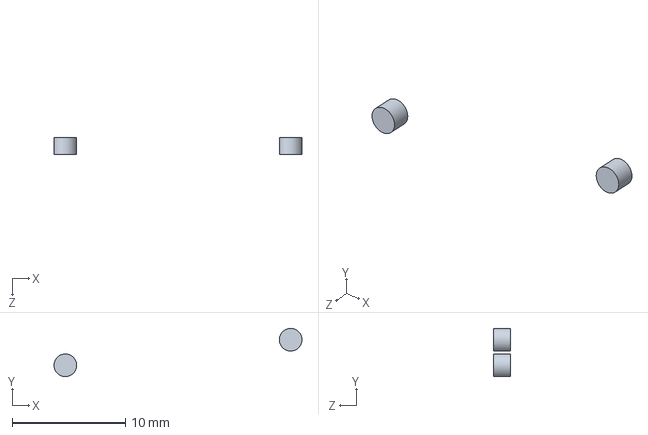
[picture p101: CAD file, 2020-05-10]
机械设计/2d_leg_sim_test.SLDPRT
21.9 x 4.25 x 1.50 mm
