PeterBee97/Gradesign/机械设计/磁铁轴承支架.SLDPRT

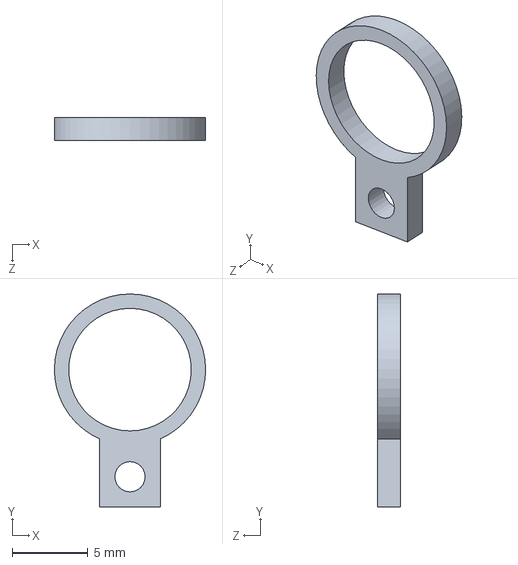
[picture p102: CAD file, 2020-05-10]
机械设计/磁铁轴承支架.SLDPRT
10.00 x 14.1 x 1.50 mm
