PeterBee97/Gradesign/机械设计/减速器2.STEP

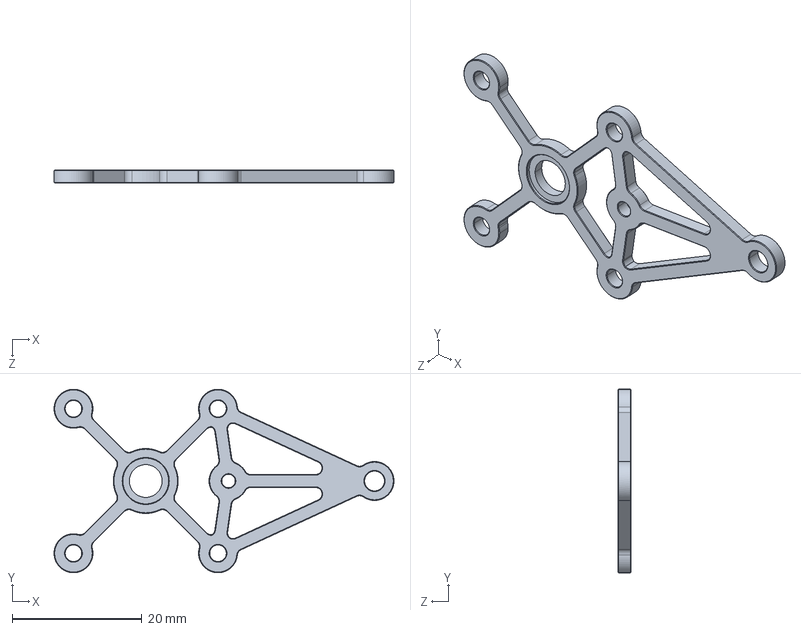
[picture p103: CAD file, 2020-05-10]
机械设计/减速器2.STEP
52.4 x 28.3 x 2.00 mm
