PeterBee97/Gradesign/机械设计/主板2.dxf

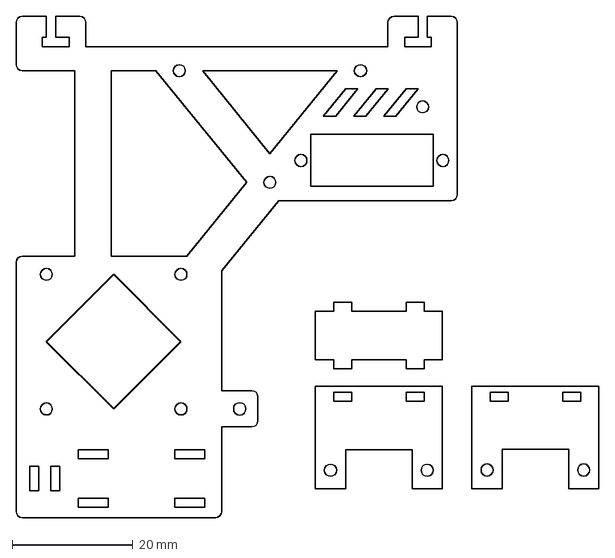
[picture p104: CAD file, 2020-05-10]
机械设计/主板2.dxf
96.4 x 83.0 mm
