PeterBee97/Gradesign/机械设计/机翼支架2.SLDPRT

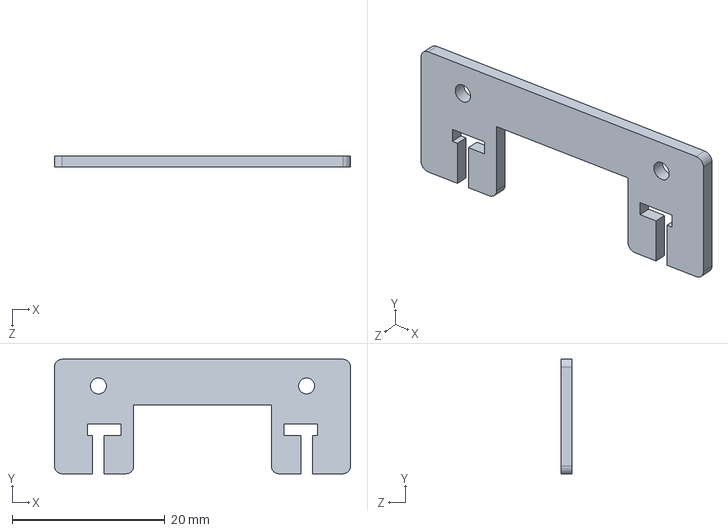
[picture p105: CAD file, 2020-05-10]
机械设计/机翼支架2.SLDPRT
38.7 x 15.0 x 1.50 mm
