PeterBee97/Gradesign/机械设计/翼后外角连接件.SLDPRT

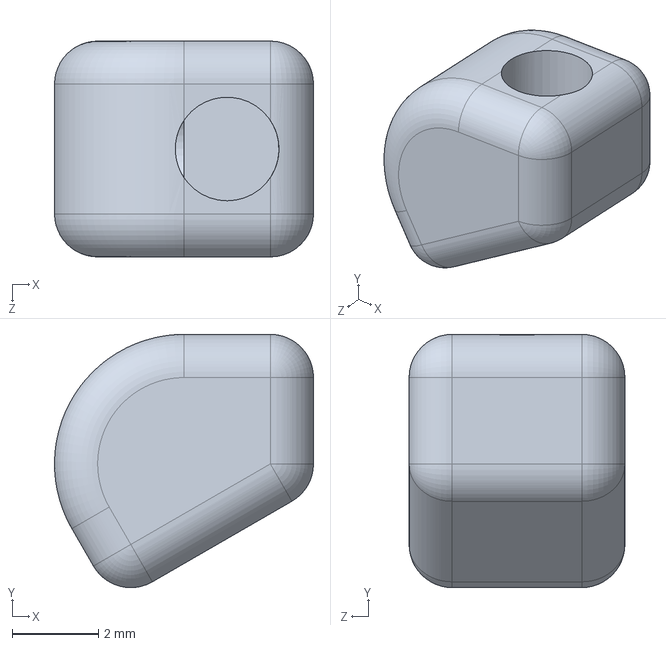
[picture p106: CAD file, 2020-05-10]
机械设计/翼后外角连接件.SLDPRT
6.00 x 5.87 x 5.00 mm
