PeterBee97/Gradesign/机械设计/翼侧连接件.SLDPRT

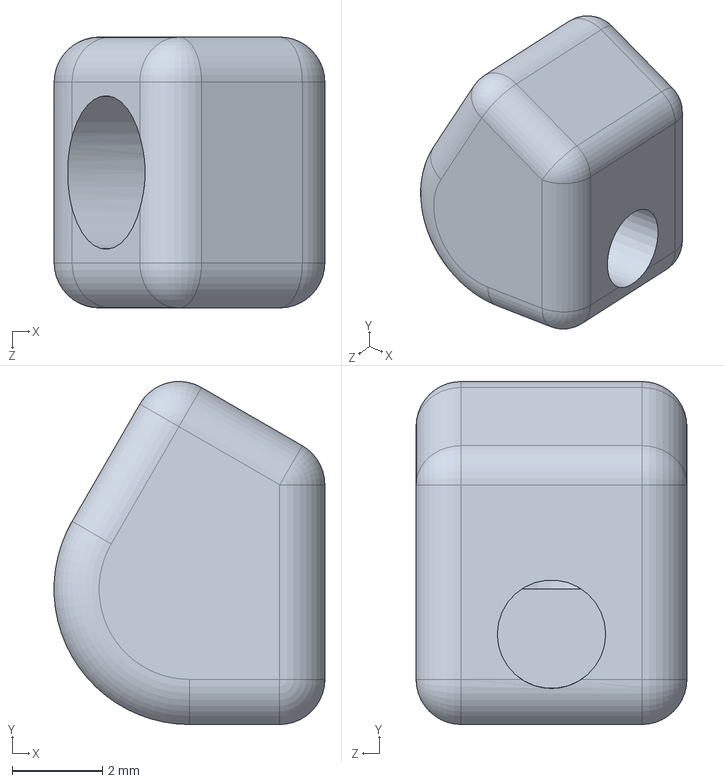
[picture p107: CAD file, 2020-05-10]
机械设计/翼侧连接件.SLDPRT
6.00 x 7.60 x 6.00 mm
