PeterBee97/Gradesign/机械设计/机翼.SLDPRT

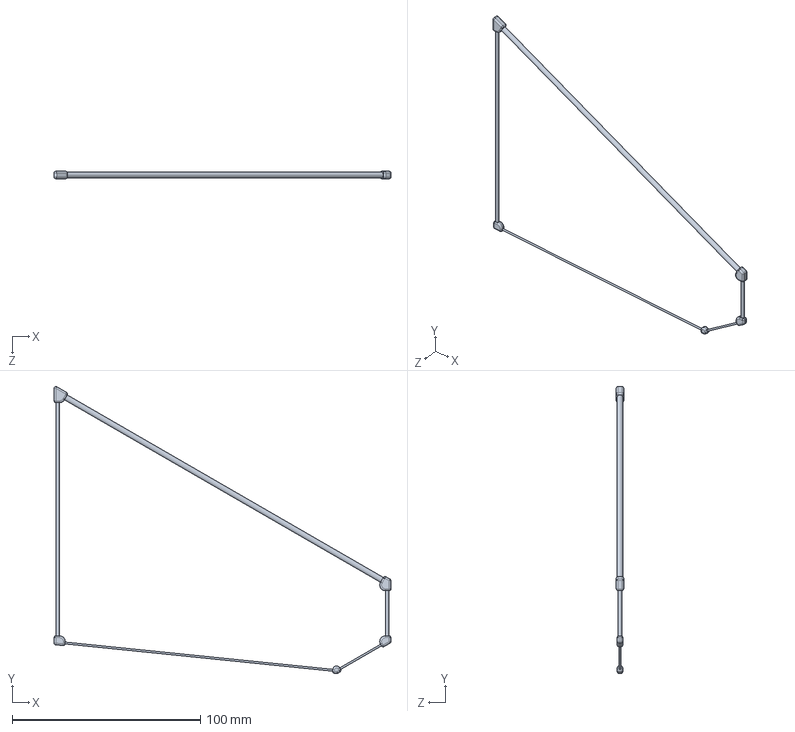
[picture p108: CAD file, 2020-05-10]
机械设计/机翼.SLDPRT
179.2 x 152.6 x 4.00 mm
