PeterBee97/Gradesign/机械设计/脚x3.DXF

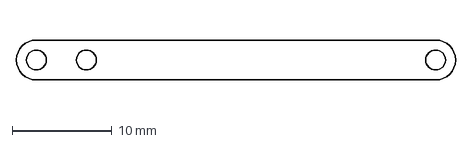
[picture p109: CAD file, 2020-05-10]
机械设计/脚x3.DXF
44.0 x 4.00 mm
