PeterBee97/Gradesign/机械设计/脚.SLDPRT

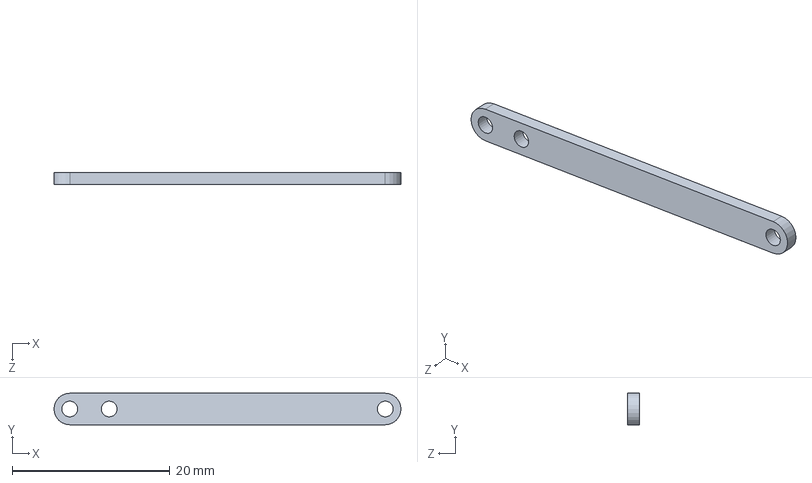
[picture p110: CAD file, 2020-05-10]
机械设计/脚.SLDPRT
44.0 x 4.00 x 1.50 mm
