PeterBee97/Gradesign/机械设计/短楔.SLDPRT

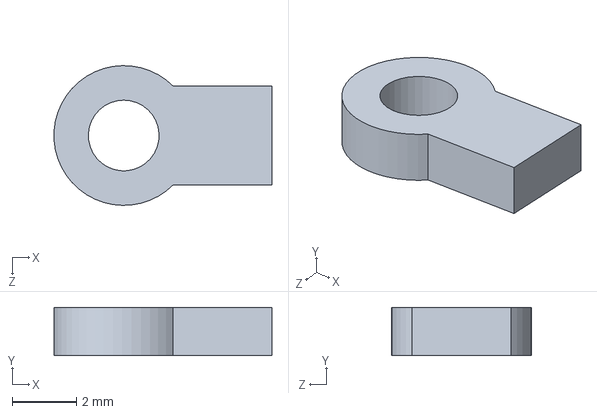
[picture p112: CAD file, 2020-05-10]
机械设计/短楔.SLDPRT
6.78 x 1.50 x 4.35 mm
