PeterBee97/Gradesign/机械设计/短楔2.SLDPRT

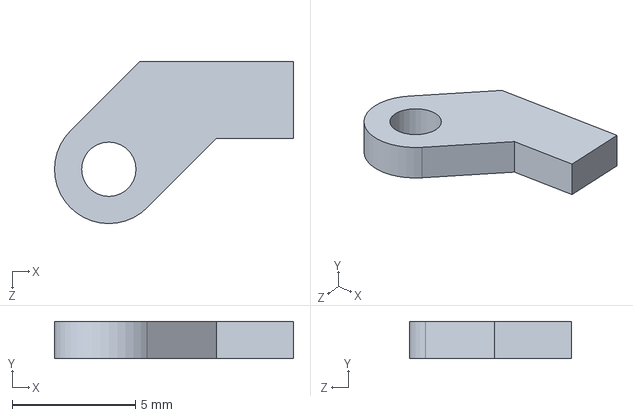
[picture p113: CAD file, 2020-05-10]
机械设计/短楔2.SLDPRT
9.68 x 1.50 x 6.57 mm
