PeterBee97/Gradesign/机械设计/翼前角连接件.SLDPRT

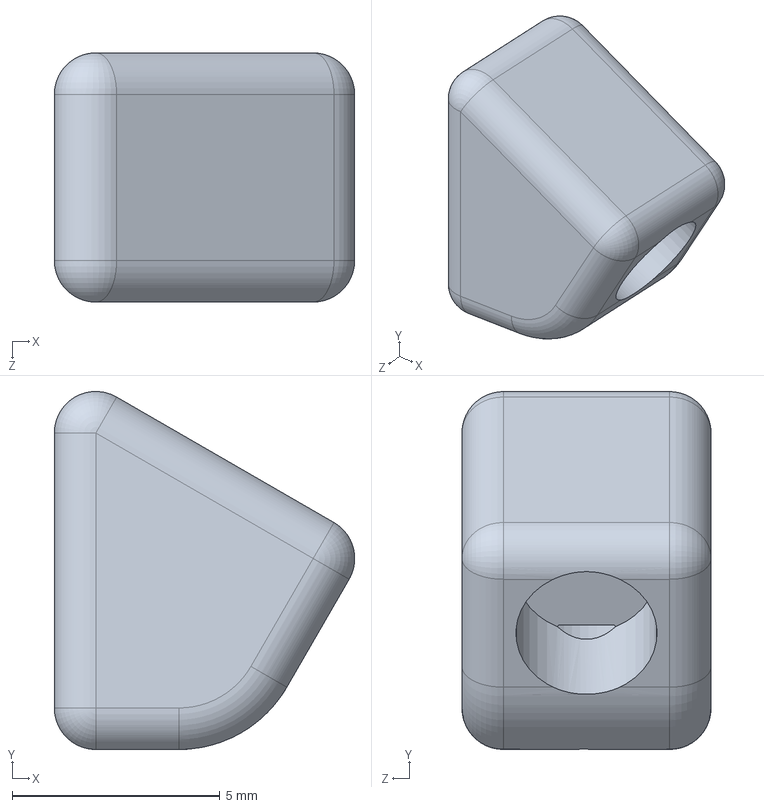
[picture p114: CAD file, 2020-05-10]
机械设计/翼前角连接件.SLDPRT
7.23 x 8.62 x 6.00 mm
