PeterBee97/Gradesign/机械设计/磁铁支架x2.DXF

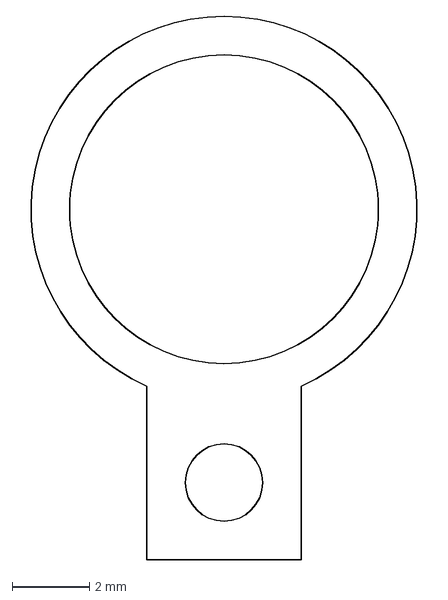
[picture p115: CAD file, 2020-05-10]
机械设计/磁铁支架x2.DXF
10.8 x 14.1 mm
