PeterBee97/Gradesign/机械设计/机翼接头.SLDPRT

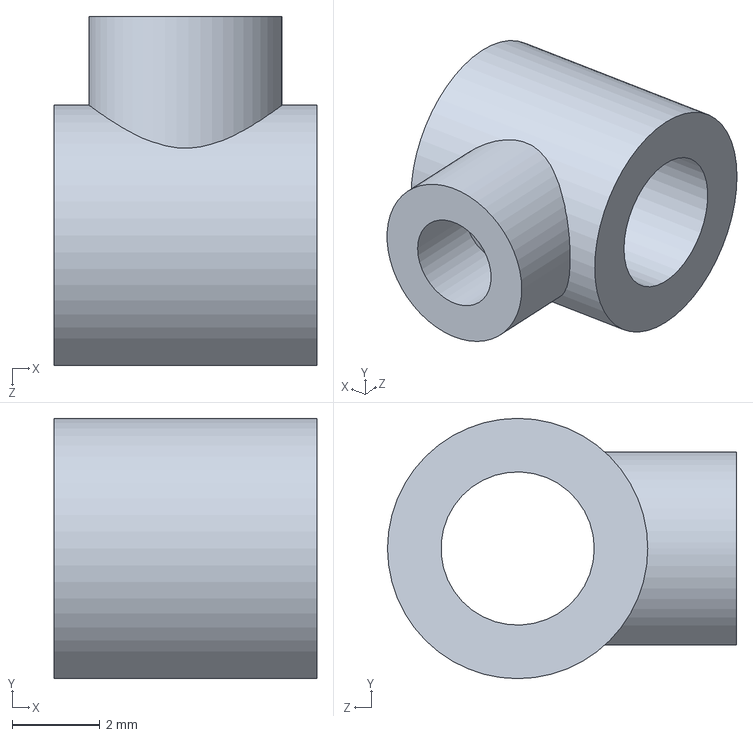
[picture p116: CAD file, 2020-05-10]
机械设计/机翼接头.SLDPRT
6.00 x 5.95 x 7.97 mm
