PeterBee97/Gradesign/机械设计/圆柱齿轮80×0.5.SLDPRT

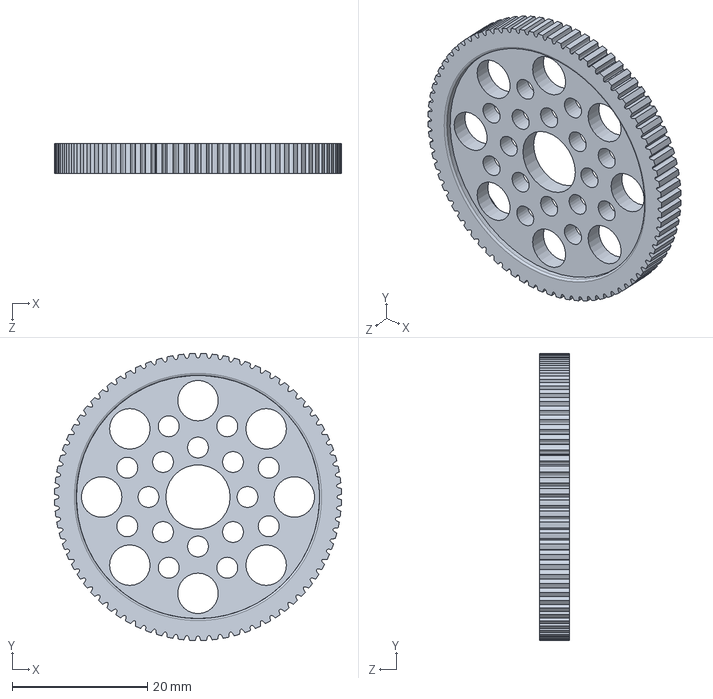
[picture p117: CAD file, 2020-05-10]
机械设计/圆柱齿轮80×0.5.SLDPRT
42.5 x 42.5 x 4.50 mm
