PeterBee97/Gradesign/机械设计/M2球头.SLDPRT

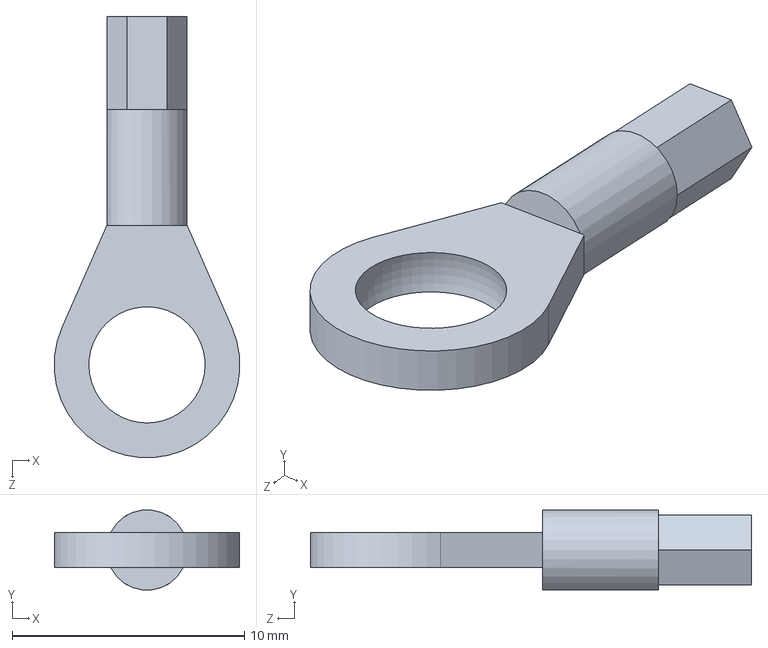
[picture p118: CAD file, 2020-05-10]
机械设计/M2球头.SLDPRT
7.98 x 3.44 x 19.0 mm
