PeterBee97/Gradesign/机械设计/机翼支架x2.DXF

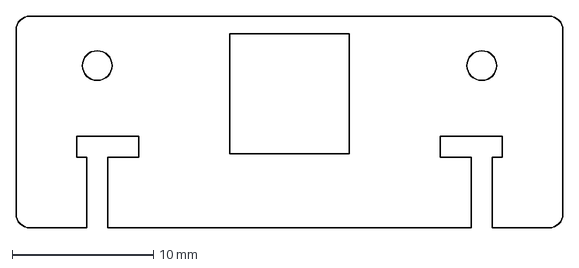
[picture p119: CAD file, 2020-05-10]
机械设计/机翼支架x2.DXF
38.7 x 15.0 mm
