PeterBee97/Gradesign/机械设计/挡片.dxf

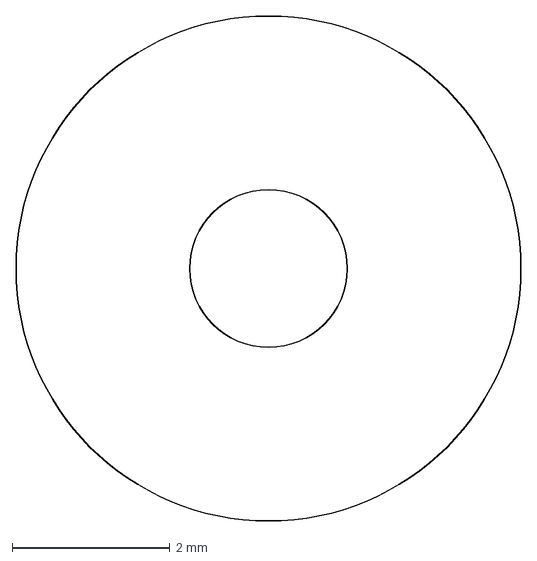
[picture p120: CAD file, 2020-05-10]
机械设计/挡片.dxf
6.40 x 6.40 mm
