PeterBee97/Gradesign/机械设计/长楔x4.DXF

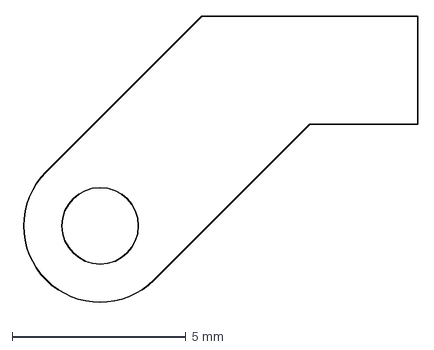
[picture p121: CAD file, 2020-05-10]
机械设计/长楔x4.DXF
11.6 x 8.45 mm
