PeterBee97/Gradesign/机械设计/GB／T819．1-2000十字槽沉头螺钉M2．5×5.SLDPRT

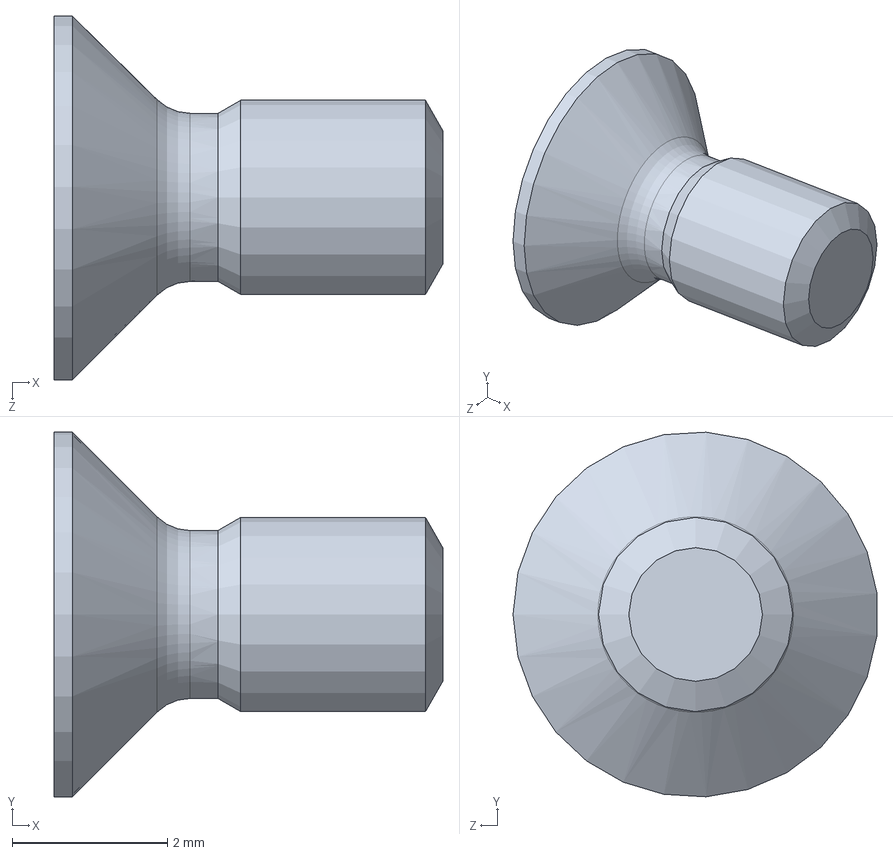
[picture p122: CAD file, 2020-05-10]
机械设计/GB／T819．1-2000十字槽沉头螺钉M2．5×5.SLDPRT
5.00 x 4.69 x 4.68 mm
