PeterBee97/Gradesign/机械设计/长楔2.dxf

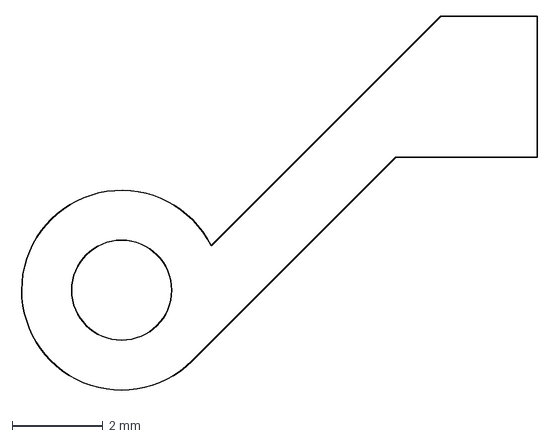
[picture p123: CAD file, 2020-05-10]
机械设计/长楔2.dxf
11.5 x 8.43 mm
