PeterBee97/Gradesign/机械设计/曲柄块.SLDPRT

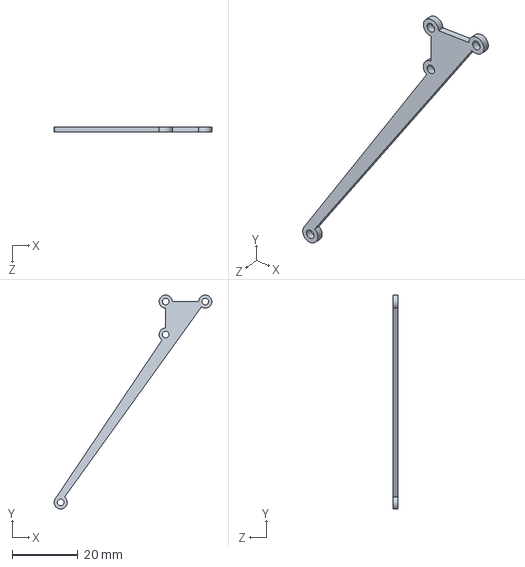
[picture p124: CAD file, 2020-05-10]
机械设计/曲柄块.SLDPRT
47.8 x 64.9 x 1.50 mm
