PeterBee97/Gradesign/机械设计/翼后侧连接件.SLDPRT

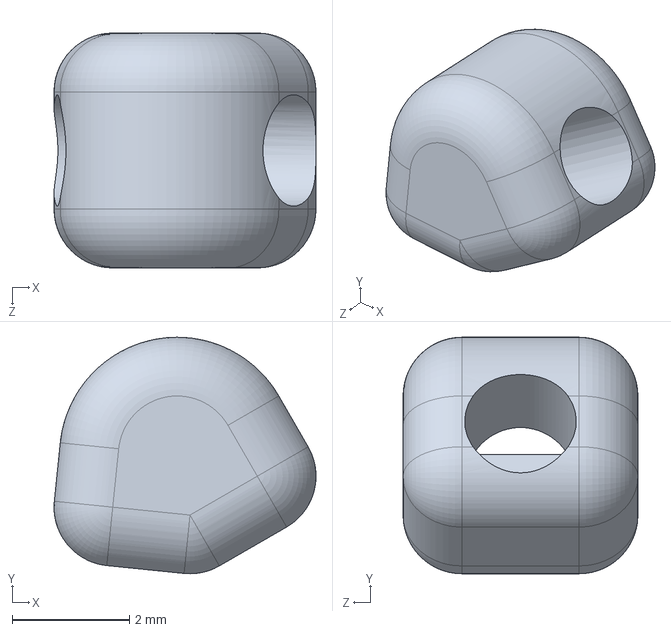
[picture p125: CAD file, 2020-05-10]
机械设计/翼后侧连接件.SLDPRT
4.46 x 4.03 x 4.00 mm
