PeterBee97/Gradesign/机械设计/主板.SLDPRT

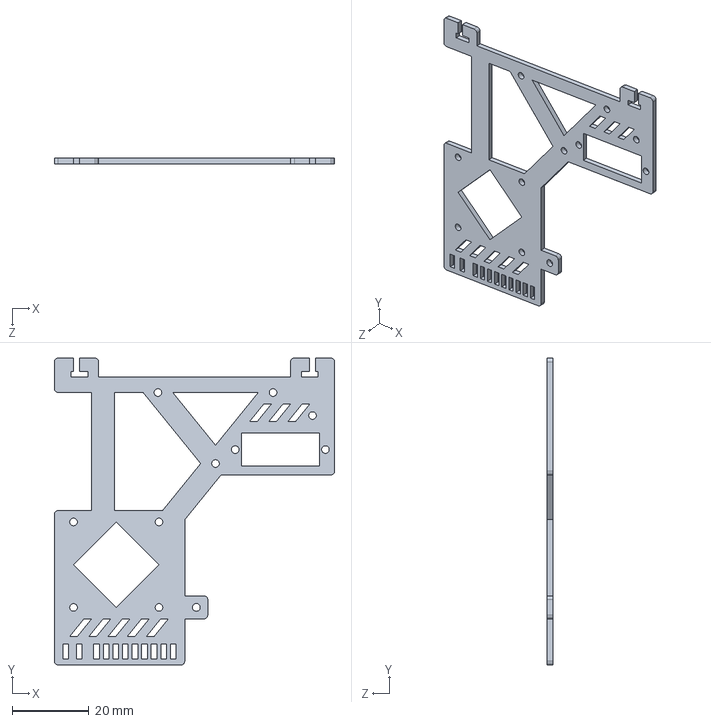
[picture p126: CAD file, 2020-05-10]
机械设计/主板.SLDPRT
73.0 x 80.0 x 1.50 mm
