PeterBee97/Gradesign/机械设计/长楔.SLDPRT

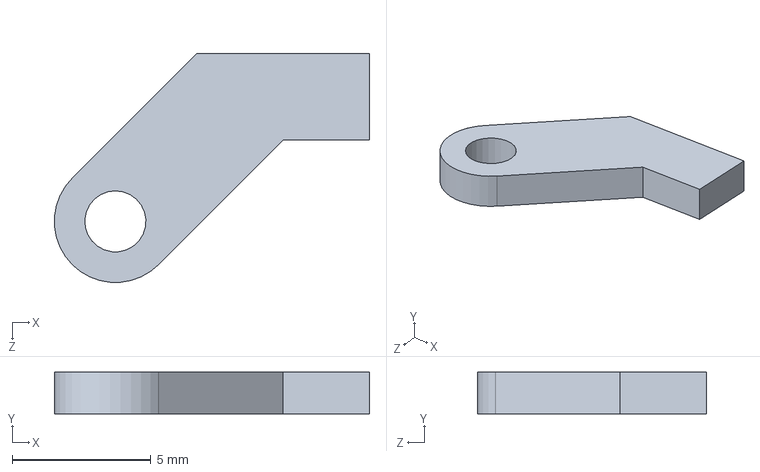
[picture p127: CAD file, 2020-05-10]
机械设计/长楔.SLDPRT
11.3 x 1.50 x 8.23 mm
