PeterBee97/Gradesign/机械设计/摇臂.SLDPRT

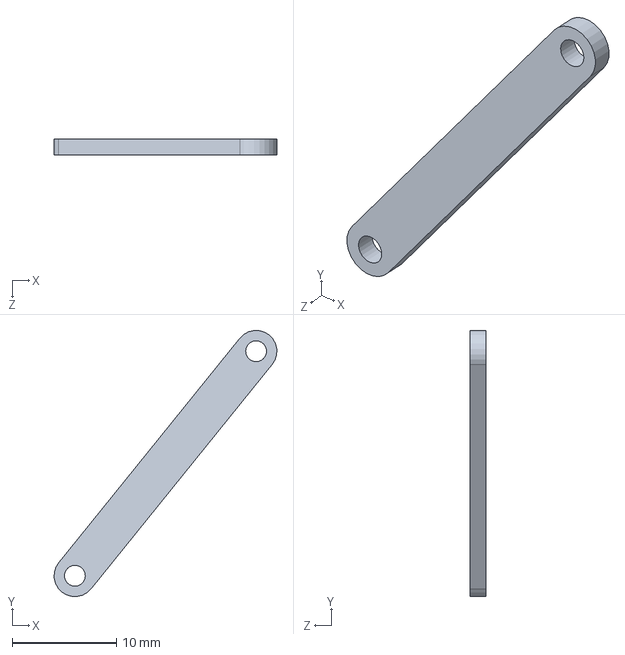
[picture p128: CAD file, 2020-05-10]
机械设计/摇臂.SLDPRT
21.4 x 25.5 x 1.50 mm
