PeterBee97/Gradesign/机械设计/圆柱齿轮15×0.5.SLDPRT

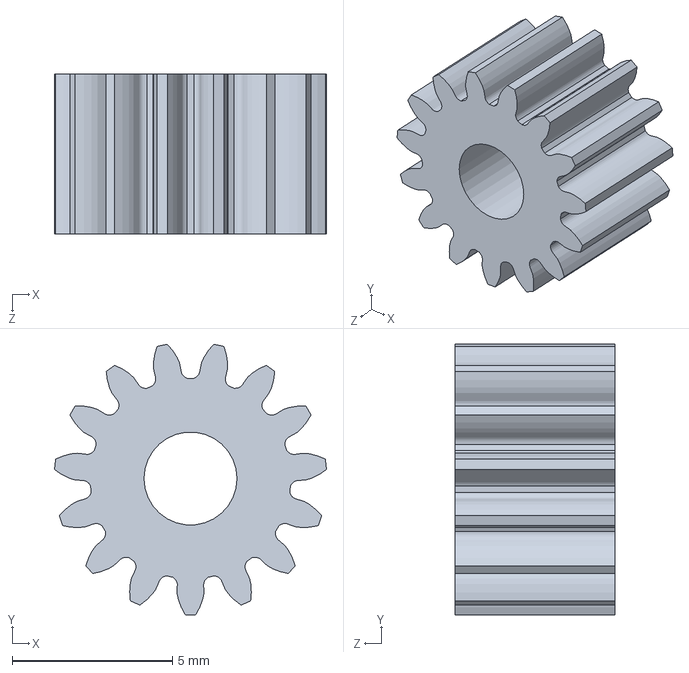
[picture p129: CAD file, 2020-05-10]
机械设计/圆柱齿轮15×0.5.SLDPRT
8.48 x 8.43 x 5.00 mm
