PeterBee97/Gradesign/机械设计/圆柱齿轮36×0.5.SLDPRT

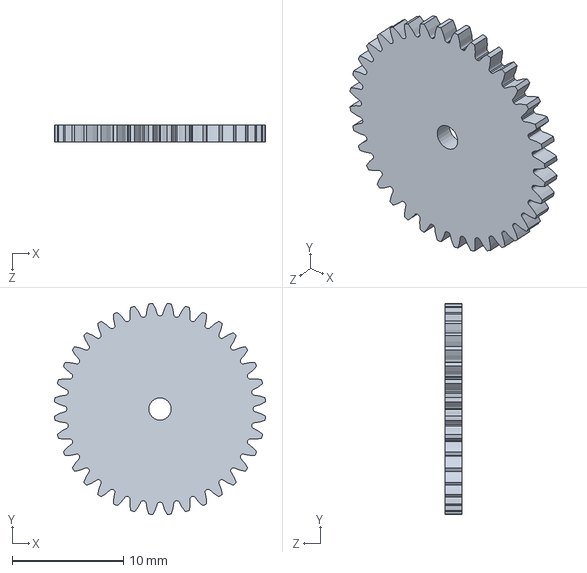
[picture p130: CAD file, 2020-05-10]
机械设计/圆柱齿轮36×0.5.SLDPRT
19.0 x 19.0 x 1.50 mm
