PeterBee97/Gradesign/机械设计/4.3g舵机.SLDPRT

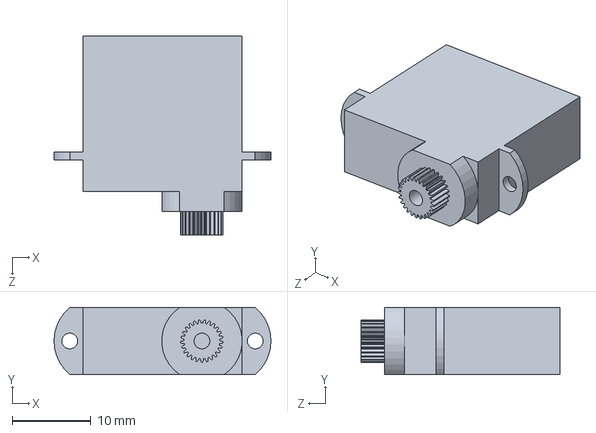
[picture p131: CAD file, 2020-05-10]
机械设计/4.3g舵机.SLDPRT
27.5 x 8.50 x 25.2 mm
