PeterBee97/Gradesign/机械设计/nanopi_duo2.SLDPRT

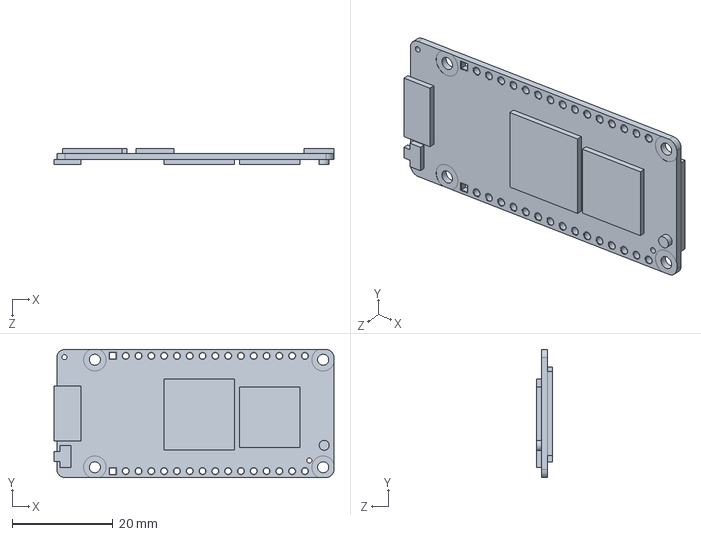
[picture p132: CAD file, 2020-05-10]
机械设计/nanopi_duo2.SLDPRT
55.5 x 25.4 x 3.20 mm
