PeterBee97/Gradesign/(list of files, cad)

Other CAD files:
机械设计/2d_leg_sim.SLDPRT
机械设计/减速器3.STEP
机械设计/总板2.dwg
机械设计/减速器4.STEP
机械设计/磁铁支架.SLDPRT
机械设计/总板.dwg
机械设计/大腿.SLDPRT
机械设计/795532117DJFLY-DG.step
机械设计/主板.DXF
机械设计/减速器 - 副本.SLDPRT
机械设计/大腿.DXF
机械设计/子板.DXF
机械设计/小腿.DXF
机械设计/延长杆1.DXF
机械设计/延长杆2.dxf
机械设计/摇臂.DXF
机械设计/曲柄块.DXF
机械设计/机翼接头.STL
机械设计/机翼支架2.DXF
机械设计/翼侧连接件.STL
机械设计/翼前角连接件.STL
机械设计/翼后侧连接件.STL
机械设计/翼后内角连接件.STL
机械设计/翼后外角连接件.STL
机械设计/连杆A.DXF
机械设计/连杆B.DXF
