PeterBee97/Gradesign/毕业论文/thuthesis-v6.0.2/figures/body_assembled.png

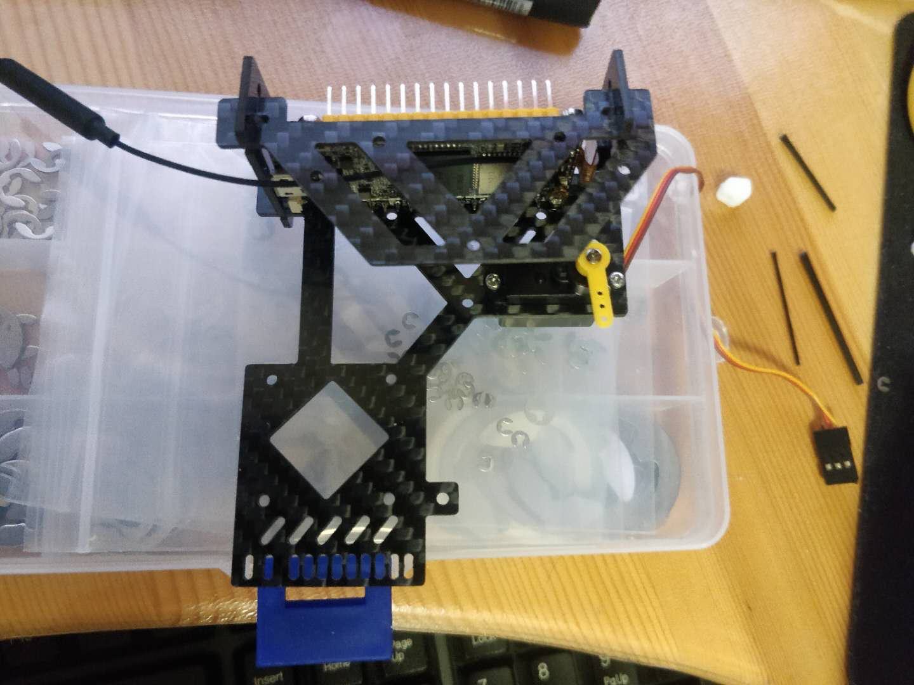
毕业论文/thuthesis-v6.0.2/figures/body_assembled.png
