PeterBee97/Gradesign/(list of files, drawings)

Other design files:
电路设计/FOC电路图/795484912NUCLEO-DG_V3.SchDoc
电路设计/FOC电路图/795492740IHM08M1-DG_V4.PcbDoc
电路设计/FOC电路图/795494688IHM08M1-DG_V4.SchDoc
电路设计/FOC电路图/795498646NUCLEO-DG_V3_ST_LINK_V2-1.SCHDOC
电路设计/FOC电路图/795506519DJFLY-DG.SchDoc
电路设计/FOC电路图/795532117DJFLY-DG.PcbDoc
电路设计/FOC电路图/795540071NUCLEO-DG_V3.PcbDoc
